josearistidesbail/FE_UFPR_4_0/OPEN_ITEMS.md

# FE_UFPR v4.0 — Open items

Owner in brackets. **When an item is resolved, move it to the Resolved section** (struck through,
one line saying how and in which session) and log the decision in `DECISION_LOG.md`.
Keep the Open section short enough to read every session.

## Open

- ~~[user, NEXT — blocks the fab] Rebuild `fab/` after the 2026-09-24 re-route.~~ — **done 2026-09-24 (`make_package.sh` with KiCad closed: 16 gerber/drill files, CPL 278 parts on origin 96.0,219.9, U1 +31.95 mm in x as expected, JLC stock report unchanged apart from the DT15 lines).** Still open from it: the S12 CPL-rotation preview check, retag, and **review the routed left strip in pcbnew** (branch `dt15-vertical`; the user's first look on 2026-09-24: "looks pretty good"; trace lengths reviewed in `DECISION_LOG.md`): the B.Cu lanes at y 94–98 carry CAN + the 4 switch nets + 5V_VEH under the top edge, the LEM signals run at y 183–190 on F.Cu, ±15 V on B.Cu/F.Cu — DRC-clean but hand-placed by script, not by eye.
- ~~[user, NEXT — blocks the fab] Re-place and re-route J3/J4/J5 after the 2026-09-23 DT15 swap.~~ — **done 2026-09-24 (branch `dt15-vertical`, `DECISION_LOG.md`): board 178 × 130, DRC 0/0/0 + 5 by-design silk.** Original text: **[user, NEXT — blocks the fab] Re-place and re-route J3/J4/J5 after the 2026-09-23 DT15 swap.** The three vertical footprints were dropped at the old right-angle positions/rotations (J3 158.5/169.8 −90°, J4 158.5/124.0 −90°, J5 167.45/96.25 180°): DRC 653 / 18 unconnected / 18 dangling tracks, every one of them from these three. Constraints: body = flange outline 35.26 × 59.21 (J3/J4) / 35.26 × 55.12 (J5) on the board, flange face 15.5 mm up (nothing taller than ~13 mm under it), pins Ø1.57 on 4.445 × 9.12, 4× Ø3.5 NPTH per part for #4-20 Plastite screws driven from the **underside** — heads land on B.Cu inside the footprint's B.CrtYd Ø7.5 circles (keep copper and the 12 B.Cu parts out of them). Pin 1 = bottom-left of the mating face, key end = −y. Then DRC 0, `sh tools/fab/make_package.sh`, retag — the committed `fab/` and `v4.0-fab-candidate` are **stale**.
- **[user, BEFORE FIRST POWER-ON + rev 4.1] F1→Q1 drain link is one 0.25 mm track (found 2026-11-02).** `/power/PWR_24V_FUSED` (F1 pad 2 → Q1 tab) matches no netclass pattern, so it fell to Default and was routed at 0.25 mm (≈2.3 mm exposed between the pads); DRC passes because Default allows it. It carries the whole 24 V input (≈2 A with the module aux at 40 W); short and pad-sunk, so it should survive normal load, but under a fault it may open before F1 (5 A). **Boards in hand:** solder a ≈0.8 mm bare wire (resistor-leg offcut) from F1 pad 2 to the Q1 tab over the track. **Rev 4.1:** add `*PWR_24V_FUSED` to Power_3A and re-route; audit every net in series with a fuse or the 24 V path for the same netclass gap. (The other `/power/PWR_*` nets at 0.25 mm are signal/bias nets — fine.)
- **[user, BEFORE FITTING THE LAUNCHPAD + rev 4.1] D12 (SS34, `+5V` → `+5V_LP`) is drawn backwards (found 2026-11-03 at bring-up A, back-feed test).** Netlist: D12 pin 1 **K → `+5V`**, pin 2 **A → `+5V_LP`**, so the diode conducts LaunchPad → board and blocks board → LaunchPad. Opposite to `ARCHITECTURE.md` §3. JLC placed it exactly as drawn (not an assembly error); the wrong orientation has been in `golden.net` since S8 (the `S8_INTEGRATION_DESIGN.md` net table lists `D12.2` on `+5V_LP`), so the netlist gate could never catch it. Consequences: the board cannot power the LaunchPad, and a LaunchPad with USB 5 V on its target side (JP3 fitted) back-feeds the board `+5V` (D6/D7 light, U3 makes +3V3, and U2's output is driven backwards). A TP45 reading of ≈ 5 V with 24 V on is reverse leakage into C114/C115, not power. D16 (`+5V_VEH`) is the right way round. **Boards in hand** (board 1 done 2026-11-03, diode check passed; board 2 pending): desolder D12 and refit it rotated 180°: cathode band on **pad 2 / `+5V_LP`** (opposite the silk band). Check unpowered: diode mode, red TP3 → black TP45 ≈ 0.2–0.35 V, reversed = open. Then repeat the back-feed test with LaunchPad JP1/JP2/JP3 **out**. **Rev 4.1:** flip D12 in the `launchpad` sheet (A → `+5V`, K → `+5V_LP`), regenerate `golden.net`, check the silk band; audit every other polarised part's net direction against its design note (a netlist diff cannot see this class of error).
- **[user, BEFORE RUNNING THE LAUNCHPAD FROM THE BOARD + rev 4.1] The board never supplies the LaunchPad's 3.3 V (found 2026-11-03 at bring-up A).** `ARCHITECTURE.md` §3 assumed the LaunchPad "makes its own 3.3 V from our 5 V (its TPS7B LDO)". SPRUI77 Fig. 3/4 show it doesn't: the target side has no 5 V → 3.3 V regulator. U17 TPS62162 makes `FTDI_3V3` from USB on the debugger side, JP1 is the only link to the target `+3V3`, and U12 LMR62421 boosts 3.3 → 5 V (JP6), not the reverse. The board feeds only `+5V_LP` and leaves J1-1 / J5-41 (3V3) unconnected (J20.1, J22.1), so with JP1–JP3 out the MCU rail sat at 2.2 V, back-powered through its I/O protection diodes from the board's 3.3 V logic. Brown-out: D1 and D9 lit, no code running. **Bench workaround (no isolation, DB37 unplugged only):** JP1 + JP2 in, JP3 out → target 3.3 V from USB, 5 V from the board via D12. **Boards in hand** (board 1 done 2026-11-03: wire fitted, LaunchPad JP1–JP3 out, boots from 24 V with USB isolated; U3 current and temperature not yet logged; board 2 pending): wire U3 output tab (`+3V3`) → J20 pin 1 (underside; = LaunchPad J1-1), AWG 24–26, ≈ 80 mm; then JP1–JP3 out. With JP1 out nothing is paralleled. U3 then carries ≈ 0.15 A board + 0.2–0.3 A LaunchPad (≈ 0.7–0.8 W in the SOT-223): measure the current and U3's temperature. ⚠ The wire also wakes the LaunchPad's U12 boost (it runs whenever the target 3.3 V is up), the lead suspect for the ADC interference item below. **Rev 4.1:** tie J20.1 to `+3V3` in the `launchpad` sheet; redo the `+3V3` budget (`S3_POWER_DESIGN.md` table: 0.15 A) and U3's thermal design (or a small buck); correct `ARCHITECTURE.md` §3 and the S8 "explicit no-connect" note on J1-1 / J5-41. The 2026-11-03 polarity audit (D12 the only wrong part) took the §3 premise as given, so it didn't check this.
- **[user, BEFORE USING THE INTERNAL CURRENT SENSORS + rev 4.1] The module's current outputs read 0 V at zero current, not 2.5 V (bench item #3, found 2026-11-03 at bring-up E).** Board 1, module powered from the board (0.57 A at 24 V, module LED on), no DC link: DB37 pins 30/31/32 (at C64/C70/C77) and TP30/TP32/TP34 all 0 V, while the module's other analog outputs are alive (Vbus floor 0.12 V on pin 7, NTC 0.62 V on pin 29). S6 assumed a 2.5 V bias (`S6_CURRENT_SENSE_DESIGN.md` §3–§4: bottom of the + divider at GND, gain 0.600); the datasheet gives none. As built, the internal path clips every negative half and is **unusable for control**. No damage either way (op-amp inputs current-limited by 7.5 kΩ, outputs clip at 0 V). Still unknown: bipolar vs one-sided (magnitude/RMS), scale, sign, and each channel's mV offset (not read). **Now:** run step F on the LEM path (JP3–JP5 → 2-3, firmware `ISENSE_V_PER_A_LEM`) and scope DB37 30–32 against the LEMs. **Rework, only if the outputs prove bipolar and instantaneous, per channel:** lift the GND end of the bottom resistor and wire it to `ISNS_VREF` (output centred on 1.4685 V), and swap both 20.0 k input resistors for a matched pair ≈ 40.2 k 0.1 % (gain 0.600 → 0.299: ±4.9 V → 0.01–2.93 V; the 12 k × 2.2 nF feedback pole stays ≈ 6 kHz, no capacitor change). A: R66 (pad 2 = GND) → TP36 or R73's `ISNS_VREF` end, swap R63/R64. B: R79 → R85's `ISNS_VREF` end, swap R75/R78. C: R91 → R97's `ISNS_VREF` end, swap R87/R90. Tune the 40.2 k from the measured scale. Side effects: a disconnected DB37 then reads the bias (as the LEM path does), ≈ 0.2 mA more on U15A. If the outputs are one-sided, no resistor change recovers the sign: internal = monitoring only. **Rev 4.1:** the same change in the schematic (bottom resistor to `ISNS_VREF`, gain from the measured scale); update `S12_FIRMWARE_HANDOFF.md` §6.
- **[rev 4.1] No clamp diodes on `ISNS_A/B/C_ADC`.** U12–U14 run from +5 V, so a stage fault can drive an ADC pin to 5 V through 100 Ω (≈ 11 mA into the MCU pin's ESD diode, rated 2 mA). It happened on board 1 at bring-up E (a U13 joint held `ISNS_B` at 3.5 V, harmless at that level). Add a BAT54S to `+3V3`/GND on each, as D10/D11/D18 do for the encoder and KTY channels.
- **[user, board 2 — and the rest of board 1] Hand-soldered IC joints.** Board 1 had two open GND joints that looked soldered: U6 pin 3 (bring-up B, TP12/TP13 at 1.86 V) and U16 pin 4 (bring-up E, SIN/COS stuck at the clamp). Also a U13 joint (`ISNS_B` stuck at 3.5 V), U16/U17 bridges and flux, and on 2026-11-05 **U17 pin 6, a signal pin** (open; `ENC_VREF_HI` railed, the encoder clipped). GND pins sit on the L2 plane and wick heat: hotter tip or longer dwell. Then a **pin-shoulder-to-pad continuity check on every pin, not only GND**, of every hand-soldered IC (U4, U5–U8, U12–U17) and an IPA clean before power. Board 2: also rotate D12, fit the U3 → J20.1 wire, and bridge JP3–JP5 **2-3** (the tracker still says 1-2) until the internal-path rework exists.
- **[user] Board 1 bring-up still open (updated 2026-11-05):** D17 diode check on J5 pin 2; start input (J5 4/5 → `sw_in` = 3); D in both directions for OC C (pull pin 5 → OSHT3 only) and OT/OV (jumper 6, 16 → `module_fault` 0x00); Vbus calibration (item below). Done: ~~LEM swap and zero~~ (2026-11-04, zero at 1996 codes), ~~encoder by hand~~ (2026-11-05, after the U17 reflow), F started (ALIGN + closed-loop current at 31 V, 2026-11-05). F at higher bus voltage and the loaded tests follow the firmware plan (firmware `CLAUDE.md`). Results so far: `VERIFIED_FACTS.md` § Bench, board 1. **Plug the encoder in only with the board unpowered** (a hot-plug drops the XDS100).
- **[user, deferred by the user 2026-11-05] ADC interference: ≈ 5 codes rms, one ≈ 1.6 MHz source shared by every ADC input** (`VERIFIED_FACTS.md` § Bench, board 1). The firmware works around it for the currents (same-slot sampling + three-sensor Clarke, zero sequence removed before the dead-time comp), but SIN/COS keep ≈ 2.6° electrical of angle noise from it. Lead suspect: the LaunchPad's U12 (LMR62421X, 1.6 MHz boost), woken by the 3V3 rework wire. The user won't modify the LaunchPad for now; revisit if the noise becomes a problem. **Kill test:** board off, tie LaunchPad U12 pin 4 (SD), or R14's non-3V3 pad, to LaunchPad GND; re-capture with the encoder plugged and unplugged. If it doesn't move, next splits: a burst capture for the exact frequency, the DB37 unplugged at the module, LaunchPad J3-23 (ADCIN14) jumpered to J3-22. **Rev 4.1:** if U12 is confirmed, decide with the 3V3-feed redesign (item above) whether to live with it (firmware workaround) or make "disable the LaunchPad's U12" a documented assembly step; the board itself can't reach its SD pin.
- **[user, BEFORE HV] Vbus reads about 4× low** (77 codes at 31 V, 46–48 with the link off; ≈ 52 mV at DB37 pin 7 against 224 mV expected). Probably the module sensor's low-end non-linearity (same signature on the old Control_V2 board), not the R57/R58 path. Meter TP19–TP21 with the link on and off to tell them apart, then run `vbuscal` from metered points ≥ 40 V (or at the operating bus) and bake `VBUS_DIVIDER_RATIO` / `VBUS_OFFSET_CODE`. Until then the firmware runs on `vbus_ovr` = 31, which must equal the real link.
- **[team] Harness side of the DT15 swap (TE sample program, checked 2026-09-23):** sampleable — DT06-12SA (J3 plug), W12S, W8S, contacts 0462-201-16141 (solid) / 1062-16-0122 (stamped), DT06-08SA; **not sampleable** — DT06-12SB (J4, key B) and DT06-08SD (J5, key D), and the J4 header DT15-12PB itself. Decide: buy those three, or re-key (J4 → a 12-way key A loses the ±15 V guard; J5 → DT15-08PA, plug sampleable, header not). Size-16 contacts need the DT crimp tool, not the DTM one.
- **[team] Screws for the DT15 headers:** 12× #4-20 Plastite 48 thread-forming (M3.12 × 1.27), pan head, 0.45–1.01 N·m per the drawing; plus 2× #6-19 (Ø3.1 / Ø3.3 flange holes) per connector only if a panel is ever used. Not included with the parts.
- **[user, cosmetic] `kicad-cli sch export netlist` warns "schematic has annotation errors" — on the committed `a077914` sheets too**, so it predates the swap. ERC is clean; find what kicad-cli objects to (probably a duplicate/unset annotation in a power symbol) and clear it.
- **[user, S11] H2 screw hardware.** H1–H4 are now Ø4.3 mm M4 (`MountingHole_4.3mm_M4_ISO7380`); at H2 the button-head courtyard (r 4.05) clears Q1's courtyard by 0.2 mm, but a Ø9 mm M4 washer would reach within 0.1 mm of Q1's tab pad. Use button/cheese-head screws without washers at H2, or move Q1 ≥ 0.5 mm down (re-route its two tracks) before ordering hardware. Other holes: nearest part ≥ 4.8 mm (H3 C94), J5 5.9 mm (H1).
- **[user, BEFORE PAYING the JLC order] CPL rotation offsets are seeded, not verified** (`tools/fab/jlc_rotations.json`, community table). Confirm every non-passive family on JLC's placement preview (`S12_FAB_PACKAGE.md` §3 lists them; D17 is the only polarised bottom part), write the confirmed offsets into the table, re-run `tools/fab/make_package.sh`, re-upload the CPL, then tag `v4.0-release`. `C77033` 2.2 nF C0G stock 2 265 for 50 and U4 `C5369735` 304 for 5 — re-run the script on order day.
- **[team, before assembly arrives] Buy the hand-solder parts** (a team member buys them in China — no import) per `fab/FE_UFPR_4_0_HANDSOLDER_BOM.csv` (2 boards assembled, quantities for 3): 18× OPA2376AIDR `C46316`, 3× URA2415YMD-6WR3 `C5369735` (304 in stock 2026-09-23), 12× 2×10 header `C492427` (or any 2.54 mm 2×10 male), the 12 bottom-side passives/TVS (3 sets), **and since 2026-09-26 the 14 fee-cut parts ×3: C1 100 µF `C2836439`, F1 `C48467`, F2 `C182445`, F3 `C7542932`, L3 `C88056`, U8 `C22046`, Q1 `C3281500`, U5–U7 UCC27524DR `C465729`, R57/R105 3.00 k 0.1 % `C136963`, R58/R129 2.20 k 0.1 % `C861295`** (0.1 % values are unmarked — keep each on its own tape), plus the five connectors (3 each) (J1 Mini-Fit Jr, J2 DB37 socket + 4-40 jackscrews, J3/J4/J5 — **now DT15-12PA / DT15-12PB / DT15-08PD with DT06 plugs, W12S/W8S wedgelocks and size-16 contacts, mostly TE samples** — see the DT15 items above; the CSV was rebuilt 2026-09-24).
- **[S12] Silk: 49 passive references are hidden** (36 R, 13 C — `prefab_s11.applied.json` + C44 in `tp_labels.applied.json`); the CPL and F.Fab carry them. Test points show their net name instead of `TPxx` (TP2/TP28/TP32 keep `TPxx`) — **mapped in `S12_FAB_PACKAGE.md` §6.** R24's outline crosses J2's (3 cosmetic warnings), J2/J5 bodies overhang the edge by design (4).
- **[user] Test points under the LaunchPad shadow** (TP16, TP22, TP27, TP30–TP34, TP47) are unreachable with it fitted — pull out or accept.

- **[user / team — GATES MECHANICAL, affects S10/S11 placement] Board orientation is re-opened (2026-09-17).** S9.6 placed the board **vertical** above the PrimeSTACK (DB37 edge down, 90° adapter to X1, LaunchPad above on male headers, J5 top-left) and `CLAUDE.md` asserted that as settled; the team is **not** decided and **horizontal is still on the table**. Until it lands, the board is kept orientation-agnostic:
  - **Every connector stays on the top face** (already true — J1/DB37, J3, J4, J5, the LaunchPad headers). Do not move any of them to B.Cu.
  - **Passives are dimensioned off their own connector/IC pins**, never off a board edge or a mount feature, so they travel with the part under either orientation.
  - **B.Cu is treated as the module-facing side** (qualified 2026-09-17 — see the last bullet): keep it as continuous copper as practical and add nothing there that a mount change would strand. This is what killed the back-side option for the connector rail caps (C97/C98 at J4-1, C92–C95 at J3-1/5) — the back side would have bought ≈1.1 nH vs ≈3.8 nH of loop, but it punches holes in the face that looks at the IGBTs in a horizontal mount. They go **top side, outboard of the connector courtyard**, fed with short wide track; the real cable-entry defence is the series R + 1 nF per signal pin (S7 §6 / S4's DB37 network), not the rail cap.
  - **No bracket, mounting-hole or adapter-plate work** until the decision is made. **H5–H9 (the mid-edge pair and the three LaunchPad standoffs) were deleted by the user during the 2026-09-17 re-placement; H1–H4 remain (M4 ISO 7380 button-head since S11, user). [user] confirm once the orientation lands — as placed, the LaunchPad hangs on its 80 header pins alone.**
  - **Decided 2026-09-17 (user): 12 parts stay on B.Cu** — R2/R3 (under U1), D17/C119 (under J5), C25–C28 (U4 ±15 V caps, under J3's pins), R118/R119/C113 (J4 shield tie) and C120 (KTY 1 nF) under J4. Assembly will be ordered two-sided or the 12 hand-soldered. "Module-facing B.Cu" now means: keep the *rest* of B.Cu continuous.

- **[user] DB37 purchasable MPN** for the consigned list. **S9 placed the board edge 9.40 mm from pin row 1 (KiCad's footprint); 3.0's as-built part sat at 12.07 mm** — a longer-offset part merely protrudes 2.7 mm, a shorter one on a 12.07 board would be recessed and its plug hood would hit the edge, which is why 9.40 was chosen; confirm with the MPN. Geometry (female, right-angle, 2.77 × 2.54 mm, 63.5 mm jackscrews) is de-facto validated by 3.0 mating the real harness **and now by the datasheet's "X1 = 37 contacts, SUB-D, male" with UNC 4-40 female thread** — only the buyable part number is open. If the team ever switches to a *vertical* part, the row pitch becomes 2.84 mm and the footprint must be re-derived.
- ~~[S12] Re-verify `C5369735`~~ — **S12: 304 in stock on 2026-09-23, U4 stays a JLC-placed line (user).** Re-run `tools/fab/make_package.sh` on order day; if 0, consign + hand-solder.
- **[user, before S12] DB37 hardware:** the module end is SUB-D 37 **male with UNC 4-40 female threads**, so the harness end that mates our socket needs matching jackscrews. Confirm the board-side hardware with the purchasable MPN.
- ~~[user, BEFORE any harness is crimped] Confirm the DTM cavity numbering on J3/J4 (12-way) AND J5 (8-way)~~ — **moot 2026-09-23: the DT15 drawings print the cavity numbers (12-way: sheet 1; 8-way: sheets 1–2) and the footprints follow them.** Original text: — the 8-way drawing labels its cavities and S8 mapped them through the section view, but a real `DTM06-08SA` settles it. Original 12-way item: against the molded numbers on a real `DTM06-12SA`/`-12SB`. TE's 12-way drawing does not label them; S7's 1–6 / 12–7 order is extrapolated from the 8-way drawing of the same family. Board, symbol and footprint are self-consistent either way — only the harness mapping is at risk.
- ~~[user / S9] The DTM13 mounting feature~~ — **moot 2026-09-23 (DTM13 parts replaced by DT15; their footprints stay in the library unused).** Original text: — the drawing's Ø2.01 mm feature is ambiguous between a plastic locating peg and an M2 screw hole. The footprint uses Ø2.2 mm NPTH, which serves either; confirm against a real part before S9 finalises mechanical.
- ~~[S12] DTM contacts and wedgelocks are consigned~~ — **S12: listed on `fab/README.md` (team supplies).**
- **[user, LEM board] Interface contract:** the remote board needs three LA 100-P, ±15 V / `ISO_COM` decoupling, and wiring — **and must not carry burden resistors.** Both burdens per channel are on this board by design.
- ~~[S12 firmware] `LEM_V_PER_A` is self-contradictory by 10× in `hw_control_v2.h`~~ — **S12: both figures belong to the bench Control_V2 board; the handoff replaces them with per-source `ISENSE_V_PER_A_INTERNAL 0.004800` / `_LEM 0.004886` (`S12_FIRMWARE_HANDOFF.md` §6).**
- **[S10/S11] Reclaim ADC range after bench item #3.** If the module's sensors measure 5.66 mV/A rather than 8.00, the internal stages use only 70 % of the ADC span; one resistor per channel (R65/R76/R88) fixes it. No other change.
- **[S12 firmware] `FAULT_OC_A/B/C` do not identify the faulting phase** — any leg's OC asserts all three. Implement the decode table in `S5_MODULE_STATUS_DESIGN.md` §1.2, and note the module does **not** self-shutdown on over-temperature.
- **[cosmetic, any session] A3 title-block `Title` field overflows its box on all seven sheets** — the S1 sheet titles are longer than the block. Harmless on screen, visible in PDF/print.
- **[user, 1 min] Attach the 3D models to the live board:** the library and `3dmodels/` are done (2026-09-17), but pcbnew had the board open, so the board instances were only verified on a copy. Close the PCB editor, run `python3 tools/board_layout/attach_3d_models.py`, reopen. Then `kicad-cli pcb render` shows every body (see `TOOLING_NOTES.md`). Note the render also shows the parts still parked off-board and the current open-outline gap at the top-left edge (61.3 mm, DRC `invalid_outline`).
- **[S12, optional] Replace the hand-built STEP bodies with vendor files** — TE (`ENG_CVM_CVM_DT15-12PA_E.3d_stp.zip`, `ENG_CVM_CVM_DT15-08PD_F.3d_stp.zip` on the product pages — download through the logged-in browser, the save dialog needs a click; the DTM13 bodies are unused since 2026-09-23), Mornsun URA2415YMD-6WR3, TDK ACT45B, and TI's LAUNCHXL-F28379D STEP for the J20 shadow (currently a 129.9 × 58.4 slab + sockets). Drop them into `3dmodels/` under the same names and nothing else changes. The DB37 footprint still points at KiCad's `…_EdgePinOffset9.40mm.step` (correct body, name differs from the footprint) — harmless.
- **[user / ECU team] Confirm the three PROVISIONAL S8 interface decisions** — (a) is the logic 24 V really an external battery unbonded from car GND? (b) does the barrier stay on the ECU side? (c) is their isolated bus side powered from our `+5V` or from an integrated DC/DC? The board is drawn correct either way, but the `+5V` budget, the harness pin count and the connector freeze all depend on (c).
- **[user / ECU team] `+5V_VEH` delivers 4.6–4.75 V** (SS34 back-feed block) — ISO1042/ISOW1044 class only, not ISO1050. Part of the three provisional S8 decisions to confirm.
- **[user] Shutdown-circuit / GLV voltage is assumed 12 V** (from the AM06 ECU's +12 V supply). Designed for 8–30 V; at 24 V GLV change R123/R124/R126/R127 to 3.3 kΩ.
- **[S12] The two JLCSearch endpoints disagree on stock for every part** (`/api/search` vs `<category>/list`). Verify the 2.2 nF C0G line (`C77033`, formerly `C107043`) and the four low-stock lines against JLCPCB itself before ordering.
- **[cosmetic] `current_sense`** — the upward `ISO_COM` flags on R68/R69/C65/R73/C67 cross the wire of the row above (pre-existing S7.5 crowding, not touched in S8).
- **[user, before S12] Verify the LaunchPad outline and hole positions** measured in S9 (`S9_BOARD_SETUP.md` §1.1: 129.9 × 58.4 mm, corner holes 124.6 × 53.4, J1-pin-1 31.9 mm from the USB edge) with a caliper on the real board; `H7`–`H9` are Ø3.2 and tolerate ±0.5 mm.
- **[S10] `Power_3A` on inner layers is 1.1 A at 1.2 mm** — `+24V_*` / `PGND_MOD` on outer layers or ≥ 5 mm L3 pours.
- **[user, BLOCKING S9.5] EMRAX insulation class for the KTY81-210** — reinforced/double per EN 61800-5-1 at 600 V DC, or only basic? Decides whether the motor-temperature channel may share J4 at all (FSAE EV.6.5.3). See `S9_5_MOTOR_TEMP_DESIGN.md` §6.
- **[user] Confirm the installed motor sensor is a KTY81-210, not a PT1000** — measure cold: ≈2.0 kΩ = KTY81-2xx, ≈1.1 kΩ = PT1000, ≈110 Ω = PT100. NXP discontinued the KTY81 and newer EMRAX builds ship PT1000; R129 would be re-picked.
- **[user] `SHIELD_ENC` is hard-tied to GND by R119 (fitted 0 Ω).** If the RM44AC's cable shield bonds to its readhead body, and the readhead to the motor frame, the board's "floating island" is already chassis-referenced. Check the RLS spec; if so, unfit R119 and keep the 1 MΩ ∥ 1 nF soft tie.
- **[S10] Route `+5V_VEH` and `CAN_RS`** — both had zero pad assignments on the board until S9.5; the router never saw them.
- **[user] Pick the L-com DG9037MF variant** (male end must exit away from the module top face with the female end on X1) and check its ~25 mm body against the phase terminals; fallback = passive two-D-sub adapter PCB. **Bracket the board** — the two jackscrew joints carry no load. Height budget above the module: adapter ~25 + board 130 + LaunchPad overhang 17.9 mm.
- **[S12] Verify C492427** (male 2×10 header) — Extended, 98 935 by `/api/search`; the `headers/list` endpoint did not surface it.

## Resolved (archive)

- ~~[bench, optional] Measure the installed encoder's amplitude at the connector~~ — **done 2026-11-05 (bring-up, board 1): ≈ 2.0 Vpp** (amplitude ≈ 1583 codes at the ADC, 77 % of the range). The `S7_ENCODER_DESIGN.md` §9.1 gain bump (G 1.30) would add only ≈ 8 % amplitude (≈ 0.7 dB), and the angle noise is set by the shared ADC interference, not by the amplitude: not worth fitting.
- ~~[S12 firmware] Phase-current A/C ADC channels swapped on the board (2026-09-22)~~ — **done in firmware (§13, `7807299`: Iu = ADCINA5, Iw = ADCINB4), bench-confirmed** by the 2026-11-04 LEM loop test (only ADCINA5 moved) and the 2026-11-05 phase ID (map A → U, B → V, C → W, no inversion). Since `5432839` all three currents convert in the same SOC slot (`S12_FIRMWARE_HANDOFF.md` §5).

- ~~[firmware] Apply `S12_FIRMWARE_HANDOFF.md` §13~~ — **done 2026-11-03 in the firmware repo (`7807299`, fixes `308a542`)** and used for bring-up B–E. The handoff's "invert the Input X-BAR polarity" is impossible on the F2837xD (no polarity control); the fault pads are inverted in the GPIO stage instead (GPxINV, firmware `MODULE_FAULT_PAD_INVERT`). Bench-only items: handoff §14.
- ~~[user, S10] ERC `power_pin_not_driven` U4 pin 1~~ — **resolved S11:** `PWR_FLAG` #FLG07 on `PGND_MOD` at the NT2 star (`tools/schematic_layout/add_pwr_flag_pgnd.py`); ERC 0, netlist unchanged.
- ~~[S11] H1–H4 `extra_footprint` parity warnings~~ — **resolved S11:** `board_only` on all four, and M3 → M4 (`MountingHole_4.3mm_M4_ISO7380`) at the user's request (`prefab_s11.py`).
- ~~[user, S11] Spare `+5V` via at (208.34, 181.40)~~ — **resolved S11:** deleted.
- ~~[S11] Silkscreen text `MOTOR CONTROLLER V3`~~ — **resolved S11:** `FE_UFPR 4.0 - FSAE - 2026-09` (F) / `FE_UFPR 4.0 - FORMULA UFPR` (B).
- ~~[S11] 368 silk warnings (reference designators)~~ — **resolved S11:** every reference re-placed by search, 52 hidden where nothing fits; 368 → 7 (all by design/cosmetic, see Open).
- ~~[user, S11] Net-name silk labels on the test points?~~ — **resolved S11 (user's go, 2026-09-23):** applied with `prefab_s11.py --tp-only --tp-labels=only` + `tp_db37_labels.py` (`tp_labels.applied.json`): 36 full net names, the DB37 PWM row as `PWM 15V` / `WH WL VH VL UH UL`, `VBUS` / `RTN` / `NTC` on TP19/TP21/TP22, TP2/TP28/TP32 keep `TPxx`. DRC unchanged (7 warnings).
- ~~[user, S10] `ISNS_B_RAW` vs TP33 clearance, `SW_MAIN_3V3` open, the six routing gaps~~ — **closed by the user 2026-09-23.**
- ~~[user, S10] 33 `starved_thermal` errors~~ — **resolved 2026-09-23 by the S11 stitching pass** (`tools/board_layout/stitch_s11.py`: 326 GND/thermal vias + 154 stubs, +13V5 via array moved, six net-less vias assigned; three floating GND pins U8.2/U11.3/C107.2 fixed) plus a `min_resolved_spokes 1` waiver for C11/C13/L2/U17 in the `.kicad_dru`. DRC 0 errors / 0 unconnected. `S11_PREFAB_REVIEW.md`.
- ~~[user] Find what rolled `.kicad_pro` back twice~~ — **found 2026-09-23: KiCad 10 Local History restores from a corrupt `.history/` repo (S7-era files), plus the MCP backend's stale project model on board saves.** Local History disabled, repo renamed, `_restore_backup*/` ignored and untracked, `FE_UFPR_4_0.kicad_sym` restored from the 2026-09-22 backup (60 units render, ERC 0 lib issues, netlist IDENTICAL). Details: `TOOLING_NOTES.md`, `DECISION_LOG.md` 2026-09-23.
- ~~[user, S10] Refill zones (B) on first open~~ — done: DRC on `cbd091b` gives identical counts with and without `--refill-zones`.
- ~~[user, S10] Tighten placement per `S10_PLACEMENT_REVIEW.md` §B~~ — **applied 2026-09-17 by `tools/board_layout/tighten_s10.py`** (review §D): entry caps 2.3–7.6 mm from their pins, all eleven ADC buckets 3.1 mm from the header pads (SIN/COS identical), U18 100 nF 2.4 mm, U1 CIN 2.4 mm, R34 at D9, JP1 out of the shadow. DRC 0 errors, courtyards 0. Left as-is: U15↔ISNS_VREF caps ≈32 mm, U1 SW→L1 6.7 mm, D9 on the bottom edge, TP30–35 under the LaunchPad. **[user] review in the GUI; `9802b1b` is the pre-move state.**
- ~~[BLOCKS S10 ROUTING] netclass regression in `.kicad_pro`~~ — **resolved 2026-09-17 (pre-S10 validation):** `CAN` class + `*PWM_*_3V3` / `*CAN_H*` / `*CAN_L*` / `*MOT_TEMP_*` re-added; `kicad-cli` `(class …)` output = Analog 61 / CAN 4 / Gate 23 / Power_1A 9 / Power_3A 5 / Default 117. The same 15:06 restore had also dropped the six S8 symbols from `FE_UFPR_4_0.kicad_sym` — restored from `9cf0c5a`, ERC 0 — **and reset the board rule minimums to KiCad defaults** (hole-to-hole 0.25, annular 0.10, clearance 0): S9 `rules` block restored from the backup the same day, DRC 0 errors. Details: `DECISION_LOG.md` 2026-09-17 pre-S10 entries.

- ~~[team] Precharge / DC-bus contactor~~ — **dropped 2026-09-17 (user):** precharge is handled externally; nothing on this board, no relay, no connector, S8 not reopened. The "24 V coil vs GLV voltage" question goes with it (the separate 12 V shutdown-input assumption stays open).
- ~~[S2] BoosterPack header gender~~ — **resolved S2:** `PinSocket_2x10`, bottom side, LaunchPad below.
- ~~[S9] PrimeSTACK mounting pattern~~ — **resolved S9:** M8 × 14 deep on **143.2 × 242.6**, Ø9.2 through (Ø17 × 11 counterbore) on **195 × 260**, both centred on the 215 × 280 body. Both dwarf the 146 × 130 board → **adapter plate confirmed** as the mechanism. **[user] The top face carries the HV busbar terminals — set the plate's standoff height for creepage.**
- ~~[S3] Schottky vs ideal-diode/load-switch for the LaunchPad 5 V feed~~ — **resolved S3:** plain Schottky **SS34, C8678 (JLC Basic)**; V_f ≈ 0.35 V at ~200 mA leaves the LaunchPad ≈4.63 V, ample for its own 3.3 V LDO. **Physically placed in S8** on the `launchpad` sheet at the header.
- ~~[S3] X5R vs X7R for bulk rails~~ — **resolved S3:** X7R wherever a Basic/Preferred X7R exists at the needed value (100 nF, 47 nF, 1 µF); X5R for the bulk ≥4.7 µF where JLC Basic offers nothing else, with ≥2× voltage derating (50 V parts on the 24 V rail, 25 V parts on 5 V/3V3). AMS1117 dissipates 0.25 W → ≈85 °C junction at the 70 °C worst-case local ambient.
- ~~[S7] Standardise C0G filter values~~ — **resolved S7: the set stays at exactly four.** 1 nF `C106246` (EMC at connectors), 2.2 nF `C107043` and 4.7 nF `C85980` (active anti-alias poles), 22 nF 0805 `C77069` (ADC charge buckets). S5, S6 and S7 each added none; S7's matched SIN/COS RCs are 2.2 nF and its buckets 22 nF.
- ~~[S8] CAN GPIO pair~~ — **resolved S8: `CAN_TX_3V3` = GPIO4 (J4-36), `CAN_RX_3V3` = GPIO5 (J4-35), on CAN-A.** CAN-B turned out to be *unroutable*, not merely inconvenient. The LaunchPad's own transceiver is on CAN-B via GPIO12/GPIO17, neither of which reaches a header, so it can never contend.
- ~~[S4] `+24V_MOD` land it on DB37 pins 8/26~~ — **done S4** (pins 8/26 per the datasheet; return on 10/28 as `PGND_MOD`).
- ~~[S4] Series damping resistor ≤100 Ω~~ — **resolved S4: 100 Ω (R18–R23)**, with the datasheet's 10 kΩ + 1 nF input network fitted at the connector. Module sees 12.95–13.62 V.
- ~~[S4] FSAE shutdown-circuit interlock on the gate enable~~ — **resolved S4 (user):** 3-input AND with `SW_MAIN_3V3`, bypassable by the exclusive jumper JP1.
- ~~[S5] Fault pull-up value~~ — **resolved S5: 4.7 kΩ to `+13V5_GATE`** (2.84 mA sink), then 10 k/4.7 k into an SN74LVC2G17 Schmitt. 2.45 V / 2.91 V of noise margin referred to the DB37 pin.
- ~~[S5] `NTC_1_RAW` divider must survive 10 V~~ — **resolved S5: 12 k / 4.7 k**, 10.000 V → 2.814 V (93.8 % range), clips at 10.66 V, 0.60 mA load. ADC pin `ADCINC3` (J3-24).
- ~~[S8] `vehicle_io` must produce `SW_MAIN_3V3` as a clean 3.3 V logic level~~ — **done S8:** opto → 2.2 k pull-down → Schmitt buffer, fail-safe LOW, no RC on the path.
- ~~[cosmetic, any session] `power` and `current_sense` sheet readability~~ — **resolved S7.5.** The S6 objection ("a bulk move risks silently detaching a verified netlist") was answered by building the safety net first, not by avoiding the move: an independent geometry→connectivity engine plus an order-insensitive netlist fingerprint diffed against a golden `kicad-cli` export. Every sheet was re-drawn and re-verified **149 nets / 745 nodes identical**.
- ~~[S6] Third current channel~~ — **resolved S6: `ISNS_C_ADC` = ADCINA5 (J7-66), suggested ADC-A SOC1.** Puts the whole current block on five contiguous J7 pins (65–69) across three converters.
- ~~[S6] LA 100-P ±150 A range vs the 260 A SW trip~~ — **resolved S6 (user): accept.** LEM path is a validation instrument; see the SAFETY decision above.
- ~~[S6] Offset-ref outputs ADCINA4/B5 keep or drop~~ — **resolved S6: KEEP**, both reading the buffered `ISNS_VREF` on two different converters.
- ~~[S6] LEM mounting location + secondary connector~~ — **resolved S6 (user): remote sensor board, one global 8-way connector.**
- ~~[user / S7] Key or size the LEM connector differently from the encoder connector~~ — **resolved S7, and better than by size:** both are DTM13-12P-R005, J3 **key A** and J4 **key B**. A key-A plug physically cannot enter a key-B receptacle, so the ±15 V-into-an-RM44AC hazard is prevented by the connector itself and survives any future re-pinning of either harness.
- ~~[user, if wanted] Board-mounted Deutsch instead of J3's Micro-Fit~~ — **done S7.** The drawing was never gated (see the S7 decision log); J3 is now `DTM13-12PA-R005`, footprint hand-derived from TE's dimensioned drawing, netlist re-verified pin-by-pin.
- ~~[S12] Verify `C3294385`~~ — **moot S7:** J3 no longer uses the Micro-Fit clone. The symbol `Conn_02x04_Odd_Even` and the footprint `Molex_Micro-Fit_3.0_43045-0800_2x04_P3.00mm_Horizontal` remain in the libraries, now **unused**.
- ~~[S9] Board edge budget~~ — **resolved S9: outline grew to 146 × 130 mm.** Both 12-ways stack on the left edge (y 9–50 and 58–100) with the mid-left hole between them; the isolated ±15 V island sits below the LEM connector.
- ~~[cosmetic, project-wide] Hierarchical labels carry no wire stub on any sheet~~ — **resolved S7.5: all five populated sheets re-drawn.** Every label now sits on a wire; project ERC 66 → 40 and **all five sub-sheets are ERC-clean of every class**. The 40 that remain are root-sheet labels for `launchpad` / `vehicle_io`, which S8 fills.
- ~~[S8] Vehicle connector must not be a third look-alike 12-way~~ — **resolved S8: J5 = `DTM13-08PA-R004`, keyed by way-count.** Keys C/D and the DT13 board mounts do not exist in TE's repository (re-probed).
- ~~[S9] J5 board edge~~ — **done S9:** J5's `Dwgs.User` line lies on the top edge; pin field x 65.7–78.3, flange off-board x 21–90, 2.8 mm below the board's bottom face (the LaunchPad's top surface is 11 mm below — clear). **[user] J5 retention** is still only its eight pins — bracket the four flange slots (off-board, x 25.5 / 49.7 from the pin-field centre, z ±15.4). **S9.6: J5 is now at the top-left (pin-field centre x 39.5); one flange ear protrudes 11.7 mm past the board's top-left corner.**
- ~~[S9] CAN netclass~~ — **resolved S9: class `CAN`** (0.40/0.30, diff-pair 0.40/0.30) on `*CAN_H*`/`*CAN_L*`, 4 nets. **[S11] route as a pair** U18 → L3 → J5 with D13 and R122 at the connector; D13/R122/JP6 are placed at J5's CAN end.
- ~~[S9] `*PWM_*_3V3` has no netclass pattern~~ — **resolved S9:** pattern added → Gate (23 Gate nets), verified from the `kicad-cli` netlist.
- ~~[user / S12] Confirm the 2×10 socket insulator height (C5116528)~~ — **moot S9.6:** the receptacles are the LaunchPad's own; our part is the male header C492427. **[user] Caliper the LaunchPad's receptacle height** instead — it sets the ~11 mm stack and the H7–H9 standoff length.
- ~~[S10] Pull C120 to J4's cavity-6 pad~~ — **S9.6:** the motor-temperature block now sits beside J4 (board-local x 40–64, y 48–56); C120 is at (44.9, 48.7). Fine-placement is the user's during routing.
