josearistidesbail/FE_UFPR_4_0/DECISION_LOG.md

# FE_UFPR v4.0 — Decision log

Append-only: `date — session — decision — rationale`. Newest at the bottom.
**This file is where history goes** — `CLAUDE.md` holds only the *current* state and links here.
(Moved out of `CLAUDE.md` on 2026-09-17, verbatim.)

## Entries

- 2026-08-18 — S0 — **Fresh project `FE_UFPR_4_0`**, hierarchical sheets, clean libs. 3.0's lib refs are all broken (survives on embedded caches) and every block changes anyway.
- 2026-08-18 — S0 — **4-layer** (Sig/GND/Pwr/Sig, JLC04161H-7628). Unbroken GND reference under all analog is the single biggest noise fix; JLC 4-layer cost delta is small.
- 2026-08-18 — S0 — External current sensor = **LEM LA 100-P** (±15 V supply, 1:2000 current output). ⚠ Its ±150 A range vs the 260 A SW OC trip must be resolved in S6 (accept for testing vs upgrade to LA 200-P/305-S class).
- 2026-08-18 — S0 — Internal/external sensor selection via **solder jumpers** per channel (no active parts in signal path, vibration-immune).
- 2026-08-18 — S0 — **All 3 phase-current channels** conditioned identically (3.0 left phase C, DB37 pin 32, dangling; firmware can adopt Iw later without a board spin).
- 2026-08-18 — S0 — **CAN transceiver added** (TCAN33x/SN65HVD23x class, termination jumper, team-standard connector) — FSAE vehicle integration.
- 2026-08-18 — S0 — **Mechanical:** mounts on top of the inverter; outline free, holes per PrimeSTACK top-face drawing.
- 2026-08-18 — S0 — **Power entry: Mini-Fit + Deutsch DT, barrel jack dropped.** Board passes 24 V aux to the module via DB37 pins 8/26 — entry connectors must be rated for the stack's 40 W aux (~1.7 A @ 24 V) plus board draw.
- 2026-08-18 — S0 — Finding: **A2415SDL-2W (±66 mA) is undersized for two closed-loop LA 100-P** (~50 mA RMS compensation/sensor at 100 Arms + ~10 mA idle each). Resolve in S3: one 2 W module per sensor, one 5 W module, or drop isolation (LEM secondary is already galvanically isolated from the primary).
- 2026-08-18 — S1 — **Project created.** A3 root + 7 A3 sub-sheets (`power`, `gate_drive`, `module_status`, `current_sense`, `encoder`, `launchpad`, `vehicle_io`), all title-blocked. ERC on the empty hierarchy: **0 errors / 0 warnings**.
- 2026-08-18 — S1 — **Single project symbol + footprint lib**, registered project-scope with `${KIPRJMOD}`-relative URIs; standard KiCad parts re-exported, never referenced. Validated by full KiCad parse (28/28 symbols, 19/19 footprints render).
- 2026-08-18 — S1 — **3.0's `F37HP` DB37 footprint REJECTED, not salvaged.** Eagle's mil-grid quantization left the contact pitch alternating 2.7686 / 2.7432 mm instead of a uniform 2.769 mm, so pin1→pin19 spans 49.6824 mm against the correct 49.86 mm — 0.18 mm cumulative, ~0.09 mm of position error at each end of a 1.016 mm drill. Handedness *is* correct (it is genuinely a female DC-37) and the jackscrew spacing *is* the standard 63.5 mm, so only the pitch was wrong. Replaced by `DSUB-37_Socket_Horizontal_P2.77x2.54mm_MountingHoles`, derived from KiCad's dimensionally-exact generated footprint plus two Ø3.2 mm `SH` shell pads at ±31.75 mm.
- 2026-08-18 — S1 — **BoosterPack grid re-verified against the 3.0 board itself:** headers at X 127.064 / 170.244 and Y 51.372 / 114.872 mm, all rotated −90° ⇒ **ΔX 43.18 mm, ΔY 63.5 mm** exactly (= 1.700″ × 2.500″). Carried into S9 verbatim. 3.0's own `2X10` footprint is a clean, defect-free 2.54 mm grid; replaced by KiCad standards anyway for consistency.
- 2026-08-18 — S1 — **Both `PinHeader_2x10` and `PinSocket_2x10` imported.** Pad geometry is identical, so the gender choice is purely mechanical (does the LaunchPad sit above or below?) and is deferred to S2's floorplan without any risk to S1's foundation.
- 2026-08-18 — S1 — **DB37 symbol is numbered 1–37 + G1/G2, not functionally named.** The functional pin table is S4/S5/S6 scope and partly blocked on bench data; 3.0's as-built map is recorded above as reference only so nothing unverified gets baked into a library part.
- 2026-08-18 — S1 — **Capacitor sourcing constraints logged** (no Basic C0G >100 pF; C0G ceiling ~10 nF/0603, ~22 nF/0805; Basic bulk is X5R not X7R). These change how S5–S7 build anti-alias filters and how S3 picks bulk caps — see the numbered list above.
- 2026-08-18 — S1 — **Netclasses + track/via presets + 14 netclass patterns written to `.kicad_pro`** per the conventions above, as S1 baselines for S9 to re-derive.
- 2026-08-25 — S2 — **LaunchPad power policy:** board feeds 5 V into the BoosterPack 5 V pins through a series Schottky (part in S3); silkscreen jumper table **JP1✗ JP2✗ JP3✗ JP4✓ JP5✓ JP6✗** = TI's documented external-power config (SPRUI77 §5.2; removing JP2 opens USB *GND* too → debugger fully isolated). LaunchPad regenerates its own 3.3 V; header 3V3 pins left NC (no paralleled regulators); board carries its own small 3V3 LDO so CAN/fault logic run with the LaunchPad unplugged. Never both sources hard-paralleled — the 3.0 failure mode this replaces.
- 2026-08-25 — S2 — **GPIO131 confirmed on header J6-58** (GPIO66 J6-59, GPIO130 J6-57) from SPRUI77 Table 4 — bench item #11 drops to a continuity sanity check; bench item #10 becomes verification of documented jumper behavior.
- 2026-08-25 — S2 — **Grounding frozen** (ARCHITECTURE.md §4): one GND net + L2 plane; star at 24 V entry; DB37 aux return (pins 10/28) on dedicated copper to the star; Kelvin pairs `VBUS_SNS_RAW`+`VBUS_RTN` and `ISNS_*_RAW`+`ISNS_RTN` exist as sheet-level nets from day one; every deliberate GND junction is a `NetTie_2`. **Shield policy:** every connector shell gets 1 nF C0G ∥ 1 MΩ + solder-jumper direct option; defaults — DB37/CAN soft-tie, encoder + LEM shields direct (receiver-end termination).
- 2026-08-25 — S2 — **Power tree + budget frozen** (ARCHITECTURE.md §1–2): 24→12→5→3.3 cascade (TPS62153's 17 V Vin cap forces the cascade anyway; 12 V rail must exist for gate drivers) + isolated ±15 V branch. Budget ≈ 2.1 A @ 24 V / 2.9 A @ 18 V including the 40 W module aux pass-through → design current 3 A, fuse ~5 A, entry contacts ≥ 8 A. ±15 V load math (3 × LA 100-P ≈ 180 mA ≈ 4 W) confirms the 2 W module is undersized — S3 closes with ≥5 W or per-sensor modules.
- 2026-08-25 — S2 — **Floorplan inherits 3.0's proven arrangement** (extracted from the 3.0 board file: outline 91.9 × 121.7 mm, DB37 centered on a short edge, LaunchPad long axis perpendicular to it): DB37 = module edge; power entry + CAN/switches = service edge; encoder + 3× LEM connectors = analog edge (left flank = analog partition); bucks diagonal-opposite the analog corner. **BoosterPack headers = `PinSocket_2x10`, bottom side; LaunchPad hangs below the board** (stock LaunchPad has male pins on top only), USB/XDS end overhanging the service edge; nylon standoffs at the LaunchPad mounting holes. Closes S1's gender question — `PinHeader_2x10` stays in the library unused.
- 2026-08-25 — S2 — **Mounting pattern PENDING user measurement** (allowed by S2 exit criteria): the 6PS04512E43W39693 mechanical drawing is myInfineon-gated; only the 215 × 280 mm envelope is public (`infineon.md`). Leading plan: board gets its own regular hole pattern (S9), a laser-cut **adapter plate** maps it onto the real module top face — decouples board layout from module geometry.
- 2026-08-25 — S2 — **DB37 lives on the `gate_drive` sheet** (its dominant, layout-critical cargo is the gate bus); module raw signals export via hierarchical pins to `module_status` / `current_sense`. DB37 geometry is de-facto validated (3.0's identical footprint geometry mated the real harness); only the purchasable MPN stays open.
- 2026-08-25 — S2 — **Root interface captured: 40 nets / 80 sheet pins** + stubs + net labels on the root, matching hierarchical labels in all sub-sheets (net table in ARCHITECTURE.md §8). Sheet boxes **re-gridded from integer-mm to 1.27 mm multiples** (S1 had them off the connectivity grid — 80 `endpoint_off_grid` warnings the moment wires appeared; now zero). ERC = exactly 160 `label_dangling` and nothing else — this KiCad flags any label whose net has no component pin yet, so the count is the expected empty-hierarchy noise and burns down as S3–S8 fill sheets.
- 2026-08-29 — S3 — **Gate rail = 13.566 V, not 12.0 V** (user decision; S3/S4 joint). FB divider **75 kΩ / 4.7 kΩ**, both JLC Basic. Centres the rail in the module's 11–15 V HIGH window (12.75–13.29 V at the module across ±2 % rail and a 0.55 V drop), so S4 is free to pick any series damping resistor ≤100 Ω. 12.0 V worked in 3.0 but left only ~0.45 V of margin once tolerance stacked.
- 2026-08-29 — S3 — ⚠ **SUPERSEDED — see the revert entry below.** **12 V buck = TPS54360BDDAR (C524806), replacing the roadmap's LMR33630.** Two reasons: (a) **60 V input rating** — SMBJ33A clamps at 53.3 V, which a 36 V part does not survive; (b) LMR33630 has **no MODE/SYNC pin** (verified against its pin table) so it is auto-mode/PFM-only, and TI's own sizing rule puts its PFM boundary at ≈0.45 A — exactly our 12 V load. That is a part-sizing mismatch, not a tuning problem.
- 2026-08-29 — S3 — **5 V buck = TPS62933FDRLR (C5219272), replacing TPS62153.** TPS6215x has **no MODE pin** either — its power-save mode cannot be defeated (and TPS62153 is the *fixed* 5.0 V member; TPS62150 is the adjustable one). The `F` suffix is **FCCM**: fixed 1.2 MHz at any load including LaunchPad-unplugged, and it is the only family member **without** spread spectrum. This is the rail that feeds every analog front-end, so forced-PWM is a hard requirement here and only here.
- 2026-08-29 — S3 — ⚠ **SUPERSEDED by the revert below (L1 is now 22 µH).** **L1 = 47 µH** so U1 stays in **CCM down to ≈0.13 A**, below the real 0.25–0.5 A load. Do not reduce it in S10 — a smaller inductor raises the DCM/skip threshold back into the working range. 12 V-rail skip noise is otherwise tolerable because that rail feeds only gate drivers and the FCCM 5 V buck.
- 2026-08-29 — S3 — **±15 V = one Mornsun URA2415YMD-6WR3 (C5369735), 6 W, ±200 mA/rail** — closes the S0 flag that the ±66 mA A2415SDL-2W was undersized against ≈180 mA / 4 W for 3× LA 100-P. Datasheet also widens the assumed input range to **9–36 V**. Isolation is kept even though the secondary commons to GND at one point, so the ±15 V return current stays inside the analog partition. ⚠ consigned through-hole part, only 362 in stock.
- 2026-08-29 — S3 — **[ARCH CHANGE] rail `+12V_GATE` renamed `+13V5_GATE`** — the net regulates to 13.57 V and labelling it `+12V` on a schematic is actively misleading. New power symbol derived from KiCad's `+24V`, netclass pattern updated.
- 2026-08-29 — S3 — **[ARCH CHANGE] new global net `+24V_MOD`** — the module-aux pass-through needs its own fused net (F2, 3 A) to cross from `power` to `gate_drive`. S4 lands it on DB37 pins 8/26.
- 2026-08-29 — S3 — **Input fuse F1 = 0451005.MRL, 2410, 5 A / 125 V (C48467)**, user chose SMD/non-replaceable. It is the **only in-stock 5 A SMD fuse with an adequate voltage rating** — the two 1206 alternatives are 32 V and unrated, and a fuse must interrupt the arc at the applied voltage, which the TVS pins at 53.3 V. Cost: one derived footprint (KiCad ships no 2410 fuse land).
- 2026-08-29 — S3 — **Three EN/SS hazards caught during capture, each of which would have destroyed hardware:** U1 EN abs max is **8.4 V** and U2 EN abs max is **6.0 V** — neither may be tied to its input rail, so both get dividers (620 k/49.9 k → UVLO start 15.37 V / stop 13.26 V; 100 k/33 k → 3.37 V); and U2's **SS pin cannot float** (≥6.8 nF required, C13 = 47 nF fitted).
- 2026-08-29 — S3 — **Divider values re-picked against live stock, not just E96 tables.** The natural 13.5 V pair 162 kΩ/10.2 kΩ is unbuyable (**1** and **3** units in stock), as is the exact compensation resistor 5.49 kΩ (**19**). Final picks are Basic/high-stock parts; the unbuyable values are recorded in `S3_POWER_DESIGN.md` §8 so nobody "restores" them later.
- 2026-08-29 — S3 — **All five rail LEDs are the same Basic red part (KT-0603R, C2286)** with silkscreen naming each rail, rather than a green Extended line — and green's ~3.1 V Vf is marginal off the 3.3 V rail anyway. All five series resistors come from the S1 kit.
- 2026-08-29 — S3 — **`power` sheet captured: 79 components, 30 nets, ERC 0 violations on the sheet**, netlist verified node-by-node. Connectivity is by net labels at pins rather than drawn wires — electrically verified but visually dense around U1/U2; a wire-stub tidy-up is logged as a cosmetic follow-up. **[SUPERSEDED S7.5 — the sheet is now wired; the labels-at-pins pattern is no longer the convention.]** Both bucks' datasheet layout rules are written onto the sheet as text notes for S10.
- 2026-08-29 — S3 — **REVERTED the gate-rail buck back to LMR33630ADDAR (C841384)** after user challenge. The 60 V TPS54360B swap rested on the S2 assumption `+24V_IN 18–30 V`, which I inherited from ARCHITECTURE.md §1 and never confirmed. **User confirmed the LV rail max is ≤26 V [ARCH CHANGE: input range now 18–26 V]**, which makes a 36 V part correct. Reverting is also a net simplification: synchronous (no catch diode), internally compensated (no R/C/C network), fixed 400 kHz (no R_T) — **5 fewer parts and better efficiency**. FB divider recomputed for **V_ref = 1.000 V** (not 0.8 V): **150 kΩ / 12 kΩ → exactly 13.500 V**, both JLC Basic with >400 k stock. UVLO now via EN divider 100 k/10 k → rising 13.5 V, falling 12.4 V (both already in the S1 kit). L1 **47 µH → 22 µH** (C15857) per TI's ripple rule using the device's 3 A rating = 24.6 %; the rail runs PWM above ~0.35 A and PFM below, which is fine because it feeds only gate drivers and U2's FCCM input.
- 2026-08-29 — S3 — **Lesson logged: two justifications were stacked for one decision.** The LMR33630 was dropped citing *both* PFM behaviour *and* voltage headroom, when only the voltage argument was load-bearing — and that one rested on an unverified inherited assumption. The PFM concern is real only on the **5 V** rail (which feeds the analog front-ends); the gate rail's light-load mode does not matter. **The TPS62153 → TPS62933F swap therefore stands** and is independent of input voltage.
- 2026-08-29 — S3 — **TVS changed SMBJ33A → SMCJ26A (C310042).** The genuinely valid finding from the reverted detour was about the *TVS*, not the buck: SMBJ33A's breakdown is **36.7–40.6 V**, which straddles the LMR33630's **38 V absolute max** — that S2 pair was broken. Both SMBJ26A and SMCJ26A quote a 42.1 V clamp, but the 1500 W SMCJ reaches it at **35.6 A** vs the 600 W SMBJ's **14.3 A**, so at a realistic surge the SMCJ sits around 30–34 V, safely under 38 V. Stand-off 26 V matches the confirmed rail max. Do not substitute an SMBJ.
- 2026-08-29 — S4 — **[MAJOR] The PrimeSTACK datasheet arrived and replaced inherited guesswork.** The user supplied `datasheets/Infineon-6PS04512E43W39693-DS-v02_00-en-1840455.pdf` mid-session. Page 6 is the DB37 circuit diagram, page 2 the controller-interface electrical table. The v4.0 pin table above is now **sourced, not inherited** — including TOP/BOT within each half-bridge, which was the one thing I could not have verified from 3.0 alone.
- 2026-08-29 — S4 — **Fault polarity resolved: FAULT = HIGH.** Datasheet p.2: *"Digital output level: open collector, **logic low = no fault**, max 15 mA"*, matching p.6's *"X = high level with required external pull-up"*. `hw_control_v2.h`'s `MODULE_FAULT_ACTIVE_LOW 1` is **inverted** and must become 0 (with the Input X-BAR trip polarity flipped alongside). Bonus: a disconnected DB37 pulls the fault lines HIGH through their pull-ups, so **fail-safe is inherent**. **Bench item #1 no longer blocks S5** — the bench now only confirms.
- 2026-08-29 — S4 — **Module analog outputs are rated `load max 5 mA` each.** S5 may therefore use a plain low-Z resistive divider on Vbus — **no buffer op-amp needed**. Bench item #4 no longer blocks S5.
- 2026-08-29 — S4 — **[ARCH CHANGE] `NTC_2_RAW` and `NTC_2_ADC` retired.** The connector has exactly **one** temperature pin (29) and the options table shows only the inverter-section sensor fitted, so pin 29 is the **10 V** NTC2 channel. Sheet pins and labels deleted from root / `gate_drive` / `module_status` / `launchpad`. S5 must rate that divider for 10 V, not 4.9 V.
- 2026-08-29 — S4 — **DB37 pins 9 and 27 are a 15 V / 50 mA supply OUTPUT (for a PTC), not sensors.** 3.0 tied **pin 27 straight to GND** — a permanently shorted supply output — and divided pin 9 into a header as if it were a temperature reading. v4.0 lands both on test points (`MOD_AUX15V_1/2`, TP17/TP18). Potentially useful later to excite the Emrax PTC.
- 2026-08-29 — S4 — **DB37 pin 1 is "true earth/shield", not GND.** 3.0 hard-tied it to signal ground. v4.0 puts pin 1 on `SHIELD_DB37` together with the shell pins G1/G2, soft-tied via **1 nF C0G ∥ 1 MΩ** with **JP2** to make it a hard tie — exactly the S2 shield policy, which 3.0 predated.
- 2026-08-29 — S4 — **Gate driver = 3 × UCC27524DR (C465729), NOT the roadmap's 2 × TC4468.** Availability was checked first as the roadmap demands, and the entire TC446x/MIC446x quad family is dead at JLC (TC4468: **14** in stock; TC4468COE: 4; MIC4468: 25; UCC27523: 79) against **9 550** for the UCC27524. Functionally identical for us — non-inverting channel with a per-channel enable — at three duals instead of two quads. Its enabling property is that **input and enable thresholds are fixed and independent of VDD** and those pins are rated −5…+20 V regardless of VDD, so one stage spans 3.3 V → 13.5 V.
- 2026-08-29 — S4 — **The module has NO enable input pin**, so both firmware enables are board-local and **we** define their active level: **ACTIVE-HIGH**, as `hw_control_v2.h` assumes. **Bench item #2 no longer blocks S4.** It was only ever open because 3.0 wired GPIO131 to the AND gate's **VCC** rather than to a logic input — the aux "enable" was a supply switch.
- 2026-08-29 — S4 — **Hardware interlock kept, done safely (user decision).** `GATE_EN_3V3 = DRV_EN(GPIO66) ∧ DRV_EN_AUX(GPIO131) ∧ SW_MAIN_3V3`, in one SN74LVC1G11 powered from the board's own +3V3. **JP1 is an exclusive 3-pad solder jumper** (1-2 = interlock active, default; 2-3 = bypass to +3V3 for bench) so the two sources can never fight — 3.0's 2-pad `BYPASS0` shorted across a driven signal. **[ARCH CHANGE] new hierarchical net `SW_MAIN_3V3` into `gate_drive`** (root sheet pin added; the net already existed vehicle_io → launchpad). No RC filter on this path: filtering would delay *de-assertion*, the unsafe direction — conditioning belongs in `vehicle_io` (S8).
- 2026-08-29 — S4 — **Series damping R18–R23 = 100 Ω, and the datasheet's own input network (10 kΩ + 1 nF C0G to GND) is fitted at the DB37.** Worst case the module has it too, giving 5 kΩ ∥ 2 nF. Levels: rail 13.500 V ±2 % ⇒ module sees **12.95…13.62 V**, i.e. **+1.95 V over the 11 V floor and +1.38 V under the 15 V ceiling**. At the 12.0 V rail that was rejected in S3 the same maths gives only 0.52 V of floor margin — **the 13.5 V decision is now quantitatively validated**. Do not lower the 100 Ω in S10: it is what caps the driver's peak current at 127 mA (of 5 A) and damps the harness at the source.
- 2026-08-29 — S4 — **Skew budget closed: 53 ns worst case = 3.5 % of the 1500 ns deadband**, and the *effective* deadtime at the module is **1399 ns** (93 % of nominal) after the asymmetric RC threshold crossings (rise-to-11 V 380 ns vs fall-to-1.5 V 481 ns). Contributions: 27 ns device-to-device, 2 ns in-package (which is the H/L pair of one leg), 24 ns from C0G ±5 %. Matched R (1 %) and C (C0G) on all six channels is what keeps it there — S10 must also match trace length.
- 2026-08-29 — S4 — **[SAFETY] Reset-state pull-downs sized at 4.7 kΩ, not 100 kΩ.** The F28379D powers up with **GPIO pull-ups enabled** (worst case ≈24 kΩ). With 100 kΩ pull-downs the enable inputs would sit at 2.66 V and the PWM inputs at 2.75 V — i.e. **all six gates armed while the MCU is in reset**. 4.7 kΩ puts both at ≈0.53 V, under the worst-case low threshold, at a cost of 0.70 mA per line from a 4 mA-capable GPIO. R30–R32 and R36–R41 exist for this reason and must not be raised. Surfaced by ERC (`pin_not_driven` on pins with no other net member) — a rules check catching a real hazard, not a cosmetic one.
- 2026-08-29 — S4 — **`GATE_EN_3V3` pull-down R33 = 1 kΩ.** Six UCC27524 enable pins present 6 × 200 kΩ = 33.3 kΩ of internal pull-up **to 13.5 V**; a conventional 10 kΩ pull-down would sit at 3.1 V and *enable* the drivers if U8's output ever went high-Z. 1 kΩ gives 0.39 V (0.76 V even if the internal pull-ups were 100 kΩ), under the 0.8 V worst-case threshold.
- 2026-08-29 — S4 — **[ARCH CHANGE] new global net `PGND_MOD`** for DB37 pins 10/28, tied to `GND` at exactly one place: **NT2 on the `power` sheet, at the 24 V entry star**. Keeping it a distinct net until that tie is what makes S2's "dedicated copper, never through the plane under analog" rule enforceable by DRC rather than a layout wish — and it structurally prevents 3.0's defect of bridging GND↔P_GND at two separate net-ties.
- 2026-08-29 — S4 — **`gate_drive` captured: 56 components, 44 nets, ERC 0 violations on the sheet**, netlist verified node-by-node against a hand-written expected-membership table (44/44, zero mismatches). Root-sheet ERC is down to 90 `label_dangling` + 37 `isolated_pin_label` from the S2 baseline of 160 — the documented empty-hierarchy noise, burning down as S5–S8 fill sheets. Skew budget, fail-safe table, polarity chain, DB37 pin table and S10 layout rules are all written onto the sheet as text notes.
- 2026-08-29 — S4 — **Lesson logged: "vet availability first" earned its place in the roadmap.** Had the TC4468 design been drawn before the stock check, the whole enable architecture (quad AND-input driver, 8 channels, enable as the second AND input) would have been built around a part with 14 units in stock, and the rework would have touched every net on the sheet. The check cost one API call.
- 2026-08-29 — S4 — **Windfall for S9: the mechanical drawing is page 5 of the same datasheet** — 215 × 280 mm body, mounting pattern with Ø9.2 and Ø11×10-deep holes, M8×14-deep and M6×11-deep threads, dimensions 195 / 143.2 / 155 / 93 / 31 / 62 / 242.6 / 260, plus the X1 SUB-D position and G1/2" coolant threads. The long-standing "[user, before S9] measure the module top face" item is very likely closed by it; S9 extracts the pattern properly rather than S4 bleeding scope.

- 2026-08-29 — S5 — **[MAJOR FINDING] The datasheet's p.6 error table decoded: overcurrent is NOT per-phase.** An OC in any leg asserts **all three** half-bridge error pins (2/22/5); only "error driver core HB x" is unique to one pin. `FLT_OC_A/B/C` therefore cannot attribute the fault to a phase — firmware must stop implying they can, and use the decode table in `S5_MODULE_STATUS_DESIGN.md` §1.2 instead. Also from p.6/p.2: **"Over temperature shut down must be realized by customer"** — the module reports OT but does not act on it, so the NTC channel is a *safety function*. The p.3 options table (only the Inverter-Section sensors fitted) independently confirms S4's single-temperature-pin reading.
- 2026-08-29 — S5 — **Fault pull-up = 4.7 kΩ to `+13V5_GATE`, then a 10 k/4.7 k divider into a Schmitt.** Levels at the DB37 pin: 0.15 V no-fault (module sinks 2.84 mA of its 15 mA budget) / 10.23 V fault; the receiver trips between 2.60 V and 7.32 V referred to that pin ⇒ **2.45 V / 2.91 V of noise margin**. A 5 V pull-up needing no divider was considered and **rejected**: it leaves only 0.5 V on the low side, and that budget has to absorb *module-GND shift across the harness*, not just board noise. 3.0's 82 kΩ is 17× too weak.
- 2026-08-29 — S5 — **Receiver = 3 × SN74LVC2G17 (C10429), non-inverting.** The hex non-inverting SN74LVC17A **does not exist at JLC** (zero results), so it is 3 duals not 1 hex. Non-inverting is deliberate — a hex *inverting* part is in stock and would even have preserved `MODULE_FAULT_ACTIVE_LOW = 1`, but hidden inversion between connector and GPIO is a bench trap. **`Ioff` is load-bearing:** board +3V3 (AMS1117 off +5V) can die while the LaunchPad lives on its own LDO from the same +5V; with Ioff the outputs go high-Z and the GPIO pull-ups read **FAULT**. Fail-safe also holds for an unplugged DB37 — all five lines float high.
- 2026-08-29 — S5 — **Fault chain response 5.7 µs typ / 8.9 µs worst case** (two 3.56 µs poles from the 2× 1 nF C0G). Accepted deliberately: the module protects itself against OC **within 15 µs** and the PWM period is 100 µs, so this is the *reporting + X-BAR backstop* path and filtering is worth more than microseconds.
- 2026-08-29 — S5 — **Vbus divider = 2.20 kΩ / 1.50 kΩ, 0.1 % Yageo RT0603B (C861295 / C705741).** `VBUS_DIVIDER_RATIO` **297.14 → 341.538**, full scale **1024.6 V**, 0.250150 V/code, module load 1.95 mA of the 5 mA limit. Same resistor *family* on both legs matters more than the tolerance — the divider is ratiometric, so 25 ppm/°C parts track where a thick-film pair could drift 0.6 % differentially (≈6 V of bus). The closer-ratio 2.32 k/1.65 k pair was rejected on **673 units of stock**.
- 2026-08-29 — S5 — **22 nF C0G charge bucket at each ADC pin, fed through 3.3 kΩ** — Vbus corner 1726 Hz, NTC corner 1083 Hz. **This retires the 512-cycle ACQPS workaround:** the S/H sees the bucket (68 ns settling), not the divider. Charge-sharing costs a deterministic 2.8 codes. All three documented 3.0 Vbus defects are now closed — source impedance, Kelvin return (NT3 is the *only* GND tie for `VBUS_RTN`), and scale.
- 2026-08-29 — S5 — **No buffer op-amp on Vbus**, as S4's `load max 5 mA` finding allowed. A plain low-Z divider does the job; the part count and the offset/drift of an op-amp buy nothing here.
- 2026-08-29 — S5 — **NTC divider = 12 kΩ / 4.7 kΩ**, rated for 10 V continuous (DB37 pin 29 is the 10 V NTC2 channel): 10.000 V → 2.814 V = **93.8 % range use**, clips at 10.66 V, load 0.60 mA. Referenced to board **GND, not `VBUS_RTN`** — keeping the Kelvin line single-purpose is worth more than the ~1 % FS error a module-GND shift adds to a thermal channel.
- 2026-08-29 — S5 — **NTC ADC pin = `ADCINC3` (ADC-C ch3), BoosterPack site-1 J3-24; suggested SOC = ADC-C SOC2.** **ADCIND0–D5 are NOT on the BoosterPack headers** (SPRUI77 Fig. 5 — they go to the LaunchPad's own J21 via its differential amps), so ADC-D was not an option. SOC2 converts *after* the SOC1 (Vbus) EOC that fires the 10 kHz ISR, so the slow channel never delays the loop. This leaves **ADC-A SOC1 free for S6's third current channel** (ADCINA3 = J3-26 or ADCINA5 = J7-66).
- 2026-08-29 — S5 — **No fault LEDs.** These five lines drive a hardware trip; nothing optional gets hung on them. Fault indication belongs to the LaunchPad's own D9 and to telemetry.
- 2026-08-29 — S5 — **[BUG FIX] Netclass patterns were silently matching nothing** — see the netclass section above. KiCad matches the **path-qualified** net name, so 24 nets (the whole gate bus, both Kelvin pairs, both buck switch nodes, the enables) sat on `Default`. Ten patterns `*`-prefixed; 28 nets moved to their intended class, none lost one, netlist byte-identical. **Lesson: a convention written into a config file is not a convention until something proves it fires.** The S1/S3/S4 patterns were reviewed by eye four times and the ones that were checked happened to be the ones that worked.
- 2026-08-29 — S5 — **`module_status` captured: 54 components, 22 signal nets, ERC clean of every class except the documented label noise.** Netlist verified node-by-node against a hand-written expected-membership table (**22/22 exact, 0 mismatches**), and every module-side net lands on the DB37 pin the frozen table specifies. Root ERC **89 = 76 `label_dangling` + 13 `isolated_pin_label`**, down from S4's 127. The 15 dangling labels this sheet contributes are its own edge hierarchical labels, which carry no wire because the project captures connectivity as net-labels-at-pins — a cosmetic item, already logged, that should be fixed project-wide in one pass rather than per sheet.

- 2026-08-30 — S6 — **[USER] LEM stays LA 100-P, and the sensors live on a separate board near the motor cables.** Our board provides ±15 V + `ISO_COM` and receives three sensor outputs through **one global connector**. The ±150 A range is knowingly short of the 260 A SW trip — roadmap option (a), taken deliberately.
- 2026-08-30 — S6 — **[USER] The burden resistors are on THIS board**, so the harness carries the LEM secondary **current**, not a voltage. That single choice removes wire resistance, connector contact resistance and board-to-board ground shift from the measurement, makes an unshielded connector acceptable, and puts the gain element on the JLC-assembled board where it can be changed on the bench. **The remote board must not carry burdens.**
- 2026-08-30 — S6 — **Burden = 47 Ω ‖ 47 Ω = 23.5 Ω per channel (C870760, 1206 0.1 %).** The LA 100-P datasheet (fetched this session, `datasheets/LEM-LA_100-P-v15.pdf`) bounds R_M in a **window**, not a maximum: at ±15 V and the full ±150 A range it is **20–25 Ω at 85 °C** (0–33 Ω at 70 °C). The *minimum* exists because the burden must take dissipation out of the transducer at high ambient. Lower current ceiling ⇒ wider window ⇒ more volts/amp. Fitting one resistor instead of two gives 47 Ω, legal to ±100 A — this is the user's "adjust it for different current levels" mechanism, and it is also why it is a parallel pair rather than one hot 0805 (0.132 W → 26 % of rating each).
- 2026-08-30 — S6 — **Topology: two independent difference amps per channel, one 3-pad jumper selecting the OUTPUT.** The two sources are not interchangeable — the module sensor is a 2.5 V-biased signal (and 0.600 × 2.5 = **1.500 V**, so the ADC bias falls out of the attenuation for free), while the LEM burden is bipolar about 0 V and needs the bias injected. Sharing one amp would have meant switching signal, return **and** bias = nine jumper positions across three channels, where a wrong combination still reads plausibly. Cost of the chosen scheme is 3 op-amp halves and 12 resistors; it buys one jumper per channel, no wrong-but-plausible state, and **both stages live at once** on TP30–TP35 so the two sensors can be scoped against each other on the same current.
- 2026-08-30 — S6 — **Both stages reject their own source return.** Internal: V2 = `ISNS_x_RAW`, V1 = `ISNS_RTN` (Kelvin, DB37 12/13), V_bot = GND. LEM: V2 = burden top, V1 = burden bottom (`ISO_COM`, Kelvin), V_bot = `ISNS_VREF`. This closes S2's Kelvin requirement structurally rather than by layout wish, and is what prevents 3.0's measured load-dependent IR-drop offset. **NT4 is `ISNS_RTN`'s only tie to GND.**
- 2026-08-30 — S6 — **Internal gain 20.0 k/12.0 k = 0.600; LEM gain 12.0 k/4.99 k = 0.41583.** ADC: 4.800 mV/A internal (±300 A → ±1.44 V, span 0.06–2.94 V, clips ±312 A) and 4.886 mV/A LEM (+1.8 %). The residual mismatch is deliberate: matching exactly needs a **16 Ω** burden, which is legal at 70 °C but **below the 20 Ω floor at 85 °C**. A closer ratio from another manufacturer family would trade a *constant* 1.8 % (absorbed by one firmware constant) for a *differential tempco* between two thin-film families (up to 0.2 % over 40 °C, absorbed by nothing). **Same family beats closer ratio.**
- 2026-08-30 — S6 — **[FINDING] The module's internal sensor scale is ambiguous in the datasheet, and the design was made not to care.** "4.9 V @ 300 A_RMS" reads either as 8.00 mV/A (clips at 312 A — below the module's own 424 A_pk rated current) or 5.66 mV/A (4.9 V at the peak of a 300 A_RMS sinewave). Gain is set for the **higher** sensitivity: if 8 mV/A is right the target is hit exactly; if 5.66 mV/A is right full scale becomes ±441 A and only range is wasted. **Neither reading clips.** Designing for the lower one would have clipped at 221 A. Also from the same line: the 4.7/5.0 V band is **±3 %**, so the module's own three sensors can differ by several percent — no 0.1 % board resistor fixes that, and firmware calibrates offsets but not gains. That is the reason the LEM path (±0.45 %) exists.
- 2026-08-30 — S6 — **[RECORD CORRECTION] "internal current sensors ≈ 7.5–8 mV/A" was never bench-verified** and has been moved out of this file's verified list. `control_v2_pinmap.md` §6 *derives* it from an assumed 2.5 V bias and marks bias/polarity/limit as "must be verified on bench"; the genuinely bench-measured 78.6 mV/A belongs to the bench clamp+amp board, not the module. **Lesson, and it is S5's lesson again in another costume: a number inherited into a "verified" table is not verified until something points at the measurement.**
- 2026-08-30 — S6 — **[S12 FIRMWARE BUG] `hw_control_v2.h` contradicts itself by 10×.** HEAD has `LEM_V_PER_A 0.0075f` directly beneath a comment block insisting 78.6 mV/A was bench-measured 2026-07-22 and that 8 mV/A was a 9.8× under-estimate. History is `0.008 → 0.0786 → 0.0075`; the commit that made the last change (`e46882a`) documented a phase-ID solver rewrite, not this. One of the two is wrong.
- 2026-08-30 — S6 — **`ISNS_C_ADC` = ADCINA5 (ADC-A ch5) = BoosterPack J7-66**, suggested SOC1, over S5's other candidate ADCINA3 (J3-26). SPRUI77 Table 3 shows the current-sense block then occupies **five contiguous pins on one header** (J7-65…69 = ref B, I_C, I_B, I_A, ref A) across three different converters — adjacent, equal-length traces are exactly what channel-to-channel matching needs, and the per-ADC load stays balanced (A: SIN+I_w, B: I_u+COS, C: I_v+Vbus+NTC).
- 2026-08-30 — S6 — **Offset-reference channels ADCINA4/ADCINB5 KEPT, with an actual job.** Both read the buffered `ISNS_VREF` (≈1.4685 V) through their own 100 Ω + 22 nF buckets, driven by U15B so the ADC's sampling charge never lands on the reference the LEM stages stand on. Same node on two different converters ⇒ firmware gets a live bias reading *and* a free ADC-A vs ADC-B cross-check. This is also why no reference IC is needed: the divider's absolute value does not matter (zero is captured at every CALIBRATE) and its drift is *observable*.
- 2026-08-30 — S6 — **Anti-alias corner deliberately HIGH: 6.03 kHz (internal) / 6.79 kHz (LEM)**, in each difference amp's feedback with a matching cap across R2' so CMRR survives at HF. A single pole is a weak anti-alias filter at any corner (−6 dB at 10 kHz); what actually rejects the switching ripple is **synchronous sampling at the PWM peak**, which the firmware already does. Phase lag in *current* feedback, by contrast, rotates the measured current vector and costs torque accuracy — 9.4° at the 1 kHz max electrical fundamental instead of 19.5° at a 3 kHz corner.
- 2026-08-30 — S6 — **±15 V budget closed: 111 mA/rail worst case vs ±200 mA available** (3 × 12 mA quiescent + 75 mA peak secondary), 1.8× margin — S3's URA2415YMD-6WR3 survives. ⚠ Correcting a number I gave the user earlier in the session: for a balanced 3-phase set the max instantaneous sum of the *positive* secondary currents is **1.0 × peak, not 1.73 ×**.
- 2026-08-30 — S6 — **[SAFETY] With a LEM source selected the software OC trip is INERT.** The LA 100-P saturates at ±150 A against a 260 A `MOTOR_OC_TRIP_A`, and a larger burden lowers that ceiling. Protection there is the module's own 625 A_pk hardware shutdown (<15 µs) plus the `FLT_OC` X-BAR trip from S5. The internal sensors *do* cover ±312 A, so the **default jumper position (internal) is also the one that keeps the SW trip meaningful.** Goes in the S12 handoff, not just on the schematic.
- 2026-08-30 — S6 — **Connector: Deutsch endorsed for the vehicle interface, but the board carries a Micro-Fit 3.0 2×4 right-angle (C3294385).** The usual analog objection to Deutsch is neutralised by the current-mode harness, so the team-standard argument wins — **the DTM 8-way stays at the bulkhead**. It is not on the PCB because TE's product drawing for `DTM13-08PA-R004` is login-gated and the only obtainable dimensions are marketing-level; deriving a through-hole pattern from those would repeat exactly what S1 rejected 3.0's `F37HP` for. One-part swap if the drawing turns up. ⚠ **Key or size the LEM connector differently from S7's encoder connector** — mis-mating ±15 V into an RM44AC destroys it.
- 2026-08-30 — S6 — **[TOOLING] The MCP `import_symbol` produced an unloadable symbol library.** KiCad's `OPA2376xxD` is a *derived* symbol (`extends "LM2904"`) and the tool copied it without its parent; `kicad-cli sym export svg` went from 49 SVGs to 0. Fixed by flattening the parent's body under the child's name, matching how `UCC27524D` and `74LVC1G11` already sit in this library. **The `kicad-cli` re-export after every library edit is not ceremony — it caught a total library failure in one command.**
- 2026-08-30 — S6 — **`current_sense` captured: 94 components, 42 nets, netlist verified node-by-node against a hand-written expected-membership table (42/42 exact, 0 mismatches).** Root ERC **70 = 66 `label_dangling` + 4 `isolated_pin_label`**, down from S5's 89 and containing **no other violation class**. LCSC on 94/94 (82 purchasable + 12 `NOFIT`). Transfer functions, the R_M window, the jumper table, the ±15 V budget, the SW-trip caveat and six S11 layout rules are written onto the sheet as text notes.

- 2026-08-30 — S7 — **[MAJOR CORRECTION] S6's "the DTM13 drawing is login-gated" was false, and it had put the wrong connector on the board.** The user pushed back on being offered Micro-Fit again — *"i specified the deutsch ones"* — and re-testing the premise took one HTTP request: TE's `DocumentDelivery` endpoint (`Action=srchrtrv&DocNm=…&DocType=Customer+Drawing`) serves the full dimensioned customer drawings with **no authentication**. Three are now in `datasheets/`. **Lesson, and it is the fourth costume of the same lesson (S5 patterns, S6 "bench-verified" sensitivity): an inherited blocker is not a blocker until something re-tests it.** S6 reached the right *decision* (Deutsch) and then silently substituted the part on a false premise, which is worse than either choice made openly.
- 2026-08-30 — S7 — **[USER] Both vehicle connectors are now board-mounted Deutsch: J3 (LEM) = `DTM13-12PA-R005` key A, J4 (encoder) = `DTM13-12PB-R005` key B.** Two findings drove the shape. (a) Probing TE's repository across 2/3/4/6/8/12 ways × keys A/B × 11 flange suffixes returns **exactly three documents** — **the DTM13 board-mount family exists only in 8-way and 12-way**, so a 5-wire encoder cannot have a small Deutsch. (b) `-12PA-R005` and `-12PB-R005` are **dimensionally identical**; only the key differs. So one footprint serves both, the compact `-R005` 12-way (38.10 × 41.02 mm) is *smaller* than the 8-way's 4-ear `-R004` flange (68.58 mm), and **mis-mate protection now comes from the connector's own key** instead of from way-count — which survives any future re-pinning. J3's four spare ways go to `ISO_COM` so every rail and every sensor output has its return on the physically adjacent contact (1–12, 2–11, 3–10, 4–9, 5–8); the 2×4 could not do that.
- 2026-08-30 — S7 — **RM44AC resolved on paper: SINGLE-ENDED, 2.2 ±0.2 Vpp, offset 3/5·Vdd ±5 mV, 720 Ω internal series impedance, 5 V/13 mA, LiYCY 4×0.20 mm² shielded, order code `01S` = 1 cycle/mech rev.** Bench items #7–#9 stop blocking. The roadmap's preferred differential/INA receive is **not available**, and a Kelvin ground return is **physically impossible** — the factory cable has 4 cores and no spare conductor. The uncancelled part is 13 mA × 0.26 Ω = **3.4 mV, static**, which the ALIGN bias capture removes. Encoder draw is **13 mA, not the ~60 mA** ARCHITECTURE.md §2 budgeted.
- 2026-08-30 — S7 — **Topology: non-inverting difference amp per channel, `V_bot` = `ENC_VREF3V` (not a fixed 1.5 V).** Same part count as the textbook arrangement, chosen for one property: **with J4 unplugged the input floats to the reference through R1'+R2', so the output lands on the ADC bias exactly and the sin/cos vector collapses to the origin** — `sin²+cos²` ≈ 0 against `SENSOR_RES_MAG_LOW` = 0.25, detected with full margin and **independent of the calibrated amplitude**. The textbook version rails the output instead, which the firmware only catches while amplitude < 1930 codes; a max-amplitude encoder (1904 codes) sits close enough that an unplugged connector could read as a **valid frozen angle** — uncontrolled torque at speed. Cost: the bias now moves with gain, so a bench gain change also re-splits the reference chain (table in `S7_ENCODER_DESIGN.md` §9.1).
- 2026-08-30 — S7 — **Gain 1.16197 V/V (12.0 k/10.0 k with the 720 Ω source correction) ⇒ bias 1.4934 V (2039 codes), amplitude 1.278 V (1745 codes), 85.2 % range use, worst-case swing 0.099–2.888 V.** ⚠ **This deliberately misses CLAUDE.md's "~1.4 V / 1911 codes" target.** At 1.400 V nominal a legal max-amplitude encoder (2.4 Vpp) gives 1.527 V and peak code **4124 > 4095** — it clips, which is one of the three defects the firmware logbook blames for 3.0's 26° electrical noise. Sizing for the worst case costs 6 % of range and makes clipping impossible anywhere in the datasheet's 2.0–2.4 Vpp band. 3.0 achieved 48 % range use *with* clipping.
- 2026-08-30 — S7 — **The bias cancels RATIOMETRICALLY: the reference chain hangs off `ENC_VDD`, the same node that feeds the encoder.** The encoder's offset is 3/5 of *its* Vdd and our subtraction reference is 0.6003 of *the same* node, so the buck's tolerance, its line/load regulation and FB1's 4.9 mV drop all cancel. ⚠ **FB1 must stay a ferrite** — a 10 Ω series resistor at 13 mA would shift the output bias by 94 mV and clip the bottom of the swing.
- 2026-08-30 — S7 — **Reference chain 3.00 k / 4.99 k / 12.0 k, 0.1 % one family (RT0603BRD07, 25 ppm/K) — bought for TCR TRACKING, not accuracy.** A static reference error is removed at every ALIGN; **drift between ALIGNs is not**, and because both channels share these references a shift δ is a *common* shift on sin and cos, i.e. a vector translation giving `δ·√2/A` of angle error. 1 % ratio drift ≈ **6° electrical**; same-family 0.1 % holds it near 0.5°.
- 2026-08-30 — S7 — **Anti-alias pole 6.03 kHz (12.0 k × 2.2 nF), matching S6's corner; total uncompensated lag 10.55° electrical at 6000 rpm, differential SIN↔COS only ≈0.5°.** The governing fact is the firmware's, not the filter's: `sensor_rm44ac.h` already runs a matched 200 Hz IIR **and compensates its lag analytically** (`lag_elec = f_elec/fc`). A matched lag is therefore a correctable delay; a **mismatch is correctable by nothing** — which is why the RCs are identical and C0G, and why matching outranks corner choice. Optional one-constant firmware refinement: `1/fc_eff = 1/200 + 1/6030` → 193.5 Hz. Left optional on purpose so the board does not depend on the live-tunable `res_filt_hz` staying at its default.
- 2026-08-30 — S7 — **[SAFETY] BAT54S clamp (D10/D11) on each ADC line to +3V3/GND.** Unlike S6's stages, whose gain bounds the output below 3.3 V intrinsically, this stage can drive **3.89 V** if a signal line shorts to the encoder's own Vdd — over the F28379D's VDDA+0.3 = 3.6 V absolute max. Also covers a mis-mated ±15 V. Clamp goes to the **board** +3V3 because the LaunchPad's 3V3 header pins are NC by S2 policy.
- 2026-08-30 — S7 — **⚠ The DTM 12-way cavity numbering is EXTRAPOLATED, not verified.** TE's 12-way drawing does not label the cavities; the order used (1–6 / 12–7) follows the 8-way drawing of the same family, which does. Board, symbol and footprint are self-consistent either way, but **the mapping to the molded numbers must be confirmed before a harness is crimped.** Written on both sheets.
- 2026-08-30 — S7 — **`encoder` captured: 46 components, 16 nets, netlist verified node-by-node against a hand-written expected-membership table (16/16 exact, 0 mismatches).** Root ERC **66 = 62 `label_dangling` + 4 `isolated_pin_label`**, *down* from S6's 70 and containing **no other violation class**. Project netlist 125 → 149 nets (131 real + 18 no-connect pseudo-nets), 634 → 745 nodes, classes 61 Default / **58 Analog** / 17 Gate / 8 Power_1A / 5 Power_3A — the pre-existing `*ENC_*` pattern classed all 15 encoder signal nets Analog with no netclass change, and `SHIELD_ENC` stays Default like the other two shields. LCSC on 46/46. Source spec, transfer function, the unplugged-detection argument, the phase budget, the J4 pinout and six S11 layout rules are written onto the sheet as text notes.
- 2026-08-30 — S7 — **[TOOLING] 33 silent `footprint_link_issues` from abbreviated footprint names.** This library's parts are `R_0603_1608Metric`/`C_0805_2012Metric`, but CLAUDE.md's inventory table abbreviates them to `R_0603`/`C_0805`, and assigning the abbreviated name produces a component that places, wires and netlists perfectly while pointing at a footprint that does not exist. Only `--severity-all` ERC surfaced it. **Run `kicad-cli sch erc --severity-all`, not the default severities, before declaring a sheet clean.**

- 2026-08-31 — S7.5 (schematic legibility pass) — **[USER] All five populated sheets re-drawn: components placed by signal flow, local nets carried by wires instead of labels-at-pins.** `power`, `gate_drive`, `module_status`, `current_sense`, `encoder`. Across the five sheets: wires **13 → 699**, labels **748 → 401**, junctions 0 → 17. **Netlist byte-equivalent throughout: 149 nets / 745 nodes, every node set matching.** Project ERC **66 → 40**, and all five sub-sheets are clean of *every* violation class — the 40 remaining are root-sheet labels belonging to the still-empty `launchpad`/`vehicle_io` (S8). Symbol blocks were edited in place, so UUIDs, footprints, `LCSC` fields and instance paths are untouched; only `(at …)`, field positions and the graphical layer changed.
- 2026-08-31 — S7.5 — **Layout convention adopted: wires for local connections, labels only where a wire would have to cross.** This is not a compromise — the difference-amp topology *forces* one label per channel at the −IN entry (the + source arrives from the far left while the feedback ties to the output on the far right, so one branch must cross). Both `encoder` channels and all three `current_sense` channels use the identical band structure, which also satisfies S6's "the three channels must be geometrically IDENTICAL" rule *visually*, not just electrically.
- 2026-08-31 — S7.5 — **[TOOLING] Four KiCad file-format behaviours that silently corrupt a hand-generated schematic.** Each cost a debug cycle and none produce an error message: **(1)** a pin lying *mid-wire* does **not** connect — KiCad bonds a pin only at a wire **endpoint**, so every segment must be split at each pin it crosses; **(2)** symbol field angles are **relative to the symbol body** — a 90°-rotated part needs field angle 270 to render horizontally, but a 180° part needs 0 (an added 180 renders upside-down); **(3)** KiCad applies `(mirror …)` **after** the rotation, not before — only visible on a symbol that is both mirrored *and* rotated (the three `current_sense` source jumpers, whose pin 1/pin 3 silently swapped); **(4)** floating-point drift in generated coordinates produces **zero-length wire fragments** that break connectivity while looking correct in the file — round every coordinate to the same precision as the pin coordinates and drop degenerate segments.
- 2026-08-31 — S7.5 — **[TOOLING] A malformed token aborts KiCad's parse of the whole sheet, silently.** Passing a Python dict where `mirror` was expected emitted `(mirror {'ref_off': …})`; KiCad loaded the first 29 symbols of `current_sense`, discarded the remaining 65 plus every wire and label, and reported **no error at all** — `sch export netlist` exited 0. It surfaced only as "pin not connected" in ERC and as missing nodes in the netlist diff. **Lesson, and it is S5/S6/S7's lesson in a fifth costume: a check that reads your own model instead of the tool's output is not a check.** The geometry engine happily ignored the bad token; only the `kicad-cli` netlist diff caught it. Always gate on the tool's own export, never on your own parse.
- 2026-08-31 — S7.5 — **[VERIFY] The gate that made this safe.** Three independent checks, run after every regeneration: an S-expression→connectivity engine reproducing KiCad's rules (pin/label/wire bonding, no connection at un-junctioned crossings) compared net-by-net against the original; a crossing detector flagging any two wires meeting where they must not; and an order-insensitive netlist fingerprint from `kicad-cli sch export netlist` diffed against a golden baseline. Bugs caught that would otherwise have shipped: a wire shorting across `R108`, `C111`/`C112` shorting `ENC_VDD` to `GND`, a BAT54S pin-direction error dropping the SIN clamp onto the COS line, pull-ups fitted backwards on all five `module_status` fault channels, and `J1`'s ground pin left unwired.

- 2026-08-31 — S8 — **[RECORD] `datasheets/ECU AM06.pdf` and `TCC.pdf` are REFERENCE ONLY — the AM06 ECU interfaced a black-box WEG inverter, not this board.** The next ECU revision is being designed *against* our board, so S8 **publishes** the vehicle interface instead of conforming to one. What survives from AM06 is context, not contract: the ECU is an ESP32 with **two** CAN nodes — built-in TWAI (GPIO21/22) → **ISO1050DUB** → inverter link, and an **MCP2515 + TJA1050** breakout → vehicle bus with 120 Ω enabled by `JP1` — while the TCC datalogger has **no discrete transceiver at all**, only an MCP2515 module socket. ⚠ AM06's `J3` 12-way "deutch ts" pin table, its 15 V PC817 enable/brake levels and its +5 V/+15 V draw were **WEG's requirements**. Do not treat any of it as ours.
- 2026-08-31 — S8 — **[PROVISIONAL — user is confirming with the ECU team] The ECU↔board CAN link is a dedicated 2-node segment and the galvanic barrier lives on the ECU side.** [USER] The 24 V feeding our logic is expected to come from a **separate battery not bonded to the car's ground**, making our board a floating island relative to the car's GLV domain — so a barrier on this link is needed after all. ⚠ **This supersedes reasoning given earlier in the same session** ("no barrier needed, the PrimeSTACK already isolates control from the DC link"), which was sound only while both boards were assumed to share GLV ground. Our side stays **non-isolated** (3.3 V SN65HVD230/TCAN33x class, as the roadmap always had it) precisely *because* our node is the reference the ECU's isolated bus side follows. Two nodes ⇒ both ends terminated ⇒ our 120 Ω solder jumper defaults **FITTED**.
- 2026-08-31 — S8 — **[PROVISIONAL] If the ECU powers its isolated bus side from us, that is a real load and a real hazard on `+5V`.** AM06's arrangement (`VCC2` ← inverter +5 V, `GND2` ← inverter GND) is **not** a WEG artifact — an isolated transceiver's bus side must be referenced to something, and on a 2-node link that something is us. Budget ≈**75 mA** worst-case dominant on `+5V` (not in ARCHITECTURE.md §2), and the pin leaves the board into a harness, so it needs current limiting and short tolerance. The alternative the ECU team may pick is an **integrated-DC/DC isolated transceiver (ISOW1044 class)**, which needs nothing from us. Settle this before S8 freezes the connector. (ISO1050 is CAN 2.0 only; **ISO1042** is the successor if CAN FD is ever wanted.)
- 2026-08-31 — S8 — **[USER] `SW_MAIN_3V3` comes hardwired from the FSAE shutdown circuit, NOT through the ECU** — a microcontroller does not belong in the gate-enable safety path. Because the shutdown circuit is car-referenced while our domain floats, our side receives it **through an optocoupler**: LED driven by the shutdown-circuit voltage, phototransistor in our domain with our own pull-down — the mirror of AM06's U5, with us owning the receiving half. ⚠ **S4 banned filtering on this path because it delays de-assertion, the unsafe direction.** An opto carries its own turn-off delay (tens of µs into a high-value pull-down ≈ one 100 µs PWM period), so the pull-down is sized for **turn-off speed, not CTR margin**, and a PC817 may not be fast enough.
- 2026-08-31 — S8 — **[SAFETY, consequence of the floating supply] DB37 pin 1 / `JP2` is now load-bearing and must stay OPEN.** S4 put the module's true-earth pin on `SHIELD_DB37` behind a 1 nF ∥ 1 MΩ soft-tie with `JP2` as a hard-tie option — a routine shield call at the time. With a floating 24 V supply, that soft-tie is the only thing between our island and the module chassis, which is bolted to the car: fitting `JP2` would bond the two domains and undo every barrier on the board at once. Silkscreen must say why, not just which position is default.
- 2026-08-31 — S8 — **[VERIFY] The whole firmware pin map was checked against SPRUI77 Tables 1–4 by parsing the PDF, not by reading it.** 23 of 26 signals resolve to a BoosterPack pin; the three that do not are exactly the three already documented as off-header by design (`GPIO31` = the LaunchPad's own D9, `GPIO42`/`GPIO43` = SCI-A on the USB backchannel). Four inherited claims are now independently confirmed rather than trusted: GPIO131 → J6-58 (S2), ADCINC3 → J3-24 (S5), the five contiguous current pins J7-65…69 (S6), and GPIO67 → J1-5, which retires the "pin unverified on Control_V2" caveat on the ISR probe. **This is the S8 cross-check gate passing on the MCU side** — what remains is the netlist side, after the sheets are drawn.
- 2026-08-31 — S8 — **[FINDING] The four BoosterPack sockets are `J1+J3`, `J4+J2`, `J5+J7`, `J8+J6` — the two J-columns printed side by side in each SPRUI77 table ARE the two rows of one physical connector.** Not the "J1+J2 / J3+J4" grouping that the numbering suggests. Verified against the **3.0 board's as-built pad→net map**, which mated the real LaunchPad on the bench: header `RR0` carries the six gate signals on its odd pads and `DRV_EN`/`FLT_*` on its even pads — i.e. J8 and J6 in one body — and `RL0` puts `FLT_V` on odd pad 15 = J5-48 = GPIO52 while its even pads carry `I_A`/`I_B`/`OS_A` on J7-68/67/69, all four agreeing with the frozen pin map. Pad *(2k−1, 2k)* = table row *k*. **S9 needs this to place the sockets; getting it wrong mates the board to the wrong pins with no ERC or DRC complaint.**
- 2026-08-31 — S8 — **CAN = CAN-A on GPIO4 (TX, J4-36) / GPIO5 (RX, J4-35). CAN-B is not an option, and that is a hard constraint rather than a preference.** Enumerating every CAN mux against the header tables: the only free `CANTXB` on a header is GPIO16 (J4-33), while **every** header `CANRXB` — GPIO7 and GPIO10 — is consumed by the PWM bus. So CAN-B cannot be brought out at all without giving up a gate signal. CAN-A offers exactly two adjacent-pin pairs, GPIO4/GPIO5 (J4-36/J4-35) and GPIO19/GPIO18 (J1-3/J1-4). ⚠ **An earlier pick of GPIO19/GPIO18 in this same session was WRONG and is superseded**: it rested on the assumed J1+J2 grouping, and once the real grouping was verified, J1 turned out to share a connector body with `ENC_SIN`/`ENC_COS`/`VBUS`/`NTC` — the exact opposite of the intent. `J4+J2` carries no analog at all, so CAN and the two cockpit switches now share the quiet connector. **Lesson, in a sixth costume: the tie-break was reasoned from a plausible convention instead of from the proven board sitting in the next directory.**
- 2026-08-31 — S8 — **[RESOLVED] The LaunchPad's own CAN transceiver can never contend with ours.** This file has carried a caution since S2 to "avoid or account for" the on-board transceiver on GPIO12/17 behind the J12 0 Ω links. It sits on **CAN-B**, and **neither GPIO12 nor GPIO17 appears anywhere in Tables 1–4** — they do not reach the BoosterPack headers at all. Nothing to avoid, nothing to account for; the links are irrelevant to this board either way.
- 2026-08-31 — S8 — **`launchpad` captured: 11 components, ERC-clean of every class on the sheet.** Four `Conn_02x10_Odd_Even` sockets (J20–J23, numbered from 20 so they can never be misread as TI's J1–J8), 33 connected header pins, **47 explicit no-connects**, the SS34 5 V feed deferred here from S3, and four test points (`+5V_LP`, two GND lugs, the GPIO67 ISR probe). Netlist verified from `kicad-cli`'s own export: every cross-sheet net now joins its header pin to its consumer — `/PWM_UH_3V3` = J23.1 + R36.1 + U5.2, `/DRV_EN_3V3` = J23.4 + R30.1 + U8.1, `/ENC_SIN_ADC` = J20.18 + C107 + D10.3 + R112.2 + TP40, and so on for all 26. Project **ERC 40 → 13**, and all **13 belong to the still-empty `vehicle_io`** (the four `CAN_*`/`SW_*` labels); no other violation class anywhere. LCSC on 11/11.
- 2026-08-31 — S8 — **[RE-BASELINE] `golden.net` moved from 149 nets / 745 nodes to 201 / 835**, per the tooling README's rule that a legitimate connectivity change is re-baselined in the same commit. The delta is exactly accounted for: **+47** no-connect pseudo-nets, **+2** new nets (`+5V_LP`, `/launchpad/ISR_PROBE_3V3`), **+3** nets that existed only as labels with no pin until now (`/CAN_TX_3V3`, `/CAN_RX_3V3`, `/SW_START_3V3`); nodes **+90** = 80 header pins + 10 for D12/C114/C115/TP45–48. The cosmetic re-run after fixing a label collision then re-diffed **IDENTICAL**, which is what proves the generator idempotent.
- 2026-08-31 — S8 — **[TOOLING] The MCP server writes symbol blocks the S7.5 tooling cannot see, silently.** `batch_add_components` emits `(symbol (lib_id "…") (at X Y R) (unit 1)` on one line with **space** indentation, while `sheetedit.Sheet` finds top-level nodes with `^\t\(` and rewrites placement with `^\t\t\(at …\)$`. The eleven new symbols were therefore skipped by `place()` with no error — the first run failed only because `place()` raised `KeyError`. Fixed properly by adding **`tools/schematic_layout/canon.py`**, a sexp→canonical-tab re-emitter, rather than by hand-patching indentation. **Any future session that adds parts via MCP and then runs a layout script must run `canon.py` in between.**
- 2026-08-31 — S8 — **[TOOLING] `conncheck`/`dump.py` reported this sheet as 1 net and 87 unlabelled pins. It was wrong; the sheet was correct.** `kicad-cli sch export netlist` and `sch erc --severity-all` both agree the sheet is fully connected and clean. The house rule earned its keep in the other direction this time: **the fast local checker can produce a false alarm as easily as a false pass, and neither is the gate.** Left unfixed — it is a convenience, and the netlist diff is the contract.
- 2026-08-31 — S8 — **Socket = PM2.54-2*10 (C5116528), and there is no Basic option.** Every 2-row 20-pin female line at JLC is Extended; picked on stock (15 698, against 11 814 / 9 858 / 3 330 for the alternatives). ⚠ The **insulator height is unverified** — the LaunchPad hangs below on nylon standoffs, so the mated stack has to close before this is ordered. S9.
- 2026-08-31 — S8 — **[FINDING] The six `PWM_*_3V3` nets sit on `Default`, and always have.** Confirmed from `kicad-cli`'s own `(class …)` output, not by reading the pattern list. The netclass patterns cover `*PWM_*_15V` and `*PWM_*_DRV` but **not** `*PWM_*_3V3`, so the MCU-side half of the gate bus is unclassed. This is the S5 defect's milder cousin — a pattern set that looks deliberate but is incomplete. **Not changed here**: netclass values and their derivation are S9's, and moving six nets deserves a stated rationale rather than a silent edit. Logged as an open item.

- 2026-09-01 — S8 — **J5 = DEUTSCH `DTM13-08PA-R004` (8-way, key A, consigned).** Keys A and B are spent on J3/J4, and TE's board-mount DTM13 family has only 8- and 12-way members, so an 8-way is the only receptacle a 12-way plug physically cannot enter: **mis-mate protection by way-count**. The S7 premise was re-tested, not inherited: `DTM13-12PC/12PD-R004/R005`, `DTM13-08PB-R004`, `DT13-08PA`, `DT13-12PA` (+`-R004`/`-R008`) all return TE's not-found page. Pin pairs (1,8) CAN, (2,7) `+5V_VEH`/GND, (3,6) shutdown circuit, (4,5) start — every function on physically adjacent cavities.
- 2026-09-01 — S8 — **[FINDING] The `-R004` is not a flat-base part.** Its flange is a vertical 68.58 × 33.02 plate with four slotted ears; the pins leave the flange rear and bend down, **rows 6.35 mm apart** (drawing section B-B, printed .250 ± .010 and measured 6.30), and the flange reaches 4.4 mm below the board. S7's table said "4 × 2, 4.191 mm" for this part — corrected in `S7_ENCODER_DESIGN.md`. Consequences: the board edge must sit between the rear pad row and the flange (footprint carries a `Dwgs.User` guide at y = +6.35 and the overhang in its courtyard), and **nothing retains the connector but its eight pins — S9 must bracket the flange slots.** Cavity numbers are taken from the drawing, which labels them (near row 1–4, far row 5–8); confirm on a real plug like J3/J4.
- 2026-09-01 — S8 — **CAN front-end: SN65HVD230 (Preferred) + ACT45B 100 µH common-mode choke + PSM712 (Basic) at the connector + 120 Ω through a BRIDGED jumper (fitted by default, 2-node link).** RS = 10 k → slope control ≈15 V/µs (datasheet Fig. 33); **10 k pull-up on TXD** because the datasheet's own layout note says the internal bias is weak and a floating D with the LaunchPad unplugged could hold the bus dominant. Split termination rejected: one series jumper would leave an asymmetric 60 Ω + C stub on one line when opened. No shield pin on J5.
- 2026-09-01 — S8 — **Both cockpit inputs are optically isolated, high-side, non-inverting: LTV-817S-C (Basic) → 2.2 k pull-down → SN74LVC2G17 Schmitt → GPIO.** Car GLV is 12 V (the AM06 ECU runs on +12 V); the LED chain 2 × 2.2 k + anti-parallel 1N4148W accepts 8–30 V (1.5 mA at 8 V, still ≥ 1.5× the 1.4 mA needed to saturate; 59 % of 0.1 W per 0603 at 24 V — use 3.3 k if the car goes 24 V). **Every failure — LED off, unplugged, broken wire, dead opto — reads LOW = gate enable withheld**, which is why it is high-side and why logic-output optos (all inverting) were rejected. Delay = the phototransistor's own fall time into 2.2 k, tens of µs, under one PWM period, and the only delay on the path (S4's no-filter rule kept). The Schmitt exists because a 20 µs edge violates LVC's 10 ns/V input-transition limit 1000×.
- 2026-09-01 — S8 — **`+5V_VEH` (provisional) = SS34 → 0.2 A polyfuse → SMAJ5.0A + 100 nF → J5.2.** The Schottky is the one part the S8 note did not ask for: without it a mis-wired 12 V on the pin lands on the `+5V` rail (the polyfuse limits current, not voltage, and the TVS clamps at 6.4–7 V — above the OPA2376/LVC/buck absolute maxima). Its cost is the interface spec: **4.6–4.75 V at ≤ 75 mA at the connector — ISO1042/ISOW1044 class (4.5–5.5 V), NOT ISO1050 (4.75 V min).** Publish to the ECU team; 0 Ω in D16's place if they need 5.0 V and guarantee no back-feed.
- 2026-09-01 — S8 — **`vehicle_io` captured: 30 components, netlist 201 → 220 nets / 835 → 914 nodes, every new net verified node-by-node, project ERC `--severity-all` = 0.** The 13 root-sheet label warnings that had waited since S1 are gone. `golden.net` re-baselined 201/835 → 220/914 in the same commit.
- 2026-09-01 — S8 — **[TOOLING, four defects in the S7.5 generator, all fixed, all six older sheets regenerated and re-verified netlist-identical / ERC 0.]** (1) **A vertical global label's JUSTIFY, not its rotation, decides which side of the anchor the flag lies on** (measured on a four-label test sheet): the helper's `90 + left` stood every downward GND flag *on top of the part it hung from* — on every regenerated sheet, in the committed renders, unnoticed for a session because the netlist gate is blind to cosmetics. (2) KiCad transforms a field's justification with the symbol (mirror-y and 180° flip it). (3) Inserting a missing `(justify …)` never worked (it searched for a line it had already cut off). (4) **Note texts were addressed by file index, and the file order changes on every regeneration** — re-running any S7.5 script on its own output scrambled the notes (10/10 on `module_status`); now content-addressed (`text_by`/`notes_by`). **Lesson, seventh costume: a gate that cannot see a class of defect is not a gate for that class — render the sheet and look at it.**
- 2026-09-01 — S8 — **BOM / JLC audit: 135 grouped lines, 293 purchasable placements on 63 LCSC codes (29 Basic / 4 Preferred / 30 Extended ≈ $90 setup fees, ≈ $28 of parts per board), 62 NOFIT, 5 consigned (J1–J5), 0 empty LCSC fields** (U9–U11 units 2/3 lacked the field and KiCad's BOM picked them — fixed). **`C107043` 2.2 nF C0G reports 4 in stock** in two sources → ten caps moved to Murata `C77033`; value strings normalised so each LCSC line is one BOM line. S12 re-verifies everything live.
- 2026-09-01 — S8 — **Schematic freeze: tag `v4.0-schematic-freeze`.** Exit criteria met: ERC 0, pin map 100 % matched, BOM audit table exists (`S8_INTEGRATION_DESIGN.md` §8). Any schematic change after this reopens S8's checklist.

- 2026-09-02 — S9 — **Board 146 × 130 mm, 4-layer JLC04161H-7628 (0.035 / 0.21 prepreg / 0.015 / 1.065 core / 0.015 / 0.21 / 0.035), origin (50, 50).** 3.0's 91.9 × 121.7 cannot hold two board-mounted DTM13 12-ways (41.5 × 38.6 mm each) plus the DB37 and the LaunchPad grid; the growth is deliberate and stays inside the module's 143.2 × 242.6 M8 grid.
- 2026-09-02 — S9 — **Floorplan executed as S2 decided, with one refinement: encoder connector top-left, LEM connector bottom-left**, so each front-end sits beside both its connector and its ADC socket pads (`ENC_*_ADC` on J20 at y ≈ 33, `ISNS_*` on J22 at y ≈ 89–98). `U4` sits beside J3 with its ±15 V pins facing the LEM pin field; DB37 rotation 0 puts all six gate pins and four of the five fault pins under the driver corner beside J23, and the analog pins over the current-sense strip. The socket columns are barriers (0.84 mm between pads) — every block was placed so its traffic reaches its pads without crossing one.
- 2026-09-02 — S9 — **[VERIFY] Socket handedness derived from SPRUI77 Fig. 12, not from 3.0.** Component side up, USB up: J1 is the outer-left column with pin 1 at the USB end, J3 inner-left, J4/J2 inner/outer right with 40/20 at the top; site 2 likewise. Our board sees the LaunchPad un-mirrored (it hangs below, component side up), so the sockets are on B.Cu **unrotated**, and the pad coordinates read back from the placed board confirm pad 1 → pad 2 is +x and pad 1 → pad 3 is +y. 3.0's as-built grid agrees — the cross-check, not the source.
- 2026-09-02 — S9 — **[FINDING] The LaunchPad is 129.9 × 58.4 mm and its seven holes are now known to ±0.3 mm** — measured from the PCB layer figures in SPRUI77 §6.3 by blob analysis scaled on the 2.54 mm header pitch (the 63.5 / 43.18 mm grid checks to 0.3 %), because TI publishes no drawing and the Gerbers live in login-gated C2000Ware. Three standoff holes on the board (`H7`–`H9`: near-centre, mid, far-left corner); the far-right corner hole was dropped because it lands on the fault-receiver corner. **The user verifies with a caliper before ordering.**
- 2026-09-02 — S9 — **PrimeSTACK mounting pattern read from the datasheet p.5** (rendered at 400 dpi): M8 × 14 deep on 143.2 × 242.6, Ø9.2 through with Ø17 × 11 counterbores on 195 × 260, both centred on the 215 × 280 body. **The adapter plate stays the mechanism** (ARCHITECTURE.md §7 no longer pending). ⚠ The same top face carries the HV busbar terminals (the 155/93/31 and 62/62 patterns) — the plate's standoff height and creepage are the user's mechanical call.
- 2026-09-02 — S9 — **Board holes are NPTH without pads.** With a floating 24 V domain (S8), a plated GND hole under a screw into the chassis-bonded plate would undo `JP2`'s soft tie; the screws must not be a ground path.
- 2026-09-02 — S9 — **Design rules from JLCPCB's published 4-layer capabilities; netclass values kept, IPC-2221 ratings recorded; `*PWM_*_3V3` → Gate; new `CAN` class.** All verified from `kicad-cli`'s `(class …)` output, per the S5 lesson. One `.kicad_dru` rule relaxes pad-to-pad inside `U2` (SOT-583, 0.5 mm pitch) to 0.15 mm — the 0.25/0.30 netclass clearances are routing discipline and cannot be met between a fine-pitch part's own pads; scoping the relaxation to the footprint keeps it out of routing.
- 2026-09-02 — S9 — **[TOOLING] J5's courtyard was two overlapping rectangles → KiCad "malformed (self-intersecting)", and a malformed courtyard is silently excluded from the overlap check.** Replaced by one eight-vertex polygon in the library and in the board's embedded copy. Eighth costume of the lesson: the MCP's bounding-box overlap checker reported three phantom overlaps on J5 and none of the real risk; `kicad-cli pcb drc --severity-all` is the gate.
- 2026-09-02 — S9 — **[TOOLING] MCP quirks met this session:** `replace_board_outline` / `clear_board_outline` crash on the SWIG backend (edit Edge.Cuts in the file); every external edit of the `.kicad_pcb` must be followed by `open_project` or the next auto-save is refused; a flip to B.Cu is reported as rotation 180 while the geometry is the intended mirror; `place_component` with `boardPath` and the `FE_UFPR_4_0:` prefix does place project-library footprints (an earlier "not saved" scare was a grep for the un-prefixed name).
- 2026-09-02 — S9 — **Placement generated, not hand-placed:** `tools/board_layout/place_s9.py` derives block membership from net families and shelf-packs courtyards. A first pass keyed on reference numbers overflowed five blocks and lost seven parts; the net-derived pass placed 360/360. It is the reproducible *structure*; S10/S11 refine within blocks. Exit criteria met: 369 placed, KiCad DRC 0 errors, 0 courtyard overlaps, ratsnest reviewed (`S9_BOARD_SETUP.md` §7).

- 2026-09-02 — S9.5 — **[MAJOR, USER] Motor-temperature channel added; the schematic freeze was deliberately reopened.** The board had **no motor-temperature channel at all**, and the EMRAX manual makes it mandatory: *"the temperature sensor that is mounted in the motor must be connected to the controller"*, hard limit **120 °C on the copper windings (exceeding it voids the warranty)**, and *"in case of disconnection of the temperature sensor… the controller has to stop the motor"*. Standard sensor is **KTY 81-210** (2000 Ω @ 25 °C, 3817 Ω @ 120 °C, silicon PTC). Done now rather than later because the board was placed but **not yet routed** — the cheapest moment it will ever be. Full derivation: [`S9_5_MOTOR_TEMP_DESIGN.md`](S9_5_MOTOR_TEMP_DESIGN.md).
- 2026-09-02 — S9.5 — **Sensor is the divider's BOTTOM leg, excited from +3V3 through R129 2.20 kΩ.** Open → 3.30 V, short → 0 V, both outside the valid 1.12–2.18 V band, so EMRAX's disconnect-detection requirement costs no extra hardware — S7's unplugged-encoder argument reused. **+3V3 not +5V is deliberate**: an open sensor rails the node to the excitation rail, and 3.3 V is inside the F28379D's VDDA+0.3 = 3.6 V absolute max. 6.25 codes/K at the limit; sensor current 0.99 mA at −40 °C, under the datasheet's 1 mA.
- 2026-09-02 — S9.5 — **[CORRECTION] The excitation rail was the dominant error term, not the sensor.** The divider compresses (`dV/V` = 0.194 %/K at 120 °C), so **1 % of rail error ≈ 5 K** — an AMS1117 at ±2 % gives ±10 K, *larger than the KTY's own ±4.7 K spec error*. (An earlier figure of "≈2 K per 1 %" given in-session was wrong.) Fixed with **R131/R132, a 10.0 k/10.0 k 0.1 % monitor on `ADCINA3`**, so firmware cancels the rail exactly. **No op-amp**: range use is only 35 %, but 6.25 codes/K already exceeds what a thermal loop needs and the sensor's ±4.7 K is the floor — same reasoning as S5's unbuffered Vbus divider.
- 2026-09-02 — S9.5 — **J4 cavities 6/7, with 5/8 left EMPTY as a guard column.** 16.8 mm from the SIN cavity, own twisted pair, not inside the encoder shield. There was no alternative connector — TE's board-mount DTM13 family is 8- and 12-way only, keys A and B are spent on J3/J4, J5 is full, and a third look-alike 12-way is the mis-mate hazard S8 designed out. ADC = **ADCINB3 (J20 pad 10)** over ADCINC5 (J7-64): ADC-C would have kept both thermal channels together with S5's SOC ordering, but J7 is the current-sense socket across the board and S9's placement rule is that a block's traffic reaches its pads without crossing a socket column. SOC assignment is free in firmware; routing is not.
- 2026-09-02 — S9.5 — **⚠ GATED ON EMRAX: is the KTY reinforced-insulated from the windings?** The manual states no isolation class and describes the sensor as *"on the stator windings"*. Under FSAE 2026 **EV.1.6** the TS is "every part **electrically connected** to the Motor(s)", **EV.6.5.1a** demands complete galvanic separation, and **EV.6.5.3** forbids TS and GLV sharing a connector. Reinforced/double insulation ⇒ GLV ⇒ everything above is legal; basic insulation ⇒ TS ⇒ this block moves to an isolated front end on its own connector (EV.7.5.7's "isolation in the sensing circuit") plus a marked TS area at 12.7 mm surface spacing. **This cannot be reasoned out and a megger cannot substitute for the spec** — Lenze ships KTY/PT1000 *reinforced* in servo motors and PTC/TCO *not* reinforced in standard motors, same technology, different build. Ask for the class per **EN 61800-5-1** at 600 V DC working voltage.
- 2026-09-02 — S9.5 — **[USER, considered and rejected] Putting the whole board on the TS side instead.** EV.6.5.1b explicitly allows it ("some components, such as the Motor Controller, may be part of both systems") and production inverters are built that way, but **floating ≠ isolated to a rated class**: the board's barriers were built for a floating supply, not specified as 600 V TS/GLV barriers. It would drag in **59 test points** becoming live, an enclosure with the ISO 7010-W012 mark (EV.4.9.1), the 24 V battery + charger + LaunchPad + LEM board + encoder all re-documented as TS, EV.6.5.7's 12.7 mm spacing at the LTV-817S (whose pad rows are **9.0 mm** apart), and it would give away the barrier the PrimeSTACK already provides for free. **Also found: R119 is a fitted 0 Ω hard-tying `SHIELD_ENC` to GND** — if the RM44AC's cable shield bonds to its readhead body, the "floating island" is already chassis-referenced through the motor. Worth resolving regardless of this decision.
- 2026-09-02 — S9.5 — **Zero new BOM lines.** Every part reuses an existing LCSC code: R129 = C861295 (S5's Vbus divider part), R131/R132 = C95204 (S7's difference-amp inputs), R130 = C22978, C120 = C106246, C121/C122 = C77069, D18 = C7420333. No new reel fee, nothing new to stock-check.
- 2026-09-02 — S9.5 — **[BUG FIX, PRE-EXISTING] `sync_schematic_to_board` reports nets in `nets_added` that it never assigns to any pad.** Three *real* nets had **zero pad assignments** on the board: `MOT_TEMP_RAW` (this session), and — **not mine** — **`+5V_VEH`** (C119.1/D17.1/F3.1/J5.2) and **`CAN_RS`** (R120.1/U18.8), both absent from the **S9 commit's board too**. S10 would have routed the board with the ECU supply feed and the CAN slope-control resistor silently unconnected. `schematic_parity` reports 0 and does **not** catch it. All twelve pad assignments were written into the `.kicad_pcb` and confirmed via KiCad's own **IPC-D-356 export**. **Lesson, ninth costume: the tool's success message is not the tool's output — check the artifact.**
- 2026-09-02 — S9.5 — **⚠ "499 unrouted connections" is not an exact figure.** The DRC's `unconnected_items` stayed at exactly 499 across every board state this session, including after nets were added, while the board's own pad data implies **705** connections across 146 multi-pad nets. S9's note inherits the 499. Re-derive from the board before using it as a routing metric.
- 2026-09-02 — S9.5 — **[TOOLING] Two defects the gates caught, one each.** (1) A purely **cosmetic** re-spacing of the signal row **shorted R130** — collapsing two wire segments into one ran it straight across the resistor; the netlist diff caught it in one command. (2) **Rendering the sheet** caught four text collisions the netlist is blind to (S7.5's rule again) — `C101`/`C102`'s own value text reaches x 89, which is what pushed the D18 clamp onto its own row. ⚠ Also: **do not `git checkout` a sheet before re-running its layout script** — since S8 the scripts are idempotent against their own output, and the restore silently discarded ten MCP-added symbols.

- 2026-09-02 — S9.5 — **[RECORD CORRECTION, user-spotted] "An ISOW1044-class transceiver needs nothing from us" (S8 decision log) is WRONG — it still needs the ground REFERENCE.** An isolated DC/DC makes a *floating* rail: it fixes `VCC2 − GND2` at 5 V but cannot say where `GND2` sits. Each transceiver judges the pair against its own ground, and ours (SN65HVD230) has a bus common-mode window of only **−2 V to +7 V**; with our board floating there is no other path to close, so without J5 cavity 7 the common mode drifts on leakage alone until the link dies. **Cavity 7 (`GND`) is populated in every case; only cavity 2 (`+5V_VEH`) and the 75 mA depend on the answer to Q3.** ⚠ And cavity 7 is safe *only because* their bus side is isolated — **if it is not (Q2), cavity 7 must NOT be connected**, or that one wire bonds our floating island to car ground and undoes every barrier on the board, exactly like fitting `JP2`. **Lesson: "supply" and "reference" are different requirements, and an isolated DC/DC solves only the first.**

- 2026-09-14 — S9.6 — **[USER] The board goes VERTICAL, direct-mounted on the module's X1 through a DB37 90° adapter, no cable.** The available volume is *above* the module. X1 sits on the top face and **faces the 3-phase terminal side** (user-verified on the module — my reading of the datasheet's side elevation as "DC-link side" was wrong and is retracted). First choice **L-com DG9037MF1/2/3** (low-profile right-angle DB37 M/F, shielded, ~25 mm, ≈$46–54; the variants differ only in exit direction — the user picks from L-com's drawings, which their site would not serve to a script). Fallback: a passive two-D-sub adapter PCB. **The main board stays agnostic**: its right-angle DB37 socket takes the adapter's male end or the cable plug identically, so prototyping keeps the cable with zero change. Full write-up: [`S9_6_VERTICAL_MOUNT.md`](S9_6_VERTICAL_MOUNT.md).
- 2026-09-14 — S9.6 — **"Vertical connectors" turned out to be unnecessary once the board is vertical.** A right-angle connector on a *side* edge has a horizontal mating axis, so J3/J4 (left edge) and J5 (top edge) keep their DTM13 right-angle parts — TE has no vertical board-mount DTM13 (S7 probe) — and J1's Mini-Fit 5566 was already vertical. The DB37 stays right-angle so the adapter/plug arrives from below.
- 2026-09-14 — S9.6 — **[USER, ARCH CHANGE] All connectors on the TOP side; the LaunchPad sits ABOVE the board on `PinHeader_2x10` male headers (F.Cu), on its own bottom-side receptacles — exactly as the 3.0 board mated it.** S2's premise "the stock LaunchPad has male pins on top only", which put S9's sockets on the bottom, was **wrong**. Same XY grid, component side up, USB end at the service edge; the LaunchPad overhangs the top edge by 17.9 mm *above* the board (it cannot move down without meeting the DB37 body). Stack ≈ 11 mm; its 129.9 × 58.4 shadow is drawn on `Dwgs.User` and nothing taller than ~8 mm sits under it (C1's 10.5 mm electrolytic is why the power column now starts at x = 120). **Cost: test points under the shadow are unreachable with the LaunchPad fitted** — an S11 item. **[VERIFY]** the header at rotation 0 on F.Cu reads pad 1→2 = +x, 1→3 = +y from the board file, the relation S9 verified, and KiCad's own IPC-D-356 export matches `golden.net` on **80/80** header pads (35 nets + 45 no-connects). New part C492427 (male 2×10, Ext, 98 935); the female C5116528 and its insulator-height open item are moot.
- 2026-09-14 — S9.6 — **Floorplan re-run, not patched** (`place_s9.py`): J5 → top-left (x 39.5) so its vertical flange (off-board, x −11.7…57.4, protruding 11.7 mm past the top-left corner in the air) clears the LaunchPad overhang; J4/J3/U4 down to y 32.9/82.0/116.2 with H5 at 57.3 between J4 and J3; new `can_end` block under J5's CAN cavities; new `mot` block beside J4 holding the S9.5 parts (which S9.5 had placed by hand — the S9 generator overflowed by 10 parts on the S9.5 netlist) plus the J4 shield tie; C54–C57 assigned to the fault receivers they decouple. **370/370 from the netlist, no overflow. DRC 0 errors, 403 silk warnings (S11), ERC 0.**
- 2026-09-14 — S9.6 — **[USER] The user routes the board (S10/S11).** All routing was undone before this session; Claude does not touch copper unprompted — rules, placement structure, DRC/ratsnest review and documentation only.
- 2026-09-14 — S9.6 — **[PENDING TEAM] Precharge / DC-bus contactor: the requested form conflicts with the 2026 rulebook.** Request: the board supplies 24 V to a contactor closing the DC bus when V_bus passes a threshold (moving precharge out of the accumulator into the inverter). **EV.5.6.1** puts the precharge circuit *in the pack, supplied from the Shutdown Circuit*; **EV.7.1.2** makes the Shutdown Circuit *directly carry* the IR and precharge-relay coil current; **EV.5.6.5** mechanical precharge relay; **EV.5.4.3** no HV outside the container with the IRs open; **EV.5.6.2** end-of-precharge by intermediate-circuit feedback at ≥ 90 % of TS voltage. So the contactor stays in the pack on the shutdown loop, whose voltage is the GLV voltage — a 24 V coil implies a 24 V GLV; our floating 24 V can neither feed the coil nor the shutdown loop (that would bond the island through the BMS/IMD/BSPD). **What the board can add:** one mechanical PCB relay, GPIO-driven, **contact in series with the shutdown-circuit feed to the second IR's coil**, closed when firmware sees V_bus ≥ 0.9·V_pack (V_pack from the BMS over CAN, which the team confirms it broadcasts); fail-open on CAN loss / reset / dead board; needs a 2-way connector (J5 is full). **Not drawn** until the team decides; it reopens S8's checklist.
- 2026-09-14 — S9.6 — **[TOOLING]** `swap_lp_headers.py` rebuilds footprints from the library into the board with properties + pad→net map — the board's footprints carry **no `(path …)`** (MCP-placed), so schematic↔board linkage is by reference. Footprints may be moved by editing `(at x y r)` **only if the rotation is unchanged** (pads/texts store absolute angles); rotation changes go through the MCP mover. `kicad-cli pcb export ipcd356` (no hyphen) is the pad-net gate. `golden.net` re-baselined: delta = 4 `Footprint` + 4 `LCSC` fields, nothing else.
- 2026-09-17 — post-S9.6 — **[USER] Precharge / DC-bus contactor DROPPED — handled externally.** Closes the S9.6 [PENDING TEAM] entry. Nothing had been captured (no symbol, footprint, net or connector cavity), so the board is unchanged; the `S9_6_VERTICAL_MOUNT.md` §5 relay proposal is void and S8 is not reopened. `SW_MAIN_IN` (J5 cav 3/6, shutdown-circuit gate-enable input) is unrelated and stays.
- 2026-09-17 — post-S9.6 — **[COST] PCBA cost model built from live JLCSearch data (all 63 real LCSC lines queried).** Economic PCBA one-time **$101.81** (setup 8.18 + stencil 1.53 + **30 Extended lines × 3.07 = 92.10**) + $3.58 hand-solder labour; per board **$33.30** (700 SMD joints × 0.0016 = 1.12, 85 THT joints × 0.0164 = 1.39, components 30.79). 5 boards ≈ **$272** + bare PCB. Split: **29 Basic / 4 Preferred Extended / 30 Extended**; Basic *and* Preferred are feeder-fee exempt. **Economic beats Standard** ($101.81 vs $130.16 = 25.56 + 8.21 + 63 × 1.53); crossover is at 39 Extended lines. Detail in [`JLC_PARTS.md`](JLC_PARTS.md).
- 2026-09-17 — post-S9.6 — **[COST] Feeder-fee reduction audited and REJECTED — no Extended line can be cut.** $92.10 (87 % of the one-time assembly cost) is unavoidable: (a) the **7 thin-film 0.1 % lines** are bought for **TCR tracking, not accuracy** — the encoder sheet note quantifies a 1 % ratio drift as **~6° electrical** and says *"never substitute a mixed-family divider here"*, and S5 §2.2 quantifies a thick-film Vbus pair as **0.6 % differential drift over 60 °C = 6 V of bus error**; (b) the **4 C0G lines** have no Basic equivalent above 100 pF (S1 constraint); (c) the ICs have no Basic equivalents; (d) **no through-hole part can ever be Basic** — JLC's Basic catalogue *is* the pre-loaded SMT feeder set, so the 2×10 headers, fuse, PTC, TVS, electrolytic, inductors and DC/DC each cost a mandatory $3.07. Substitutions for R57/R58 (Vbus, → C4190/C22843) and R105 (encoder chain, → C4211) were made and **reverted**; both sheets verified byte-identical afterwards. **Do not re-attempt** — the only lever left on assembly cost is order quantity.
- 2026-09-17 — post-S9.6 — **[TOOLING] JLCSearch `/api/search?q=<LCSC>` returns an empty result for parts that exist.** `C25804` (10.0 k 0603, 16 placements) came back empty from `/api/search` and was briefly believed dead; `/resistors/list.json?package=0603&resistance=10000` shows it **Basic with 37 165 617 in stock**. The search index is incomplete for passives — **cross-check the category endpoint before declaring any part gone.** Logged in [`TOOLING_NOTES.md`](TOOLING_NOTES.md).
- 2026-09-17 — post-S9.6 — **[COST] Economic PCBA accepts 2–50 pcs, so assembly qty need not equal PCB qty.** Assembling **2 of 5** boards costs ≈ $172 + bare PCB instead of ≈ $272, and leaves 3 bare boards for rework and for the consigned-connector work. Recommended for the first article.
- 2026-09-17 — pre-S10 — **[SCHEMATIC] UCC27524 channels swapped on U5/U6/U7: LOW side now on INA/OUTA, HIGH side on INB/OUTB; `golden.net` re-baselined (219 nets / 929 nodes, unchanged count).** User's request, to ease routing: on the board each IC's INA sat below INB while J23 has H above L, so the inputs crossed. The channels are interchangeable: ENA/ENB all tie to `GATE_EN_3V3`, both channels have identical 4.7k pull-downs (C23162) and 100R series resistors (C22775), and delay matching is 1 ns typ / 4 ns max against the 1500 ns deadband. The input and output of each channel moved **together** (swapping only one side would drive the high-side IGBT from the low-side command). The IC-side resistors stay with the pins (R36/38/40 and R18/20/22 on channel A, now L; R37/39/41 and R19/21/23 on channel B, now H). The DB37-side C37–C42, R24–R29 and TP10–TP15 keep their DB37 nets. Done in `gd_layout.py` (rows reassigned) plus the polarity-chain note (U5.INB → OUTB → R19 → pin 21). The netlist diff is exactly 18 nets, all on the PWM chain. ERC 0. Firmware is unaffected (GPIO → DB37 pin mapping unchanged).
- 2026-09-17 — pre-S10 — **🛑 [DEFECT] D2 (BZX84C15, Q1 Vgs clamp) was a 2-pin `D_Zener` on a 3-pad SOT-23, so it clamped nothing.** It surfaced as KiCad's Update-PCB warning `No net found for component D2 pad 3`, which had been sitting in every update log. Generic symbol K = 1, A = 2; BZX84 SOT-23 is pin 1 = A, pin 2 = NC, pin 3 = K. On the board, pad 1 (anode) was on `+24V_PROT`, pad 2 (NC) on `PWR_QGATE` and the cathode floated, so Q1's gate had no zener protection. Fix: new project symbol `D_Zener_SOT-23` (A = 1, K = 3), D2 repointed (cache + instance pin UUIDs). Netlist diff: exactly `+24V_PROT` D2.1→D2.3 and `PWR_QGATE` D2.2→D2.1. ERC 0, 51 symbols render, `golden.net` re-baselined. Manufacturer pinout of C19077472 not seen (JLCSearch shows no maker); BZX84 SOT-23 is industry-standard, but confirm on the LCSC datasheet. **Lesson: read the Update-PCB warnings. A 2-pin symbol on a 3-pad footprint is a pinout question, not noise.**

## Appendix A — netclass pattern history (moved from CLAUDE.md's design-rules section)

  Track presets 0.25/0.3/0.4/0.5/0.8/1.2/2.0 mm; via presets 0.6/0.3, 0.8/0.4, 1.0/0.5. 14 netclass **patterns** are pre-seeded against the net convention (`+24V_IN`, `GND` → Power_3A; rails → Power_1A; `PWM_*_15V`, `DRV_EN*` → Gate; `ISNS_*`, `ENC_*`, `VBUS_*`, `NTC_*`, `*_ADC` → Analog) so nets self-classify as S3–S8 create them.
  **S3 update:** `+12V` pattern renamed `+13V5_GATE`; added `+24V_PROT`/`+24V_MOD` → Power_3A,
  `ISO_COM` → Power_1A, and `PWR_U*_SW` → Power_1A (buck switch nodes: high di/dt, want wide + short).
  18 patterns total.
  **S4 update:** added `PGND_MOD` → Power_3A (module aux return, up to 2.2 A on dedicated copper),
  `PWM_*_DRV` and `GATE_EN*` / `GATE_ILOCK_3V3` → Gate. **22 patterns total.**
  **S5 update — [BUG FIX] every path-sensitive pattern was silently matching nothing.** KiCad
  matches netclass patterns against the **full, path-qualified net name** (`/gate_drive/PWM_UH_15V`),
  not the base name, so any pattern anchored at the start never fired. **24 nets were sitting on
  `Default`, including the entire gate bus and both Kelvin sense pairs.** Only the global power
  nets worked (their names carry no sheet path) and `*_ADC` (already wildcard-led) — which is why
  it went unnoticed for four sessions. The ten path-sensitive patterns are now `*`-prefixed:
  **`*PWM_*_15V` `*DRV_EN*` `*ISNS_*` `*ENC_*` `*VBUS_*` `*NTC_*` `*PWR_U*_SW` `*PWM_*_DRV`
  `*GATE_EN*` `*GATE_ILOCK_3V3`**. Still 22 patterns; no netclass *values* changed (S9 owns those).
  Result: 51 Default / 17 Gate / 11 Analog / 8 Power_1A / 5 Power_3A, netlist byte-identical.
  **Any new pattern must start with `*` unless it names a global power net.**
  **S6 update:** added **`*LEM_*`** → Analog (the LEM secondary nets `LEM_A/B/C_M`). **23 patterns.**
  **S8 update:** added **`+5V_LP`** → Power_1A (the post-Schottky LaunchPad feed; the existing
  `+5V` pattern is exact, not a wildcard, so it would not have matched). **24 patterns**, verified
  from `kicad-cli`'s own `(class …)` output: Power_1A 8 → 9.
  Verified empirically against the exported netlist, not by eye: all 27 `current_sense` signal nets
  resolve to **Analog**, `SHIELD_LEM` stays Default (matching `SHIELD_DB37`). Project-wide:
  125 nets = 52 Default / **43 Analog** / 17 Gate / 8 Power_1A / 5 Power_3A.
  **S9.5 update:** added **`*MOT_TEMP_*` → Analog** (`MOT_TEMP_ADC`/`_REF_ADC` already matched `*_ADC`; `MOT_TEMP_RAW` did not). **28 patterns**, verified from `kicad-cli`'s `(class …)` output: Analog 58 → **61**.
  **S9 update:** added **`*PWM_*_3V3` → Gate** (closes S8's open item — the MCU-side half of the
  gate bus now shares its class) and a new class **`CAN`** (0.40 track, 0.30 clearance, 0.8/0.4 via,
  diff-pair 0.40/0.30, priority 15) on **`*CAN_H*` / `*CAN_L*`**. **27 patterns, 6 classes**, verified
  from `kicad-cli`'s `(class …)` output: 55 Default / 58 Analog / **23 Gate** / 9 Power_1A / 5 Power_3A /
  **4 CAN**. Board rules re-derived against JLCPCB's published 4-layer capabilities
  (`S9_BOARD_SETUP.md` §4): min track/clearance 0.127, via ≥ 0.5/0.2 (0.6/0.3 default), hole-to-hole
  0.5, copper-to-edge 0.3, silk 0.15 / 1.0 mm text. Netclass *values* unchanged — they are routing
  discipline, all ≥ 1.4× JLC's floors — but their IPC-2221 ratings are on record: **Power_3A carries
  3.7 A on 1 oz outer and only 1.1 A on 0.5 oz inner**, so `+24V_*` and `PGND_MOD` are outer-layer
  runs or ≥ 5 mm L3 pours, never a 1.2 mm inner trace.

## Appendix B — per-session deliverable summaries (moved from CLAUDE.md's roadmap section)

**S9's deliverable is [`S9_BOARD_SETUP.md`](S9_BOARD_SETUP.md)** — the 146 × 130 mm floorplan and why
every block sits where it does, the JLC04161H-7628 stackup, the JLC-derived design rules and the
IPC-2221 re-derivation of every netclass (**Power_3A is 1.1 A on an inner layer — pours only**), the
**PrimeSTACK mounting pattern read from the datasheet** (M8 on 143.2 × 242.6, Ø9.2 on 195 × 260),
the **LaunchPad outline and hole positions measured from SPRUI77's layer figures**, the socket
handedness derived from the LaunchPad silk and verified from the placed pad coordinates, the
placement generator, and the J5 courtyard defect that would have hidden collisions from DRC.

**S8's deliverable is [`S8_INTEGRATION_DESIGN.md`](S8_INTEGRATION_DESIGN.md)** — the vehicle connector
(why the 8-way, and the finding that `DTM13-08PA-R004` is a **vertical-flange right-angle part** with
**6.35 mm** row spacing, not the flat-base 4.19 mm grid S7's table assumed), the CAN front-end, the two
**isolated cockpit inputs** with every level and the fail-safe argument, the **provisional `+5V_VEH`**
feed and its 4.6–4.75 V interface spec, the netlist-side **pin-map cross-check table**, the **BOM/JLC
audit** (and the 2.2 nF C0G stock finding), and four tooling defects found by finally *looking at* the
rendered sheets.

**S7's deliverable is [`S7_ENCODER_DESIGN.md`](S7_ENCODER_DESIGN.md)** — the RM44AC's real output
spec (single-ended, 2.2 Vpp, 3/5·Vdd, 720 Ω), the difference-amp transfer function and every
computed value, why the amplitude target moved from 1.4 V to 1.28 V, the **ratiometric bias
cancellation**, the topology choice that makes an unplugged encoder collapse to the ADC bias
(unconditional loss-of-signal), the phase budget, and the **connector correction that put Deutsch
back on the board** — S6's "the DTM13 drawing is login-gated" premise was false.

**S6's deliverable is [`S6_CURRENT_SENSE_DESIGN.md`](S6_CURRENT_SENSE_DESIGN.md)** — the two
difference-amp stages per channel and every computed value, the **LA 100-P R_M window** (a burden
resistor is not a free knob), why the burden lives on *our* board, the ±15 V budget, the ADC pin
choice, and the correction of a "bench-verified" figure that was never measured.

**S5's deliverable is [`S5_MODULE_STATUS_DESIGN.md`](S5_MODULE_STATUS_DESIGN.md)** — the fault
receiver chain and its noise/timing budget, the decoded **module error table** (overcurrent is NOT
per-phase), the Vbus and NTC front-ends with every computed value, the ADC pin choice, and the
netclass-pattern defect found and fixed there.

**S4's deliverable is [`S4_GATE_DRIVE_DESIGN.md`](S4_GATE_DRIVE_DESIGN.md)** — the gate chain, the
skew/deadband budget, the fail-safe table, and the **authoritative DB37 pin table** taken from the
PrimeSTACK datasheet the user supplied mid-session (`datasheets/Infineon-6PS04512E43W39693-DS-v02_00-en-1840455.pdf`).

**S3's deliverable is [`S3_POWER_DESIGN.md`](S3_POWER_DESIGN.md)** — every computed value, datasheet
equation and JLC stock check behind the `power` sheet.

**S2's deliverable is [`ARCHITECTURE.md`](ARCHITECTURE.md)** — power tree + budget, LaunchPad
power policy (jumper table), grounding/shield rules, floorplan, mounting status, and the
root-sheet interface net table. S3–S8 implement that contract; changes to it get logged.

Full roadmap: [`REDESIGN_PLAN.md`](REDESIGN_PLAN.md) — 12 sessions, one per Claude Code session. Exit criteria are gates: do not start a session until its prerequisites are met, do not bleed into the next session's scope.
- 2026-09-17 — post-S9.6 — **🛑 [DEFECT] `C22936` is 1 Ω, not 1 MΩ — six placements still wrong.** The S1 kit table listed Uniroyal `0603WAF100KT5E` (`C22936`) as the 1 MΩ line; it is **1 Ω ±1 % ±400 ppm**. The 1 MΩ part is `0603WAF1004T5E` = **`C22935`** (Basic, 8 062 164 stock, $0.00096) — adjacent code. **R35, R67, R77, R89, R104, R118** all carry it, and all six are signal-to-GND bleed/shield resistors: 1 Ω hard-shorts `SHIELD_DB37` / `SHIELD_LEM` / `SHIELD_ENC` to GND (recreating 3.0's harness ground loop) and shorts `ISNS_A/B/C_RAW`, the module's **5 mA-limited** sensor outputs, to ground at 4.7 A demanded. Kit table corrected; **the six symbols are not yet changed.** **Found by JLCPCB's BOM-matching tool, which prints the description beside the code** — neither the local JLC DB nor a bare code check would surface it. Lesson: read the returned description, never just the code.
- 2026-09-17 — post-S9.6 — **[COST] Economic PCBA is single-side only, so the placement must stay single-sided.** A 212 F.Cu / 162 B.Cu experiment was reverted the same day (back to 370 / 4). Double-sided forces Standard double-side: **$167.51** one-time vs Economic **$105.39** = **+$62.12** flat, per-board cost unchanged. Weigh it against keeping **B.Cu as a clean signal layer**, not against the $62.
- 2026-09-17 — post-S9.6 — **[COST] Real JLC quote obtained: parts = $92.07 for 5 boards** (BOM-matching tool, PCBA qty 5) — but with U4, U5–U7, U9–U11/U21 and U12–U17 deselected. Supersedes the $30.79/board estimate, which over-counted multi-unit symbols (the per-code tally came from schematic symbol *units*, not packages). The authoritative component number is the quote, not a unit-price × instance-count estimate.
- 2026-09-17 — post-S9.6 — **[MECHANICAL/EMC] Board orientation re-opened by the team; connector rail caps stay on F.Cu.** S9.6's vertical mount (DB37 edge down on a 90° adapter to X1) is **provisional** — horizontal is still on the table — so the board is kept orientation-agnostic: every connector on the top face, passives dimensioned off their own connector/IC pins, no bracket or mounting-hole work. Back-side mounting was evaluated for the caps that sit at through-hole connector pins (C97/C98 at J4-1 `ENC_VDD`; C92–C95 at J3-1/5 `±15V_ISO`) because a THT barrel makes the rail-side via free: **≈1.1 nH loop on B.Cu vs ≈2.0 nH at 3 mm on F.Cu vs ≈3.8 nH at the 7.7 mm pocket outboard of the DTM13 courtyard** (1.6 mm board, L2 ≈ 0.21 mm down, 0.3 mm drill ⇒ ≈1.3 nH full-thickness via, ≈0.39 nH/mm for 0.25 mm track, 0.7 nH 0603 ESL). **Rejected anyway, two reasons:** (a) in a horizontal mount B.Cu faces the IGBTs, and the caps plus a local `ISO_COM` island punch holes in exactly that shield; (b) the single-side PCBA cost decision already logged above. The 100 nF's self-resonance drops ~15 → ~8 MHz, accepted — the cable-entry defence is the series R + 1 nF per signal pin (S7 §6 / S4's DB37 network), not the rail cap. **Corollary: flipping a cap to B.Cu to get under an *SMD* pin is always a loss** (≈2.5 nH — you trade 3 mm of track for a 1.3 nH via), so C87–C90, C103 and C104 stay on F.Cu at their op-amp pin 8.
- 2026-09-17 — pre-S10 — **[REVIEW] Pre-routing placement validation of the user's hand re-placement → [`S10_PLACEMENT_REVIEW.md`](S10_PLACEMENT_REVIEW.md).** Structure passes: floorplan (analog left at J3/J4/J20/J22, power tree top-right, gate drivers over the DB37 gate pins), J20–J23 grid exactly 43.18 × 63.5 mm at board-local (66, 14), DB37 row 1 at 9.40 mm, courtyard overlaps 0, nothing > 8 mm under the LaunchPad. Systematic finding: the connector-entry 1 nF caps that S4 / S6 §5.5 / S7 place *at the pin* sit with their amplifiers and drivers (17 caps, 11–75 mm; only C58/C60 comply); ADC charge buckets are 11–25 mm from the header pads on six channels; U18 has no cap within 18 mm (C116/C117 are at U21); U1's CIN is 7.7 mm from VIN. The user tightens these before routing.
- 2026-09-17 — pre-S10 — **[ASSEMBLY] 12 SMD parts stay on B.Cu (user).** R2/R3 (U1 EN divider, under U1), D17/C119 (`+5V_VEH` clamp, under J5), C25–C28 (U4 ±15 V caps, under J3's pins), R118/R119/C113 (J4 shield tie) and C120 (KTY 1 nF) under J4. The user will order two-sided assembly (Standard, +$62.12 flat per the [COST] entry above) or hand-solder the 12. Qualifies the [MECHANICAL/EMC] "add nothing to B.Cu" rule: the *rest* of B.Cu stays continuous copper.
- 2026-09-17 — pre-S10 — **🛑 [DEFECT] DB37 shell pads carried no net.** The footprint's two Ø3.2 shell holes were named `SH`/`SH` while the `DSUB-37_Socket` symbol's pins are `G1`/`G2` on `SHIELD_DB37`; `kicad-cli pcb drc --schematic-parity` reported two `net_conflict`s and the JP2 / R35 / C43 tie had nothing to land on. Present since S4 — ERC, plain DRC and the IPC-D-356 export never compare pad names to pin names. Fixed: pads renamed `G1`/`G2` in `FE_UFPR_4_0.pretty` and on J2, net attached; IPC-D-356 now lists `J2 -G1` / `-G2` on `SHIELD_DB37`; footprint renders. **Rule: DRC always runs with `--schematic-parity`.**
- 2026-09-17 — pre-S10 — **🛑 [DEFECT] The 15:06 restore also deleted the six S8 symbols from `FE_UFPR_4_0.kicad_sym`** (SN65HVD230, LTV-817S, SolderJumper_2_Bridged, D_TVS_Dual_CAN, Conn_02x04_Counter_Clockwise, L_CommonMode — the last 1 915 lines; users J5, D13, L3, JP6, U18–U20). The schematic kept working from its embedded cache; ERC showed 7 `lib_symbol_issues`. Restored with `git checkout 9cf0c5a -- FE_UFPR_4_0.kicad_sym` (that deletion was the file's only diff); all 59 unit SVGs render; ERC 0. The netclass regression from the same event (OPEN_ITEMS) was fixed by re-adding the `CAN` class and four patterns; `(class …)` output = Analog 61 / CAN 4 / Gate 23 / Power_1A 9 / Power_3A 5 / Default 117 = 219.
- 2026-09-17 — pre-S10 — **[SCHEMATIC] TP20, TP23, TP54 (user) and TP37 (user's call) deleted; `golden.net` re-baselined.** All four sat under the LaunchPad shadow (S9.6 §1.1). Delta vs the previous golden: exactly one node lost on `VBUS_ADC`, `NTC_1_ADC`, `MOT_TEMP_REF_ADC`, `ISO_COM`; 219 nets, 370 footprints. TP37's two wire stubs were merged into one (junction at 210.82 → the `ISO_COM` global label at 200.66). Holes H5–H9 were also removed by the user — pending the orientation decision (OPEN_ITEMS).
- 2026-09-17 — pre-S10 — **[BOARD] Outline closed and squared.** The hand re-placement had lost the top-edge segment under J5 (x 128 → 189.4, a 61.4 mm gap → DRC `invalid_outline`, which disables edge clearance and zone fills) and left the right edge 0.052 mm off vertical (top corner x 274.052); H2 sat at x 269.07. Restored the segment, right edge at x = 274.0 top to bottom, H2 at 269.0. Board stays 146 × 130 mm at origin (128, 89.95); the J20–J23 grid and the LaunchPad shadow rectangle were verified unchanged.
- 2026-09-17 — pre-S10 — **[PLACEMENT] The §B tightening list was applied by script (`tools/board_layout/tighten_s10.py`), on the user's go, with `9802b1b` as the revert point.** Entry caps now sit at their connector pins (DB37 row at y 207.5, one cap per pin, 2.3–6.6 mm; J3 7.6 mm, housing-limited), every ADC bucket is 3.1 mm from its header pad with the 100 Ω 6.6 mm upstream and SIN/COS geometrically identical, U18's 100 nF is 2.4 mm from VCC, U1's CIN 2.4 mm from VIN; R34 at D9, JP1 out of the LaunchPad shadow. U15/C88 shifted 4.2 mm right and three encoder parts (R113, R115, C104) a few mm to free the header cells. Verified: DRC 0 errors / 0 courtyard overlaps (silk 403, S11), parity H1–H4 only, netlist identical to golden, rendered and inspected. Not changed: U15↔`ISNS_VREF` caps ≈32 mm, U1 SW→L1 6.7 mm, D9 on the module-facing edge, TP30–35 under the LaunchPad. `pcbnew.SaveBoard` from Python 3.14 preserved the file format (diff = moved lines only).
- 2026-09-17 — pre-S10 — **🛑 [DEFECT] The 15:06 restore had also reset the board rule minimums in `.kicad_pro` to KiCad defaults** (git: S9 values from `cc62df2` to `629b836`, defaults again from `d0a6293`): min clearance/track 0/0.20 instead of 0.127/0.127, hole-to-hole 0.25 instead of 0.50, via annular 0.10 instead of 0.125, edge 0.50 instead of 0.30, silk clearance/text 0/0.8 instead of 0.15/1.0, `solder_mask_min_width` gone — two of them below JLC's floors and two checks switched off. Found only because "am I good to route?" prompted a diff of the whole `board.design_settings` block against the pre-restore backup, not just `net_settings`. Restored the S9 `rules` block (S9_BOARD_SETUP §4) from `_restore_backup_2026-09-17T15-06-19-842/FE_UFPR_4_0.kicad_pro`; DRC 0 errors with the stricter values. Lesson: a project-file restore is checked by diffing the **whole** `board.design_settings` and `net_settings` blocks against the last good commit, never one field.
- 2026-09-22 — S10 routing — **[PINMAP] `ISNS_A_ADC` ↔ `ISNS_C_ADC` swapped at the LaunchPad header (user), for routing.** JP3 (phase A) sits at the top of the current-sense column and JP5 (phase C) at the bottom, but A landed on the lower header pin (J22.16) and C on the upper (J22.12), so the two `*_SEL` routes had to cross. Now **A → J22.12 = J7-66 = ADCINA5, C → J22.16 = J7-68 = ADCINB4**; B unchanged. Captured by swapping the two hierarchical-label texts on `launchpad.kicad_sch`, and on the board by swapping R74↔R98 and C68↔C82 to each other's exact positions, the J22.12/16 pad nets, and the nets of the eight routed bucket→header stub segments (`tools/board_layout/swap_isns_ac.py`, run once). Gates: netlist diff vs the old `golden.net` = only J22 pins 12/16 exchanged between the two nets (re-baselined); ERC 0; DRC `--severity-all --schematic-parity` identical to before (0 errors, same warning counts, parity = H1–H4 only). Per-ADC load stays balanced (every phase still on its own converter) — the only consequence is the firmware channel select (OPEN_ITEMS, S12).
- 2026-09-23 — S10 routing — **[LAYOUT] U1 (LMR33630) copper: "the nets are too wide" was two rule problems, not a placement problem.** (a) Netclass track widths are only *defaults* for new tracks — DRC enforces the board minimum (0.127) and `.kicad_dru` rules only, verified with a 0.4 mm GND stub (zero `track_width` violations). Neck Power_3A/Power_1A tracks to pad width (0.6 mm) for the last 1–2 mm into 1.27 mm-pitch pins; the pad is the bottleneck, not the neck. (b) **All 18 zones carried KiCad's default 0.5 mm clearance** (plus 0.25 min width), so a pour needed 1.25 mm of free space and could not pass between U1's pins, between the 1.2 mm `+24V_PROT` track and pin 1, or reach C2's GND pad — the cause of 49 board-wide `starved_thermal` errors. Applied by `tools/board_layout/fix_s10_u1.py` (run once): every zone clearance 0.5 → **0.3 mm** (= Power_3A clearance, 3.3× JLC's 0.09 floor); `PWR_U1_SW` zone **solid**; footprint-level *solid* zone connection on U1 (EP), L1, C2, C3, C6 (SW node and Cin loop must not hang on thermal spokes); 0.6 mm GND stub pin 1 → EP; FB routed U1.5 → R6.1 → R5.2 (0.25); `+24V_PROT` via 1.0/0.5 between C2's pads + F/B stubs to R2.1. Gates: DRC starved 49 → 35 (none within 12 mm of U1), unconnected 67 → 51, `isolated_copper` 1 → 0, `shorting_items` 3 → 0; rendered F/B.Cu and inspected (EP + pin 1 + pour merge, SW island solid, via under C2 body). ⚠ Zone fills in the saved file are stale until the GUI refills (B) — `kicad-cli … --save-board` was not used on the project file.
- 2026-09-23 — S10 routing — **🛑 [DEFECT] The 2026-09-22 A↔C swap was only half applied.** `golden.net`, R74/R98/C68/C82 positions and the eight stub segments carried A → J22.12, but `launchpad.kicad_sch` still had A on J22.16 and the board's J22 pad nets followed the schematic — so the swapped stubs landed on the wrong-net pads and DRC reported three `shorting_items` at J22 pins 12/16. Root cause unproven (most likely the GUI saved a stale in-memory copy of the sheet over the script's edit). Fixed by exchanging the two hierarchical-label texts (git diff = exactly 2 lines) and the two pad nets; netlist now matches the decision, ERC unchanged. Lesson: after a script edits a file the GUI has open, **re-read the artifact after the next GUI save**, not just after the script.
- 2026-09-23 — S10 routing — **🛑 [DEFECT, recurrence] `b8f2aa2` (2026-09-22) rolled `FE_UFPR_4_0.kicad_pro` back to KiCad defaults again** — the same restore signature as 2026-09-17: CAN class + 4 patterns gone (5 classes / 24 patterns; `CAN_H/L` routing at Default 0.25/0.20), and `board.design_settings.rules` at min clearance/track **0/0.20**, hole-to-hole 0.25, annular 0.10, edge 0.5, silk 0/0.8, `solder_mask_min_width` gone. Both blocks restored verbatim from `586d0da` (key-by-key diff: nothing else in the file differed). Netlist `(class …)` check: CAN 4, Gate 23, Analog 61 (`*MOT_TEMP_*` back in Analog). DRC with the stricter minimums adds no new error. **Every session must diff both blocks against the last good commit before trusting a DRC run** — this is now the second time in five days.
- 2026-09-23 — S10 routing — **[GATE] `golden.net` re-baselined** to the user's schematic edits since `b8f2aa2`: U4 (iso DC/DC) and C23/C24 moved from `+24V_PROT`/`GND` to `+24V_MOD`/`PGND_MOD`, TP42/TP43 removed, plus the A/C fix above. Still 219 nets. Open consequence: ERC error `power_pin_not_driven` on U4 pin 1 (`PGND_MOD` has no power-output flag) — OPEN_ITEMS.
- 2026-09-23 — S10 routing — **[RULES] U2 (TPS62933F, SOT-583) pins 2 (EN) and 3 (VIN) could not be routed at all: the S9 `.dru` rule relaxed only pad-to-pad.** Both sit between the GND pins (1, 4); GND is Power_3A with 0.30 mm clearance, and a track centred on a 0.30 mm pad at 0.50 mm pitch is 0.35 − w/2 from the GND pad edge, so it would need w ≤ 0.10 mm. Two rules added to `FE_UFPR_4_0.kicad_dru`: **"U2 SOT-583 escape"** — clearance ≥ 0.15 mm between any two items that are U2 pads *or intersect U2's courtyard* (the courtyard term is what lets the two escapes coexist: they leave 0.5 mm apart, 0.20–0.225 mm edge-to-edge, below Power_1A's 0.25) — and **"U2 solid zone connection"** (pins 1/4/5 were `starved_thermal` on the GND and `PWR_U2_SW` zones; same intent as U1's footprint-level solid, as a rule because the board was open in the GUI). Verified on a scratch copy with real escapes: pin 2 → up 0.51 mm → 45° to R8.2, 0.25 mm; pin 3 → up 0.51 mm → 45° to R8.1, 0.30 mm; **the diagonals must start inside the courtyard (y ≤ 149.65)** — started 0.4 mm further out they fall outside the rule and DRC flags 0.225 mm. Result: U2 area clean, unconnected 44 → 41, only pre-existing C13 starved thermals remain. Rule file is read at every DRC run, so the GUI needs one DRC run (or a reopen) before the router honours it.

- 2026-09-23 — S10/S11 — **🛑 [DEFECT, root cause] The two project rollbacks were KiCad 10 Local History restores, not tool writes.** `.history/` (KiCad's local-history git repo, enabled by default) had a corrupt `main` since 2026-08-25; a Restore from that panel at 2026-09-17 15:06 and 2026-09-22 22:07 (KiCad open, no session running) copied the live files to `_restore_backup_<time>/` and checked out S7-era `FE_UFPR_4_0.kicad_sym` (md5 = the S7 snapshot) and schematic-freeze-era `FE_UFPR_4_0.kicad_pro`. The second restore also reverted three sheets and the `.kicad_sym` lost the six S8 symbols + `D_Zener_SOT-23` a second time (ERC 8 `lib_symbol_issues`, 53/60 units rendering) and nobody noticed because the schematic works from its embedded cache. **Decisions:** Local History disabled in `kicad_common.json`; the corrupt repo renamed `.history_corrupt_2026-09-23/`; `/.history*/` and `_restore_backup*/` ignored, both backup folders untracked (kept on disk — they are the good pre-restore copies); library restored from `_restore_backup_2026-09-22T22-07-53-839/` (backup ⊇ current, no differing symbol bodies): `kicad-cli sym export svg` 60 units, ERC only the known U4 `power_pin_not_driven`, netlist IDENTICAL to `golden.net`. Second, independent mechanism confirmed in the MCP server's own `project_settings_guard.py`: the backend writes a stale in-memory `.kicad_pro` on board saves and only preserves `net_settings` — restart the server after any hand edit of the project file. The session-start block diff stays as a gate.
- 2026-09-23 — S11 — **[BOARD] GND stitching pass applied (`tools/board_layout/stitch_s11.py`, record in `stitch_s11.applied.json`).** The routed board had 72 GND vias, two of them in the main F.Cu GND pour (84 pads), and three GND pins floating in fill slivers (U8.2 — the gate-enable AND gate —, U11.3, C107.2); DRC showed them only as anonymous zone-to-zone items. Added 326 vias (137 pad-adjacent with 0.3 mm stubs, 52 edge fence at 6 mm, 135 grid at 7 mm, 2 thermal under U3's tab into the In2 +3V3 pour) + 12 bare stubs + a hand-designed 0.14 mm corridor track for U8.2; assigned GND to six net-less vias; moved the +13V5 2×3 array to x 259.2/260.0 where the F.Cu and B.Cu +13V5 pours overlap. Placement rules: 0.30 mm to other-net copper by exact shape, 0.50 mm hole-to-hole, ≥ 1.0 mm from the edge, no via-in-pad, none under B.Cu parts. **Waiver:** `min_resolved_spokes 1` for C11, C13, L2, U17 (boxed in; one 0.5 mm spoke = a 0.5 mm track). Gate: `starved_thermal` 33 → 0, unconnected 8 → 0, `via_dangling` 7 → 1 (spare +5V via), 0 errors, no new violation type, netlist IDENTICAL. Lesson: KiCad counts a same-net track entering a fill as a thermal spoke, so a stub is the cheapest starved-thermal fix; `A.Reference` works on pads in `.kicad_dru` conditions.
- 2026-09-23 — S11 — **[BOARD] Pre-fab pass applied (`tools/board_layout/prefab_s11.py`, record `prefab_s11.applied.json`; run once, on the user's go).** (a) **H1–H4 M3 → M4 (user):** `MountingHole_4.3mm_M4_ISO7380`. The generic M4 footprint's courtyard (r 4.55) overlaps Q1's at H2 (Q1's courtyard is 4.26 mm from the hole centre, its tab pad corner 4.61 mm); the ISO 7380 button-head variant (r 4.05) is the largest KiCad variant that clears, so it is used on all four — **a Ø9 mm washer at H2 would touch Q1's tab pad** (OPEN_ITEMS). `board_only` on all four: the parity check is clean without schematic symbols. (b) The spare `+5V` via (208.335, 181.4) deleted. (c) Silk title texts replaced. (d) **Reference designators placed by search** (pcbnew geometry: no pad within 0.2 mm, no silk within 0.15, no other reference, not over another part's fab body, ≥ 0.5 mm from the edge; 1.0/0.15 mm; 4 sides × 0.5 mm slides × gaps to 3 mm, 4 mm for J/U/TP/JP/D): 311 placed, **52 hidden** (36 R, 12 C, TP11/13/21/22) where nothing fits — JLC places from the CPL and F.Fab keeps `${REFERENCE}`. Five solder-jumper pad-number labels that sat on neighbours' silk removed (JP1 1/3, JP3 1, JP4 3, JP5 3), three nudged. Silk warnings **368 → 7**: R24's outline crossing J2's (placement, cosmetic) and J2/J5 bodies over the edge (by design). (e) `PWR_FLAG` #FLG07 on `PGND_MOD` at the NT2 star (`tools/schematic_layout/add_pwr_flag_pgnd.py`): ERC 0; power symbols are not in the netlist, so `golden.net` needed no re-baseline (IDENTICAL). Gates on the live files: DRC `--severity-all --schematic-parity` 0 errors / 0 unconnected / parity clean, ERC 0, netlist IDENTICAL, `.kicad_pro` md5 unchanged, rendered and inspected. Studied, not applied: **net-name silk labels on the test points** (user's idea) — `--tp-only --tp-labels=only` fits 38 of 48 names at 1.0 mm on the applied board, 6 keep `TPxx`, 4 stay blank (TP11/13/21/22, already hidden); DRC unchanged; the user decides.
- 2026-09-23 — S11 — **🛑 [DEFECT, third rollback mechanism] `pcbnew.SaveBoard(path)` always writes `<stem>.kicad_pro` (+ `.kicad_prl`) next to the board it saves.** Measured on copies: a board loaded with its own project alongside saves the project file back byte-identical; a board loaded from a scratch copy with a different stem (no project found → KiCad defaults in memory) **overwrites an existing `.kicad_pro` with defaults** on save (22.7 KB → 9.6 KB: min track 0.2, clearance 0, hole-to-hole 0.25, annular 0.1, edge 0.5, one netclass) — exactly the 2026-09-17 / 2026-09-22 rollback signature. Local History is still the proven cause of those two (the `_restore_backup_*` folders), but every board script is one rename away from doing the same. **Rule:** scripts load a board only from a directory that holds the same-stem `.kicad_pro`, save only into scratch, copy back the `.kicad_pcb` alone, and assert the `.kicad_pro` md5 before/after (`prefab_s11.py` does all four).
- 2026-09-23 — S11 — **[SILK] Test points carry their net name on silk instead of `TPxx` (user's go; `tools/board_layout/tp_labels.applied.json`).** `prefab_s11.py --tp-only --tp-labels=only` on the committed board: 38 of 48 names fit at 1.0 mm; then `tp_db37_labels.py` for the DB37 row, where the six PWM pads (2.6–3.25 mm pitch) got one 2-letter label each (`WH WL VH VL UH UL`) under a `PWM 15V` legend, and TP19/TP21/TP22 got `VBUS`/`RTN`/`NTC` (R57 and J2 references nudged 0.3 / 0.2 mm; C44's reference hidden — boxed in on all four sides). Result: 36 full names, 9 short, TP2/TP28/TP32 keep `TPxx`, no blank test point; DRC unchanged at 7 by-design warnings, `.kicad_pro` md5 unchanged. Why: a probe on the bench needs the signal, not a number to look up; the number stays on F.Fab and in the S12 handoff. Lesson: KiCad's text box is 1.7 mm tall for 1.0 mm text, and a second `fp.Remove()` breaks pcbnew's SWIG proxies (`TOOLING_NOTES.md`).
- 2026-09-23 — pre-S12 — **[PREP] S12 prepared, not started (`S12_PREP.md`).** `kicad-cli` BOM / pos / gerber / drill exports dry-run into the scratchpad (no plugin installed; fabrication-toolkit not needed). New `tools/fab/jlc_verify.py` (live JLCSearch check of every LCSC line, curl-based) and `tools/fab/jlc_bomcpl.py` (JLC-format BOM + CPL with a rotation-offset table). Baseline: 71 real LCSC lines / 63 codes, all found, none out of stock, 33 plain-Extended lines ($92.10 fees, matches the 2026-09-17 audit), $140.63 parts for 5 boards; low stock U4 (362), U2 (2 255), `C77033` 2.2 nF C0G (2 265 for 50). Handoff answers pre-filled from the S-docs for `control_v2_pinmap.md` (A↔C swap, fault = HIGH, 341.538, 2039/1745, per-source `LEM_V_PER_A`, NTC/KTY/CAN/switch pins) — to be re-read off the schematic in S12. Decisions parked for S12: U4 consign, the 12 B.Cu parts vs single-side Economic PCBA, `HW_NAME`, coating.
- 2026-09-23 — S12 — **🛑 [DEFECT, closed] The six `C22936` (1 Ω) placements from the 2026-09-17 finding were still in the schematic at the start of S12** — R35, R67, R77, R89, R104, R118: the three shield bleeds (`SHIELD_DB37/LEM/ENC` → GND) and the three module-sensor bleeds (`ISNS_x_RAW` → GND). The kit table had been corrected on the 17th; the symbols never were, and `jlc_verify.py` passed the line because it compared package only (0603 = 0603). Fixed to `C22935` (`0603WAF1004T5E`, Basic) by `tools/fab/fix_c22936.sh` — LCSC property only, in the three sheets and on the six board footprints (the first DRC after the sheet fix reported 6 `footprint_symbol_field_mismatch`, which is the parity check doing its job); ERC 0, netlist identical to `golden.net`. `jlc_verify.py` now parses the BOM R/C value and JLC's description and flags `VALUE_MISMATCH` (proved on the as-is BOM before the fix). Lesson: a logged defect that says "not yet changed" is an open item until a *gate* proves it closed; the script that vets the BOM must read the value, not just the code.
- 2026-09-23 — S12 — **[FAB] Package = `kicad-cli` + `tools/fab/` scripts, committed in `fab/`** (gerbers unzipped, JLC BOM/CPL, `jlc_verify.md/.json`, raw `kicad_bom.csv`, README with the order options); the zip is rebuilt by `make_package.sh` and git-ignored. CPL rebased to the board's bottom-left corner (`--origin 127.95,219.9`; the board has no aux origin) with rotations normalised 0–360 — page-origin coordinates (x 128–274, y −90…−220) import at JLC but defeat the placement preview. No plugin dependency.
- 2026-09-23 — S12 — **[FAB] CPL rotation table seeded from the JLCKicadTools community DB, NOT audited** (`tools/fab/jlc_rotations.json`: SOT-23 and SOT-23-6 −90, SOIC-8 and HSOP-8 270, SOT-223 180, CP_Elec 180, diodes/LEDs/SOT-583/TO-252/optos 0). The seed is not a verification: **the order is not paid until the offsets are confirmed on JLC's placement preview** (`S12_FAB_PACKAGE.md` §3). D17 (SMA, bottom) is the only polarised bottom-side part.
- 2026-09-23 — S12 — **[DECISION, user] U4 URA2415YMD-6WR3 is JLC-placed** (`C5369735`, 304 in stock on the day, $6.38 + $3.07 feeder). Consigning would have saved ≈ $41 on the run for an extra THT hand-solder and a separate purchase; if stock is 0 on order day, fall back to consign + hand-solder.
- 2026-09-23 — S12 — **[DECISION, user] Economic single-side PCBA; the 12 B.Cu SMD parts (R2/R3, D17/C119, C25–C28, R118/R119/C113/C120) are hand-soldered by the team** — `make_package.sh` drops them from the BOM/CPL (`--hand-solder`) and prints the list. Standard two-sided would have cost +$62.12 flat (2026-09-17 quote) for twelve 0603/0805/SMA parts on 5 boards.
- 2026-09-23 — S12 — **[DECISION, user] `HW_NAME` → `"FE_UFPR_4_0"`; conformal coating: none before bring-up**, team-applied acrylic after the first article passes, with DB37, DTM cavities, LaunchPad headers, all test points and JP1–JP6 masked. JLC PCBA offers no coating; coating first would hide everything the bring-up sheet probes.
- 2026-09-23 — S12 — **[HANDOFF] `S12_FIRMWARE_HANDOFF.md` answers `control_v2_pinmap.md` line by line from the netlist and SPRUI77 Tables 1–4.** Verified on the way: every header pin in the CLAUDE.md pin map matches netlist pad ↔ SPRUI77, including the ISR probe GPIO67 = J1-5 = TP48 (was "unverified"). Constants handed over: `MODULE_FAULT_ACTIVE_LOW 0`, A↔C swap (`IU` → ADCINA5, `IW` → ADCINB4, `ISENSE_NUM_CHANNELS 3`), per-source 4.800 / 4.886 mV/A with bias 2048 / 2005 codes, `VBUS_DIVIDER_RATIO 341.538`, `RES_SINCOS 2039 / 1745`, NTC ÷3.553 on ADCINC3, KTY81-210 on ADCINB3 with the rail on ADCINA3 (`R = 2200·V/(V_rail−V)`, fault window 1400–3100), CAN-A GPIO4/5, switches GPIO29/59. Bench-only items listed in its §14.
- 2026-09-24 — S12 order — **[DECISION, user] At JLC's BOM-matching step J20–J23 (2×10 headers), U4 URA2415YMD-6WR3 and U12–U17 OPA2376 were deselected for cost and are bought at LCSC and hand-soldered** — reverses D1 (U4 JLC-placed). Net saving ≈ $25–30 (mostly two feeder fees and JLC's markup; the parts themselves are still bought), cost = 30 hand-soldered SOIC-8 on the precision analog core — inspect under magnification, bring-up step E (`ISNS_VREF`, bias points, encoder amplitudes) is the acceptance test. The matching export (`fab/jlc_order_2026-09-24.xlsx`) was checked line by line against `fab/FE_UFPR_4_0_BOM.csv`: 70 lines / 289 designators identical, every code matched 1:1, no substitutions, 64 selected, est. parts $92.68, feeder fees unchanged ($92.10, 30 Extended codes).
- 2026-09-24 — S12 order — **[TOOLING] `jlc_bomcpl.py` groups BOM lines by footprint + LCSC, not by value, and writes `FE_UFPR_4_0_HANDSOLDER_BOM.csv`.** JLC had matched D4–D9 (values `red +24V_PROT` … `RED GATE_EN`, one part `C2286`) as six lines, flagged all six "Unconfirmed — multiple lines matched to the same part" and priced each at the full 30 pcs (180 LEDs for $1.35). Same pattern on J20–J23. Grouping by footprint + code makes them one line each (59 lines instead of 70). The hand-solder BOM lists the bottom-side parts, the lines deselected at JLC and the consigned connectors with LCSC code, per-board / run quantities and a spare rule (passives +20 % min +5, ICs +5, headers +2, module +1). `make_package.sh` now leaves a gerber/drill file untouched when only its `CreationDate` header would change, so a rebuild does not churn 16 files in git.
- 2026-09-24 — S12 order — **[DECISION, user] 2 boards assembled (of the 5 PCBs); the hand-solder shopping list orders enough for 3 boards** (`make_package.sh [assembled]`, `--boards 2 --spare-boards 1`; the earlier percentage spare rule is gone). 18× OPA2376, 3× URA2415, 12× headers, 3 sets of the bottom-side parts, 3 of each connector.

- 2026-09-23 — S12.5 connector swap — **[CONSTRAINT, user] Connectors are not purchased: the team gets them through TE's student sample program.** Distributor stock is irrelevant; the gate is TE's "Amostras disponíveis" filter / the OBTER AMOSTRA button. Checked live in the user's browser: of 37 DTM headers only four are sampleable and all four are the 101 mm EEC-325X4 telematics parts (DTM13-12PA-R008/-R019/-R020, DTM13-12PA-12PB-R008); **DTM13-12PA/PB-R005 and DTM13-08PA-R004 — the parts on the board since S7/S8 — are not.** DT family: DT15-12PA, DTF15-12PA, DT15-08PD, DT13-08PA, DT06-12SA, DT06-08SA, W12S, W8S, 0462-201-16141, 1062-16-0122 yes; DT06-12SB, DT06-08SD no.
- 2026-09-23 — S12.5 — **[CORRECTION] TE does list vertical DTM headers: `DTM15-12PA/PB/PC/PD` (drawing C-DTM15-12PX rev B2).** The S7 finding "no vertical board-mount DTM13" was a naming miss (vertical = DTM15). None is sampleable, no vertical 8-way DTM exists, and the DTM15 is a 61 × 33 mm panel-flange part with the PCB screwed to its rear face — recorded so the question is not re-opened.
- 2026-09-23 — S12.5 — **[DECISION, user: "all verticals, sampleable preferred"] J3 → DT15-12PA (key A, sampleable), J4 → DT15-12PB (key B, NOT sampleable — kept because key B is the mechanical guard against the ±15 V LEM harness), J5 → DT15-08PD (key D, sampleable).** Chosen so the schematic symbols and the netlist stay untouched (same pin counts; net membership identical to `golden.net`); J5 key D also excludes every A/B/C 8-way plug. Rejected: DTF15-12PA (flangeless, TE says pot it in place), DT13-24PAB-R015 (143 mm), two key-A 12-ways (look-alike hazard S8 forbade).
- 2026-09-23 — S12.5 — **[LIBRARY] `DEUTSCH_DT15-12P_Vertical` and `DEUTSCH_DT15-08P_Vertical` hand-derived from TE drawings C-DT15-12PX rev D2 and C-DT15-08PX-XXXX rev A (`datasheets/`, downloaded by the user from the product pages).** Mating-face view, key end at −y, pin 1 bottom-left, 1..N/2 up the left column then down the right — the cavity numbers are printed on both drawings, so the S7 extrapolation caveat is gone. Pins Ø1.57 → drill 2.0 / pad 2.8; columns ±4.56; rows ±2.22/±6.67/±11.11 (12) and ±2.73/±7.175 (8, TE's own PCB layout on sheet 2); screws ±10.67 × ±17.54 / ±13.6 → Ø3.5 NPTH (TE recommends 3.43 +0.13); courtyard = flange outline 35.26 × 59.21 / 55.12; B.Fab + B.CrtYd Ø7/7.5 circles for the screw heads. Bodies: `tools/board_layout/gen_3d_dt15.py` (cadquery). Both render (`fp export svg`); the DTM13 footprints and bodies stay in the library, unused.
- 2026-09-23 — S12.5 — **[BOARD] Footprint swap done with pcbnew on a scratch copy and only the three footprint blocks spliced into the project `.kicad_pcb` (1919-line diff, `.kicad_pro` untouched).** Position/rotation/path/fields kept, pad nets re-assigned by number (must happen after `board.Add`), Description copied from the old instance (else `--schematic-parity` warns). J5 gained MPN/Manufacturer fields in the schematic (S8 never set them). Result: ERC 0, parity 0, DRC 653 / 18 unconnected / 18 dangling — every one at J3/J4/J5's old positions, for the user to re-place and re-route. **`fab/` is stale.**
- 2026-09-23 — S12.5 — **[GATE] `golden.net` re-baselined.** The committed golden still carried the six `C22936` lines that S12 fixed in the sheets (S12 did not refresh it); the new golden = today's export (only J3/J4/J5 value/footprint/MPN + those six LCSC lines + one uuid-order line differ; nets and nodes identical). `kicad-cli sch export netlist` prints "schematic has annotation errors" on the `a077914` sheets too — pre-existing, in `OPEN_ITEMS.md`.

- 2026-09-24 — S12.6 re-placement (branch `dt15-vertical`, user: "try on your own… expanding the board a bit is fine") — **[BOARD] Outline extended 32 mm to the left (x 127.95 → 96.0, 178 × 130 mm).** Three 35 × 59/55 mm bodies do not fit the old 58 mm left strip with H1/H3 in its corners and U4 at the bottom; the old right-angle housings already occupied that airspace, so the envelope is unchanged. GND plane and `ISO_COM_PLANE` extended (ISO island now x 96.25–166.95 below y 159.6 plus the old notch to y 149.45 east of x 132.6).
- 2026-09-24 — S12.6 — **[PLACEMENT] J5 (114.2, 128.0), J4 (151.1, 129.2), J3 (114.5, 189.5), all rot 180 (long axis along y, key end down, pin 1 top-right).** J4 next to the encoder front-end (TP38/39/44/53, C99/C100 shifted +3 mm), J3 beside U4 and the LEM burdens, J5 top-left with its 7 nets in lanes along the top edge. All three are parallel already — a 90° stack of horizontal bars would land the bottom one on U4 and the LEM column (rejected). H1 → (101, 95), H3 → (136.6, 214.9); satellites under their connector on B.Cu (C25–C28 under J3, R118/R119/C113/C120 under J4, C119/D17 under J5), C92–C95/D8/R17/TP6/TP7 regrouped left of U4; the B.Cu logo → (139.5, 174.5). **12 B.Cu rule areas (Ø7.8 octagons, no pour/track/via) under the #4-20 screw heads.**
- 2026-09-24 — S12.6 — **[ROUTING] Old tracks of the 19 affected nets stripped by a DRC-driven dangling loop (not by net), the eastern parts of the J5/COS/MOT_TEMP routes restored from the pre-swap board, then ~60 new segments by script.** J5: CAN pair on F.Cu (lanes y 94.0/94.7, one B.Cu via-jog for CAN_L at the east end because the pair must swap sides); SW_MAIN_RTN / Pin3 / SW_START_RTN / Pin4 / +5V_VEH on B.Cu lanes y 96.0–98.2 (order forced by the target x of the restored verticals at 170.55–171.9; Pin3 exits its pad on F.Cu + via to keep the order); J4: ENC nets on F.Cu straight east; J3: LEM_A/B/C on F.Cu at their pad rows with verticals at x 158/160/162, ±15 V on B.Cu (+15 V) / F.Cu corridor y 209.5 (−15 V), SHIELD_LEM on B.Cu with the via at (164.9, 187.5) — an ISO_COM In2 track runs along y 184.2 there. Two S11 GND stitching vias on the new lanes removed. Result: DRC 0 errors, 0 unconnected, parity 0, 5 by-design silk warnings; netlist untouched.
- 2026-09-24 — S12.6 — **🛑 [DEFECT, closed] The DT15 footprint instances carried `LCSC`/`MPN`/`Manufacturer` fields created by `SetField()` — default layer F.SilkS, visible, all at one point → 9 anonymous `silk_overlap` warnings (empty item lists) that no silk bisect could explain.** Fixed by putting them on F.Fab hidden like the JLC-synced parts. Recorded in `TOOLING_NOTES.md`.
- 2026-09-24 — S12.6 — **[LIBRARY] The two DT15 footprints' silk outlines are single `fp_poly` rounded rectangles** (the 4-line + 4-arc outline was replaced while chasing the warnings above; harmless either way). `tools/fab/make_package.sh` origin → 96.0,219.9. **`fab/` not rebuilt: KiCad held the board open (lock files) at the end of the session** — the routed `.kicad_pcb` was copied onto the project file anyway (the user must File → Revert in pcbnew, not save).
- 2026-09-24 — S12.6 — **[REVIEW, user: "looks pretty good"] Longer traces from the 32 mm extension measured (`tools/board_layout/dt15_place/7_net_lengths.py`, S12 `a077914` vs `87340d5`) and judged harmless.** CAN_L/H 33/32 → 154/134 mm (+120/+103, legs differ by 19 mm ≈ 0.1 ns against 1 µs bits and tens of ns of transceiver skew; pair coupled at the diff-pair rule for most of the run); the four switch nets 86–97 → 172–200 mm and +5V_VEH 24 → 97 mm (DC through pull-ups/filters; their B.Cu lanes leave the L2 plane untouched); LEM_A/B/C_M +60 mm each (a current-source signal: 60 mm × 0.30 mm 1 oz ≈ 0.1 Ω in series with the 23.5 Ω burden, against 48 Ω of compliance margin in `S6_CURRENT_SENSE_DESIGN.md` §1.2 — the burden voltage is developed at the resistor, so the reading does not move); SHIELD_LEM +53, MOT_TEMP_RAW +47 (DC); ENC_SIN/COS_RAW +9/+12 mm, SIN-vs-COS mismatch 17 → 14 mm (≈ 1.4 pF / 20 mΩ against nF / kΩ — what must match is the RC, not the track); ±15V_ISO 20 mm *shorter* (ISO caps regrouped by U4). Nothing to change; the 19 mm CAN skew is cosmetic if ever tidied.
- 2026-09-26 — S12.6 — **[COST] JLC feeder fee cut from 27 to 14 Extended codes ($82.89 → $42.98), user-chosen tiers A + B + B+ + C; this partially supersedes the 2026-09-17 "nothing cuttable — do not re-attempt" audit.** Live re-audit (JLCSearch + local DB): no Basic/Preferred exists for any 0.1 % resistor, any C0G ≥ 1 nF except 2.2 nF 0805 `C28260`, the logic/driver/buck ICs, fuses, inductors, the CAN choke or the 100 µF electrolytic. Taken: **(A)** R10/R11 52.3 k/10 k → **68 k `C23231` / 13 k `C22797`** (Basic; FB node has no feed-forward cap; +5V 4.985 V) and D1 SMCJ26A → **SMCJ26CA `C19077605`** (Preferred, same SMC footprint; hongjiacheng datasheet 26 V / 28.9–31.9 V / 42.1 V @ 35.7 A / 1500 W; bidirectional is harmless because D1 sits after Q1); **(C)** Vbus R57/R58 2.20 k/1.50 k → **3.00 k/2.20 k** (the R105/R129 lines, same RT0603B family so the ratio still tracks) → gain 0.423077, Rth 1269 Ω, fc 1583 Hz, FS **981.8 V**, **`VBUS_DIVIDER_RATIO` 341.538 → 327.273**, 0.239702 V/code — handoff doc updated, firmware repo untouched; **(B/B+)** C1, F1–F3, L3, U8, R57/R105, R58/R129, Q1, U5–U7 added to `HAND=` (a team member buys them in China; no import). Not taken: 2.2 nF → 0805 Basic (layout), more hand-soldering of the matched analog networks. Gates: ERC 0; netlist connectivity identical, `golden.net` re-baselined (field-only diff: Value/LCSC/Description/lib part of R10, R11, R57, R58, D1); DRC 0 / 0 / parity 0 + the 5 by-design silk warnings; `fab/` rebuilt, gerbers unchanged. D1's `lib_id` → `D_TVS` done by in-place text edit after the MCP swap proved to re-UUID the symbol (`TOOLING_NOTES.md`); board fields updated per footprint block.
