josearistidesbail/FE_UFPR_4_0/3dmodels/DEUTSCH_DT15-12P_Vertical.step

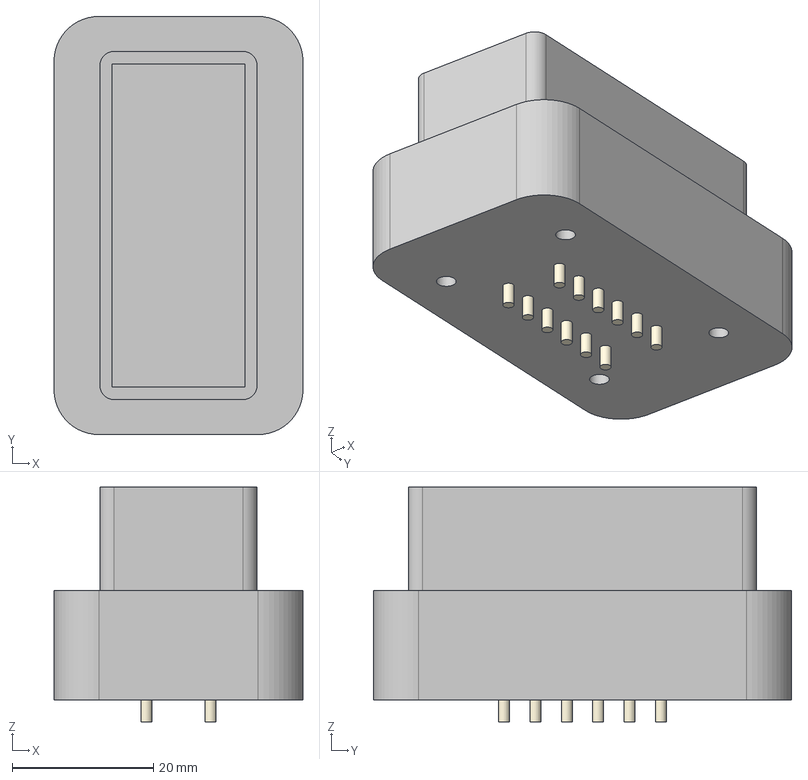
[picture p1: CAD file, 2026-09-26]
3dmodels/DEUTSCH_DT15-12P_Vertical.step
35.3 x 59.2 x 33.2 mm
DEUTSCH_DT15-12P_Vertical_0
DEUTSCH_DT15-12P_Vertical_1
DEUTSCH_DT15-12P_Vertical_2
DEUTSCH_DT15-12P_Vertical_3
DEUTSCH_DT15-12P_Vertical_4
DEUTSCH_DT15-12P_Vertical_5
DEUTSCH_DT15-12P_Vertical_6
DEUTSCH_DT15-12P_Vertical_7
DEUTSCH_DT15-12P_Vertical_8
DEUTSCH_DT15-12P_Vertical_9
DEUTSCH_DT15-12P_Vertical_10
DEUTSCH_DT15-12P_Vertical_11
DEUTSCH_DT15-12P_Vertical_12
DEUTSCH_DT15-12P_Vertical_13
