josearistidesbail/FE_UFPR_4_0/3dmodels/Converter_DCDC_Mornsun_URA-YMD-6WR3_THT.step

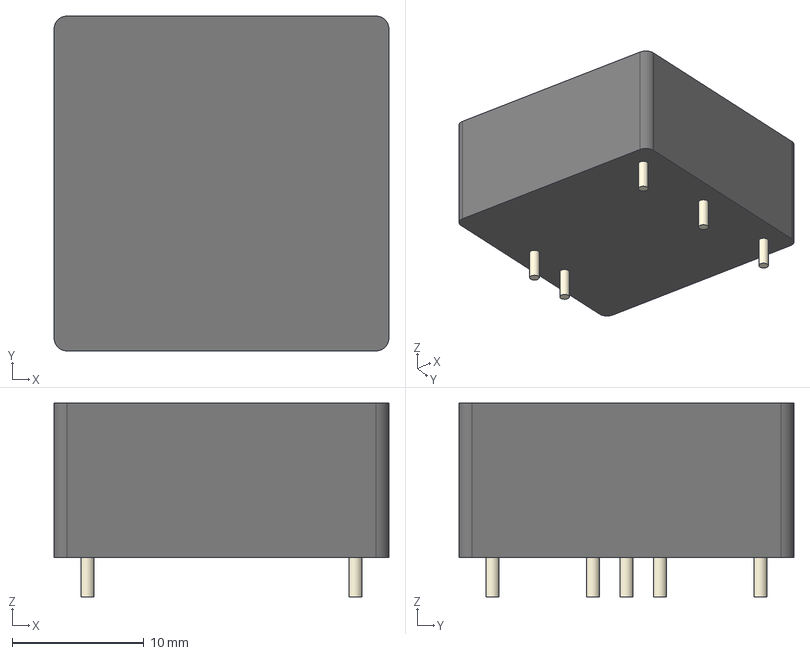
[picture p3: CAD file, 2026-09-17]
3dmodels/Converter_DCDC_Mornsun_URA-YMD-6WR3_THT.step
25.4 x 25.4 x 14.7 mm
Converter_DCDC_Mornsun_URA-YMD-6WR3_THT_0
Converter_DCDC_Mornsun_URA-YMD-6WR3_THT_1
Converter_DCDC_Mornsun_URA-YMD-6WR3_THT_2
Converter_DCDC_Mornsun_URA-YMD-6WR3_THT_3
Converter_DCDC_Mornsun_URA-YMD-6WR3_THT_4
Converter_DCDC_Mornsun_URA-YMD-6WR3_THT_5
