josearistidesbail/FE_UFPR_4_0/3dmodels/L_CommonMode_TDK_ACT45B.step

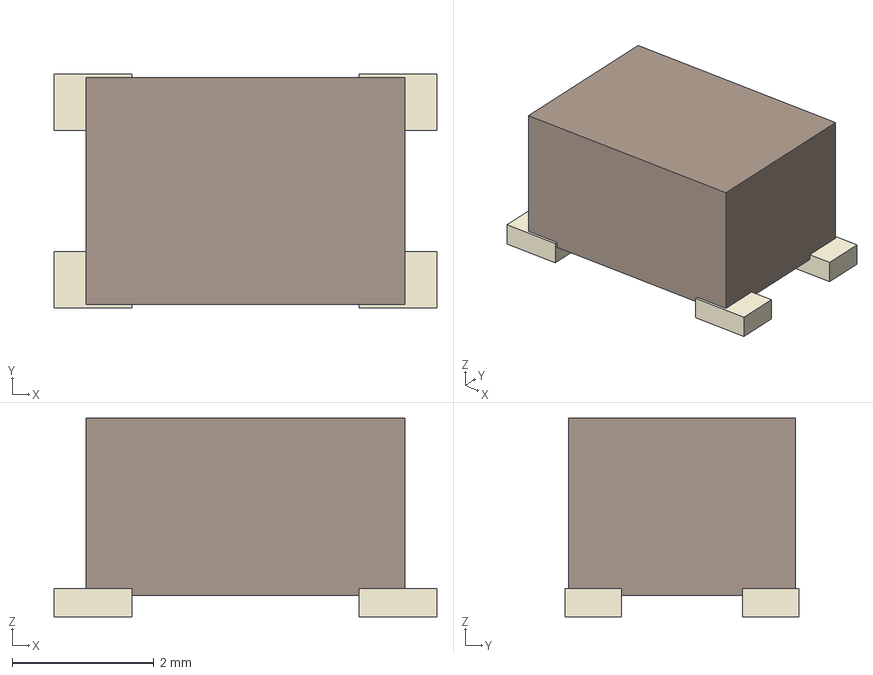
[picture p4: CAD file, 2026-09-17]
3dmodels/L_CommonMode_TDK_ACT45B.step
5.40 x 3.30 x 2.80 mm
L_CommonMode_TDK_ACT45B_0
L_CommonMode_TDK_ACT45B_1
L_CommonMode_TDK_ACT45B_2
L_CommonMode_TDK_ACT45B_3
L_CommonMode_TDK_ACT45B_4
