josearistidesbail/FE_UFPR_4_0/3dmodels/LaunchPad_LAUNCHXL-F28379D_Shadow.step

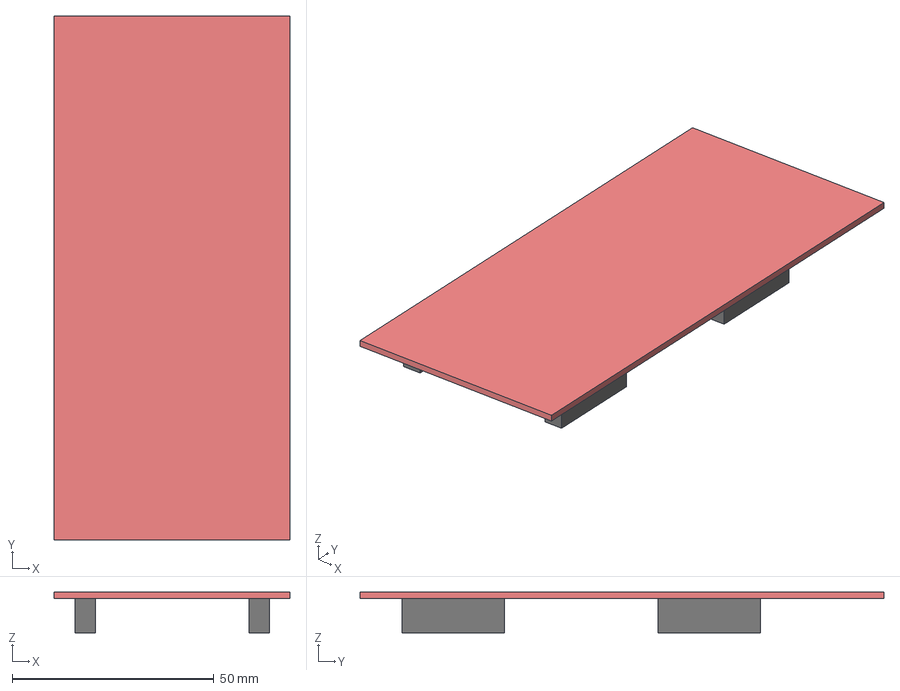
[picture p5: CAD file, 2026-09-17]
3dmodels/LaunchPad_LAUNCHXL-F28379D_Shadow.step
58.4 x 129.9 x 10.1 mm
LaunchPad_LAUNCHXL-F28379D_Shadow_0
LaunchPad_LAUNCHXL-F28379D_Shadow_1
LaunchPad_LAUNCHXL-F28379D_Shadow_2
LaunchPad_LAUNCHXL-F28379D_Shadow_3
LaunchPad_LAUNCHXL-F28379D_Shadow_4
