josearistidesbail/FE_UFPR_4_0/3dmodels/DEUTSCH_DTM13-12P-R005_Horizontal.step

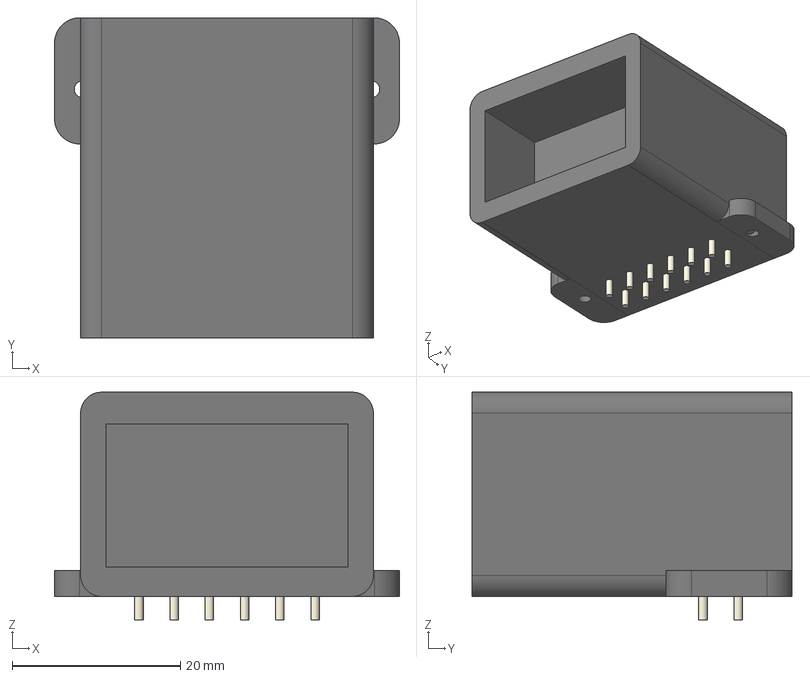
[picture p6: CAD file, 2026-09-17]
3dmodels/DEUTSCH_DTM13-12P-R005_Horizontal.step
41.0 x 38.1 x 27.1 mm
DEUTSCH_DTM13-12P-R005_Horizontal_0
DEUTSCH_DTM13-12P-R005_Horizontal_1
DEUTSCH_DTM13-12P-R005_Horizontal_2
DEUTSCH_DTM13-12P-R005_Horizontal_3
DEUTSCH_DTM13-12P-R005_Horizontal_4
DEUTSCH_DTM13-12P-R005_Horizontal_5
DEUTSCH_DTM13-12P-R005_Horizontal_6
DEUTSCH_DTM13-12P-R005_Horizontal_7
DEUTSCH_DTM13-12P-R005_Horizontal_8
DEUTSCH_DTM13-12P-R005_Horizontal_9
DEUTSCH_DTM13-12P-R005_Horizontal_10
DEUTSCH_DTM13-12P-R005_Horizontal_11
DEUTSCH_DTM13-12P-R005_Horizontal_12
DEUTSCH_DTM13-12P-R005_Horizontal_13
