josearistidesbail/FE_UFPR_4_0/3dmodels/DEUTSCH_DTM13-08PA-R004_Horizontal.step

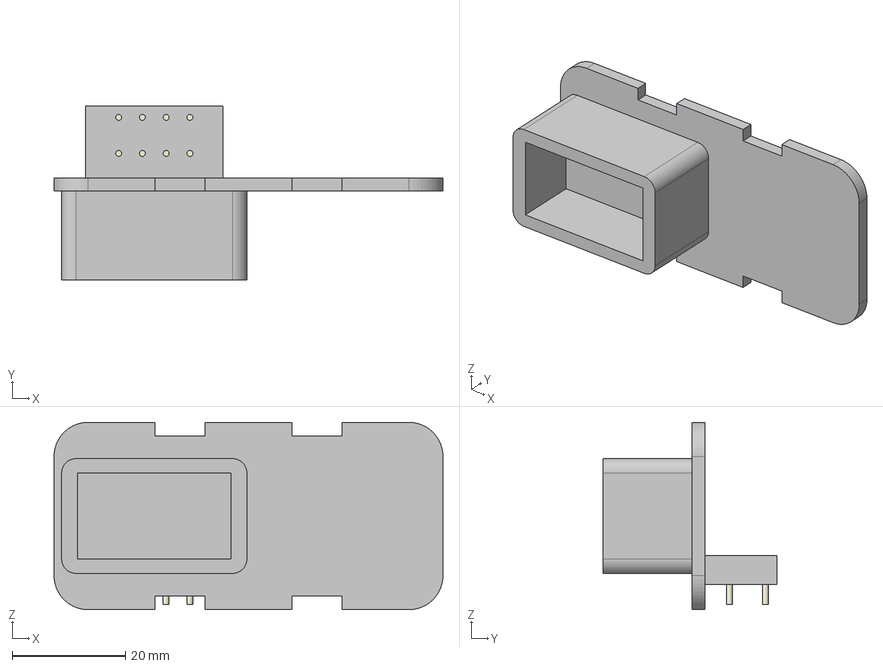
[picture p7: CAD file, 2026-09-17]
3dmodels/DEUTSCH_DTM13-08PA-R004_Horizontal.step
68.6 x 30.7 x 33.0 mm
DEUTSCH_DTM13-08PA-R004_Horizontal_0
DEUTSCH_DTM13-08PA-R004_Horizontal_1
DEUTSCH_DTM13-08PA-R004_Horizontal_2
DEUTSCH_DTM13-08PA-R004_Horizontal_3
DEUTSCH_DTM13-08PA-R004_Horizontal_4
DEUTSCH_DTM13-08PA-R004_Horizontal_5
DEUTSCH_DTM13-08PA-R004_Horizontal_6
DEUTSCH_DTM13-08PA-R004_Horizontal_7
DEUTSCH_DTM13-08PA-R004_Horizontal_8
DEUTSCH_DTM13-08PA-R004_Horizontal_9
DEUTSCH_DTM13-08PA-R004_Horizontal_10
