josearistidesbail/FE_UFPR_4_0/3dmodels/Fuse_2410_6125Metric.step

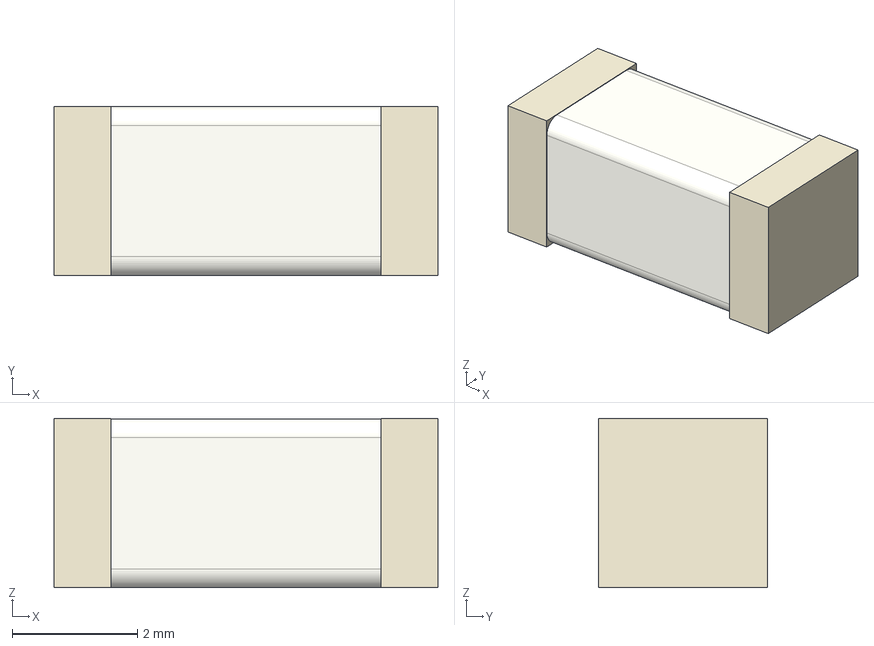
[picture p8: CAD file, 2026-09-17]
3dmodels/Fuse_2410_6125Metric.step
6.12 x 2.70 x 2.70 mm
Fuse_2410_6125Metric_0
Fuse_2410_6125Metric_1
Fuse_2410_6125Metric_2
