josearistidesbail/FE_UFPR_4_0/tools/fab/hand_assembly_template.html

# FE_UFPR 4.0 · hand assembly

Board + board S/N

Export Import Reset board

Top side Bottom side (flipped L-R) Fit click part = soldered · shift-click = flag rework · wheel = zoom · drag = pan · ● pad 1 (ICs, Q1, connectors; L3 fits either way) · ▮ black pad = stripe on the part goes here (C1 −, D17 cathode) · ━ bridge
