josearistidesbail/FE_UFPR_4_0/fab/jlc_verify.md

# JLC re-verification 2026-09-26 — 2 boards

**14 Extended codes placed by JLC = feeder fee $42.98 (13 more Extended codes hand-soldered, no fee).**

| LCSC | Refs | Value | Pkg (KiCad) | Pkg (JLC) | Stock | Need | Price | Basic/Pref | Flags |
|---|---|---|---|---|---|---|---|---|---|
| `C10429` | U9-U11,U21 | SN74LVC2G17DBVR | SOT-23-6 | SOT-23-6 | 107122 | 8 | 0.3346 |  | EXTENDED |
| `C106246` | C37-C53,C58,C60,C64,C65,C70,C7 | 1nF C0G | C_0603_1608Metric | 0603 | 127722 | 60 | 0.0075 |  | EXTENDED |
| `C136963` | R57,R105 | 3.00k 0.1% | R_0603_1608Metric | 0603 | 30010 | 4 | 0.0287 |  | EXTENDED HAND_SOLDER |
| `C15857` | L1 | 22uH | L_Sunlord_SWPA8040S | SMD,8x8mm | 4688 | 2 | 0.1601 |  | EXTENDED |
| `C167960` | L2 | 3.3uH | L_Changjiang_FNR5040S | SMD,5x5mm | 5331 | 2 | 0.0599 |  | EXTENDED |
| `C182445` | F2 | 3A 63V | Fuse_1206_3216Metric | 1206 | 43061 | 2 | 0.0384 |  | EXTENDED HAND_SOLDER |
| `C22046` | U8 | SN74LVC1G11DBVR | SOT-23-6 | SOT-23-6 | 10443 | 2 | 0.1829 |  | EXTENDED HAND_SOLDER |
| `C2836439` | C1 | 100uF 50V | CP_Elec_8x10.5 | SMD,D8xL10.2mm | 42082 | 2 | 0.0842 |  | EXTENDED HAND_SOLDER |
| `C2925443` | D17 | SMAJ5.0A | D_SMA | SMA(DO-214AC) | 64985 | 2 | 0.0388 | P | HAND_SOLDER |
| `C326735` | R65,R66,R70,R71,R76,R79,R82,R8 | 12.0k 0.1% | R_0603_1608Metric | 0603 | 10395 | 36 | 0.0321 |  | EXTENDED |
| `C3281500` | Q1 | SQD50P06-15L | TO-252-2 | TO-252 | 7471 | 2 | 1.4259 |  | EXTENDED HAND_SOLDER |
| `C46316` | U12-U17 | OPA2376 | SOIC-8_3.9x4.9mm_P1.27 | SOIC-8 | 10213 | 12 | 0.9762 |  | EXTENDED HAND_SOLDER |
| `C465729` | U5-U7 | UCC27524DR | SOIC-8_3.9x4.9mm_P1.27 | SOIC-8 | 9550 | 6 | 0.4035 |  | EXTENDED HAND_SOLDER |
| `C48467` | F1 | 5A 125V | Fuse_2410_6125Metric | 2410 | 28138 | 2 | 0.2563 |  | EXTENDED HAND_SOLDER |
| `C492427` | J20 | LaunchPad J1+J3 | PinHeader_2x10_P2.54mm | 插件,P=2.54mm | 98935 | 2 | 0.1377 |  | EXTENDED HAND_SOLDER |
| `C492427` | J21 | LaunchPad J4+J2 | PinHeader_2x10_P2.54mm | 插件,P=2.54mm | 98935 | 2 | 0.1377 |  | EXTENDED HAND_SOLDER |
| `C492427` | J22 | LaunchPad J5+J7 | PinHeader_2x10_P2.54mm | 插件,P=2.54mm | 98935 | 2 | 0.1377 |  | EXTENDED HAND_SOLDER |
| `C492427` | J23 | LaunchPad J8+J6 | PinHeader_2x10_P2.54mm | 插件,P=2.54mm | 98935 | 2 | 0.1377 |  | EXTENDED HAND_SOLDER |
| `C5219272` | U2 | TPS62933FDRLR | SOT-583-8 | SOT-583 | 3486 | 2 | 1.0787 |  | EXTENDED |
| `C5369735` | U4 | URA2415YMD-6WR3 | Converter_DCDC_Mornsun | DIP,25.4x25.4mm | 304 | 2 | 6.3753 |  | EXTENDED HAND_SOLDER |
| `C723532` | R72,R73,R84,R85,R96,R97,R100,R | 4.99k 0.1% | R_0603_1608Metric | 0603 | 47194 | 16 | 0.0318 |  | EXTENDED |
| `C723637` | R63,R64,R75,R78,R87,R90 | 20.0k 0.1% | R_0603_1608Metric | 0603 | 121239 | 12 | 0.0316 |  | EXTENDED |
| `C7542932` | F3 | 0.2A 30V 1206L020 | Fuse_1206_3216Metric | 1206 | 141752 | 2 | 0.0393 |  | EXTENDED HAND_SOLDER |
| `C77033` | C62,C63,C69,C71,C76,C78,C105,C | 2.2nF C0G | C_0603_1608Metric | 0603 | 2265 | 20 | 0.0228 |  | EXTENDED |
| `C77069` | C59,C61,C68,C75,C82,C85,C86,C1 | 22nF C0G | C_0805_2012Metric | 0805 | 48685 | 22 | 0.0759 |  | EXTENDED |
| `C841384` | U1 | LMR33630ADDAR | Texas_HSOP-8-1EP_3.9x4 | ESOP-8 | 9908 | 2 | 0.6947 |  | EXTENDED PACKAGE_MISMATCH ESOP-8 |
| `C85980` | C66,C67,C73,C74,C80,C81 | 4.7nF C0G | C_0603_1608Metric | 0603 | 49830 | 12 | 0.0222 |  | EXTENDED |
| `C861295` | R58,R129 | 2.20k 0.1% | R_0603_1608Metric | 0603 | 78470 | 4 | 0.0329 |  | EXTENDED HAND_SOLDER |
| `C870760` | R68,R69,R80,R81,R92,R93 | 47.0R 0.1% | R_1206_3216Metric | 1206 | 4210 | 12 | 0.0809 |  | EXTENDED |
| `C88056` | L3 | ACT45B-101-2P-TL003 | L_CommonMode_TDK_ACT45 | SMD-4P,4.5x3.2mm | 38604 | 2 | 0.3396 |  | EXTENDED HAND_SOLDER |
| `C95204` | R108,R110,R113,R115,R131,R132 | 10.0k 0.1% | R_0603_1608Metric | 0603 | 389486 | 12 | 0.0241 |  | EXTENDED |
| `CONSIGNED` | J1 | Mini-Fit Jr 5566-02A | Molex_Mini-Fit_Jr_5566 |  |  | 2 |  |  | PLACEHOLDER |
| `CONSIGNED` | J2 | DSUB-37_Socket | DSUB-37_Socket_Horizon |  |  | 2 |  |  | PLACEHOLDER |
| `CONSIGNED` | J3 | LEM DT15-12PA key A | DEUTSCH_DT15-12P_Verti |  |  | 2 |  |  | PLACEHOLDER |
| `CONSIGNED` | J4 | ENC DT15-12PB key B | DEUTSCH_DT15-12P_Verti |  |  | 2 |  |  | PLACEHOLDER |
| `CONSIGNED` | J5 | VEH DT15-08PD key D | DEUTSCH_DT15-08P_Verti |  |  | 2 |  |  | PLACEHOLDER |
| `NOFIT` | JP1 | ILOCK_SEL | SolderJumper-3_P1.3mm_ |  |  | 2 |  |  | PLACEHOLDER |
| `NOFIT` | JP2 | SHLD_TIE | SolderJumper-2_P1.3mm_ |  |  | 2 |  |  | PLACEHOLDER |
| `NOFIT` | JP3 | SRC SEL A | SolderJumper-3_P1.3mm_ |  |  | 2 |  |  | PLACEHOLDER |
| `NOFIT` | JP4 | SRC SEL B | SolderJumper-3_P1.3mm_ |  |  | 2 |  |  | PLACEHOLDER |
| `NOFIT` | JP5 | SRC SEL C | SolderJumper-3_P1.3mm_ |  |  | 2 |  |  | PLACEHOLDER |
| `NOFIT` | JP6 | CAN TERM bridged=120R | SolderJumper-2_P1.3mm_ |  |  | 2 |  |  | PLACEHOLDER |
| `NOFIT` | NT1 | ISO_COM-GND | NetTie-2_SMD_Pad0.5mm |  |  | 2 |  |  | PLACEHOLDER |
| `NOFIT` | NT2 | PGND_MOD-GND star | NetTie-2_SMD_Pad0.5mm |  |  | 2 |  |  | PLACEHOLDER |
| `NOFIT` | NT3 | VBUS_RTN_TIE | NetTie-2_SMD_Pad0.5mm |  |  | 2 |  |  | PLACEHOLDER |
| `NOFIT` | NT4 | ISNS_RTN-GND | NetTie-2_SMD_Pad0.5mm |  |  | 2 |  |  | PLACEHOLDER |
| `NOFIT` | TP1 | +24V_PROT | TestPoint_Pad_D1.5mm |  |  | 2 |  |  | PLACEHOLDER |
| `NOFIT` | TP2 | +13V5_GATE | TestPoint_Pad_D1.5mm |  |  | 2 |  |  | PLACEHOLDER |
| `NOFIT` | TP3 | +5V | TestPoint_Pad_D1.5mm |  |  | 2 |  |  | PLACEHOLDER |
| `NOFIT` | TP4 | +3V3 | TestPoint_Pad_D1.5mm |  |  | 2 |  |  | PLACEHOLDER |
| `NOFIT` | TP5 | +24V_MOD | TestPoint_Pad_D1.5mm |  |  | 2 |  |  | PLACEHOLDER |
| `NOFIT` | TP6 | +15V_ISO | TestPoint_Pad_D1.5mm |  |  | 2 |  |  | PLACEHOLDER |
| `NOFIT` | TP7 | -15V_ISO | TestPoint_Pad_D1.5mm |  |  | 2 |  |  | PLACEHOLDER |
| `NOFIT` | TP8 | ISO_COM | TestPoint_Pad_D1.5mm |  |  | 2 |  |  | PLACEHOLDER |
| `NOFIT` | TP9 | GND | TestPoint_Pad_D1.5mm |  |  | 2 |  |  | PLACEHOLDER |
| `NOFIT` | TP10 | TP_PWM_UH | TestPoint_Pad_D1.5mm |  |  | 2 |  |  | PLACEHOLDER |
| `NOFIT` | TP11 | TP_PWM_UL | TestPoint_Pad_D1.5mm |  |  | 2 |  |  | PLACEHOLDER |
| `NOFIT` | TP12 | TP_PWM_VH | TestPoint_Pad_D1.5mm |  |  | 2 |  |  | PLACEHOLDER |
| `NOFIT` | TP13 | TP_PWM_VL | TestPoint_Pad_D1.5mm |  |  | 2 |  |  | PLACEHOLDER |
| `NOFIT` | TP14 | TP_PWM_WH | TestPoint_Pad_D1.5mm |  |  | 2 |  |  | PLACEHOLDER |
| `NOFIT` | TP15 | TP_PWM_WL | TestPoint_Pad_D1.5mm |  |  | 2 |  |  | PLACEHOLDER |
| `NOFIT` | TP16 | TP_GATE_EN | TestPoint_Pad_D1.5mm |  |  | 2 |  |  | PLACEHOLDER |
| `NOFIT` | TP17 | TP_MOD15V_1 | TestPoint_Pad_D1.5mm |  |  | 2 |  |  | PLACEHOLDER |
| `NOFIT` | TP18 | TP_MOD15V_2 | TestPoint_Pad_D1.5mm |  |  | 2 |  |  | PLACEHOLDER |
| `NOFIT` | TP19 | TP_VBUS_RAW | TestPoint_Pad_D1.5mm |  |  | 2 |  |  | PLACEHOLDER |
| `NOFIT` | TP21 | TP_VBUS_RTN | TestPoint_Pad_D1.5mm |  |  | 2 |  |  | PLACEHOLDER |
| `NOFIT` | TP22 | TP_NTC_RAW | TestPoint_Pad_D1.5mm |  |  | 2 |  |  | PLACEHOLDER |
| `NOFIT` | TP24 | TP_FLT_OC_A | TestPoint_Pad_D1.5mm |  |  | 2 |  |  | PLACEHOLDER |
| `NOFIT` | TP25 | TP_FLT_OC_B | TestPoint_Pad_D1.5mm |  |  | 2 |  |  | PLACEHOLDER |
| `NOFIT` | TP26 | TP_FLT_OC_C | TestPoint_Pad_D1.5mm |  |  | 2 |  |  | PLACEHOLDER |
| `NOFIT` | TP27 | TP_FLT_OT | TestPoint_Pad_D1.5mm |  |  | 2 |  |  | PLACEHOLDER |
| `NOFIT` | TP28 | TP_FLT_OV | TestPoint_Pad_D1.5mm |  |  | 2 |  |  | PLACEHOLDER |
| `NOFIT` | TP29 | TP_FLT_OC_A_15V | TestPoint_Pad_D1.5mm |  |  | 2 |  |  | PLACEHOLDER |
| `NOFIT` | TP30 | ISNS_A_INT | TestPoint_Pad_D1.5mm |  |  | 2 |  |  | PLACEHOLDER |
| `NOFIT` | TP31 | ISNS_A_LEM | TestPoint_Pad_D1.5mm |  |  | 2 |  |  | PLACEHOLDER |
| `NOFIT` | TP32 | ISNS_B_INT | TestPoint_Pad_D1.5mm |  |  | 2 |  |  | PLACEHOLDER |
| `NOFIT` | TP33 | ISNS_B_LEM | TestPoint_Pad_D1.5mm |  |  | 2 |  |  | PLACEHOLDER |
| `NOFIT` | TP34 | ISNS_C_INT | TestPoint_Pad_D1.5mm |  |  | 2 |  |  | PLACEHOLDER |
| `NOFIT` | TP35 | ISNS_C_LEM | TestPoint_Pad_D1.5mm |  |  | 2 |  |  | PLACEHOLDER |
| `NOFIT` | TP36 | ISNS_VREF | TestPoint_Pad_D1.5mm |  |  | 2 |  |  | PLACEHOLDER |
| `NOFIT` | TP38 | ENC_SIN_RAW | TestPoint_Pad_D1.5mm |  |  | 2 |  |  | PLACEHOLDER |
| `NOFIT` | TP39 | ENC_COS_RAW | TestPoint_Pad_D1.5mm |  |  | 2 |  |  | PLACEHOLDER |
| `NOFIT` | TP40 | ENC_SIN_ADC | TestPoint_Pad_D1.5mm |  |  | 2 |  |  | PLACEHOLDER |
| `NOFIT` | TP41 | ENC_COS_ADC | TestPoint_Pad_D1.5mm |  |  | 2 |  |  | PLACEHOLDER |
| `NOFIT` | TP44 | ENC_VDD | TestPoint_Pad_D1.5mm |  |  | 2 |  |  | PLACEHOLDER |
| `NOFIT` | TP45 | +5V_LP | TestPoint_Pad_D1.5mm |  |  | 2 |  |  | PLACEHOLDER |
| `NOFIT` | TP46,TP47 | GND | TestPoint_THTPad_D1.5m |  |  | 4 |  |  | PLACEHOLDER |
| `NOFIT` | TP48 | ISR_PROBE_3V3 | TestPoint_Pad_D1.5mm |  |  | 2 |  |  | PLACEHOLDER |
| `NOFIT` | TP49 | CAN_H | TestPoint_Pad_D1.5mm |  |  | 2 |  |  | PLACEHOLDER |
| `NOFIT` | TP50 | CAN_L | TestPoint_Pad_D1.5mm |  |  | 2 |  |  | PLACEHOLDER |
| `NOFIT` | TP51 | SW_MAIN_3V3 | TestPoint_Pad_D1.5mm |  |  | 2 |  |  | PLACEHOLDER |
| `NOFIT` | TP52 | SW_START_3V3 | TestPoint_Pad_D1.5mm |  |  | 2 |  |  | PLACEHOLDER |
| `NOFIT` | TP53 | MOT_TEMP_RAW | TestPoint_Pad_D1.5mm |  |  | 2 |  |  | PLACEHOLDER |
| `C1017` | FB1 | 600R@100MHz | L_0805_2012Metric | 0805 | 369732 | 2 | 0.0326 | B |  |
| `C109227` | U19,U20 | LTV-817S-TA1-C | Optocoupler_LTV-817S_S | SMD-4P | 597938 | 4 | 0.0749 | B |  |
| `C12084` | U18 | SN65HVD230DR | SOIC-8_3.9x4.9mm_P1.27 | SOIC-8 | 91835 | 2 | 0.6898 | P |  |
| `C13585` | C2,C3,C5,C9,C10,C14,C23,C36,C9 | 10uF 50V | C_1206_3216Metric | 1206 | 1877266 | 20 | 0.1757 | B |  |
| `C14663` | C4,C8,C11,C12,C15,C19,C22,C24, | 100nF 50V | C_0603_1608Metric | 0603 | 12618106 | 62 | 0.0106 | B |  |
| `C15849` | C6 | 1uF 50V | C_0603_1608Metric | 0603 | 5979916 | 2 | 0.0297 | B |  |
| `C15850` | C16-C18,C20,C21,C25,C27,C97,C1 | 10uF 25V | C_0805_2012Metric | 0805 | 3505306 | 18 | 0.0773 | B |  |
| `C1622` | C13 | 47nF 50V | C_0603_1608Metric | 0603 | 414711 | 2 | 0.0087 | B |  |
| `C19077472` | D2 | BZX84C15 | SOT-23 | SOT-23 | 11303 | 2 | 0.0193 | P |  |
| `C19077605` | D1 | SMCJ26CA | D_SMC | SMC(DO-214AB) | 67883 | 2 | 0.1244 | P |  |
| `C21189` | R12,R103,R119 | 0R | R_0603_1608Metric | 0603 | 6153233 | 6 | 0.0019 | B |  |
| `C21190` | R33 | 1k | R_0603_1608Metric | 0603 | 8013731 | 2 | 0.0039 | B |  |
| `C22775` | R18-R23,R74,R86,R98,R101,R102, | 100R | R_0603_1608Metric | 0603 | 7325193 | 26 | 0.0023 | B |  |
| `C22787` | R122 | 120R | R_0603_1608Metric | 0603 | 1475830 | 2 | 0.0016 | B |  |
| `C22790` | R6,R60 | 12k | R_0603_1608Metric | 0603 | 442690 | 4 | 0.0035 | B |  |
| `C22797` | R11 | 13k | R_0603_1608Metric | 0603 | 388035 | 2 | 0.0014 | B |  |
| `C22807` | R5 | 150k | R_0603_1608Metric | 0603 | 414154 | 2 | 0.0014 | B |  |
| `C22843` | R15 | 1.5k | R_0603_1608Metric | 0603 | 1163865 | 2 | 0.0012 | B |  |
| `C2286` | D4 | red +24V_PROT | LED_0603_1608Metric | 0603 | 8154450 | 2 | 0.0073 | B |  |
| `C2286` | D5 | red +13V5_GATE | LED_0603_1608Metric | 0603 | 8154450 | 2 | 0.0073 | B |  |
| `C2286` | D6 | red +5V | LED_0603_1608Metric | 0603 | 8154450 | 2 | 0.0073 | B |  |
| `C2286` | D7 | red +3V3 | LED_0603_1608Metric | 0603 | 8154450 | 2 | 0.0073 | B |  |
| `C2286` | D8 | red +15V_ISO | LED_0603_1608Metric | 0603 | 8154450 | 2 | 0.0073 | B |  |
| `C2286` | D9 | RED GATE_EN | LED_0603_1608Metric | 0603 | 8154450 | 2 | 0.0073 | B |  |
| `C22935` | R35,R67,R77,R89,R104,R118 | 1M | R_0603_1608Metric | 0603 | 2601258 | 12 | 0.0019 | B |  |
| `C22978` | R59,R62,R130 | 3.3k | R_0603_1608Metric | 0603 | 1199741 | 6 | 0.0019 | B |  |
| `C23162` | R14,R30-R32,R36-R46,R52-R56,R6 | 4.7k | R_0603_1608Metric | 0603 | 7433362 | 42 | 0.0015 | B |  |
| `C23212` | R17 | 6.8k | R_0603_1608Metric | 0603 | 368873 | 2 | 0.0018 | B |  |
| `C23228` | R16,R34 | 680R | R_0603_1608Metric | 0603 | 923432 | 4 | 0.0013 | B |  |
| `C23231` | R10 | 68k | R_0603_1608Metric | 0603 | 428152 | 2 | 0.0013 | B |  |
| `C25803` | R1,R2,R8 | 100k | R_0603_1608Metric | 0603 | 7990119 | 6 | 0.0016 | B |  |
| `C25804` | R3,R13,R24-R29,R47-R51,R120,R1 | 10k | R_0603_1608Metric | 0603 | 37165617 | 30 | 0.000842857 | B |  |
| `C28323` | C29,C31,C33,C57,C83,C91,C101,C | 1uF 50V | C_0805_2012Metric | 0805 | 2084641 | 22 | 0.0469 | B |  |
| `C32677` | D13 | PSM712 | SOT-23 | SOT-23 | 317834 | 2 | 0.3233 | B |  |
| `C4190` | R123-R128 | 2.2k | R_0603_1608Metric | 0603 | 2001135 | 12 | 0.0014 | B |  |
| `C4216` | R9 | 33k | R_0603_1608Metric | 0603 | 696981 | 2 | 0.0013 | B |  |
| `C6186` | U3 | AMS1117-3.3 | SOT-223-3_TabPin2 | SOT-223 | 2007447 | 2 | 0.2003 | B |  |
| `C7420333` | D10,D11,D18 | BAT54S | SOT-23 | SOT-23 | 314690 | 6 | 0.0126 | P |  |
| `C81598` | D14,D15 | 1N4148W | D_SOD-123 | SOD-123 | 3538406 | 4 | 0.0113 | B |  |
| `C8678` | D12,D16 | SS34 | D_SMA | SMA(DO-214AC) | 3557042 | 4 | 0.0303 | B |  |
