josearistidesbail/FE_UFPR_4_0/(commit log)

2026-08-19 S1: project foundation, libraries, standards
    Fresh 4-layer KiCad project replacing the un-editable 2-layer Eagle import
    in ../FE_UFPR_3_0 (reference-only from here on).
    Hierarchy
    - A3 root + 7 A3 sub-sheets: power, gate_drive, module_status,
    current_sense, encoder, launchpad, vehicle_io. All title-blocked.
    - ERC on the empty hierarchy: 0 errors / 0 warnings.
    Libraries (the fix for 3.0, whose lib tables point at files that do not exist)
    - ONE project symbol lib (28 symbols) + ONE footprint lib (19 footprints),
    registered project-scope with ${KIPRJMOD}-relative URIs.
    - Standard KiCad parts are re-exported, never referenced; no embedded-cache
    reliance. Both libs validated by a full kica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
    [FE_UFPR_4_0.kicad_pcb, FE_UFPR_4_0.kicad_sch, current_sense.kicad_sch, encoder.kicad_sch, gate_drive.kicad_sch, launchpad.kicad_sch, module_status.kicad_sch, power.kicad_sch]
2026-08-19 S1: normalize lib-table formatting to KiCad canonical style
    Verified end-to-end that the project sym-lib-table actually resolves:
    placed FE_UFPR_4_0:R in a scratch copy -> ERC reported only the expected
    floating-pin errors, no lib_symbol_issues. Control test (renaming the
    .kicad_sym away) made ERC emit
    [lib_symbol_issues]: The symbol library 'FE_UFPR_4_0' was not found at
    <expanded KIPRJMOD path>
    confirming the check is live and ${KIPRJMOD} expands correctly.
    Claude-Session: https://claude.ai/code/session_01XnLMHmQkeLvggX3aUVyqZ3
2026-08-25 S2: system architecture — power tree, grounding, floorplan, root interface
    Deliverable: ARCHITECTURE.md (power tree + 3A/49W budget incl. 40W aux
    pass-through, LaunchPad power policy JP1/2/3-out JP4/5-in via SPRUI77,
    grounding/star/Kelvin + shield tie policy, floorplan inheriting 3.0's
    proven DB37/LaunchPad arrangement, adapter-plate mounting plan).
    Root sheet: 40 interface nets / 80 sheet pins with stubs + net labels;
    matching hierarchical labels pre-declared in all six sub-sheets. Sheet
    boxes re-gridded from integer mm to 1.27mm multiples (kills 80 off-grid
    warnings). ERC: only the expected 160 label_dangling from the still-empty
    hierarchy; zero warnings.
    Windfalls: SPRUI77 fetched int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
    [FE_UFPR_4_0.kicad_sch, current_sense.kicad_sch, encoder.kicad_sch, gate_drive.kicad_sch, launchpad.kicad_sch, module_status.kicad_sch, vehicle_io.kicad_sch]
2026-08-29 S3: power supplies — entry protection, 13.5V/5V/3V3 rails, isolated ±15V
    power sheet captured: 79 components, 30 nets, ERC 0 violations on the sheet,
    netlist verified node-by-node, 64 LCSC fields set, zero placeholder values.
    Both converters named in the roadmap were rejected. LMR33630 and TPS62153 each
    have no MODE pin, so neither can be forced out of light-load PFM — and on a board
    that samples every analog channel at 10 kHz, a load-dependent burst rate is exactly
    the wrong failure mode. Replacements:
    +13V5_GATE TPS54360B 60 V (survives the 53.3 V SMBJ33A clamp; a 36 V part does
    not), 500 kHz, 47 uH sized to hold CCM down to 0.13 A, external
    compensat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
    [power.kicad_sch]
2026-08-29 S3 fix: revert gate-rail buck to LMR33630; input range 18-26 V; TVS -> SMCJ26A
    The 60 V TPS54360B swap was wrong and is reverted. It rested on the S2 assumption
    "+24V_IN (vehicle LV, 18-30 V)" from ARCHITECTURE.md §1, which I inherited and never
    confirmed. The actual LV rail max is <=26 V, which makes a 36 V part correct.
    Reverting is also a net simplification: the LMR33630 is synchronous (no catch diode),
    internally compensated (no R/C/C network) and fixed 400 kHz (no RT resistor) — five
    fewer parts and better efficiency.
    FB divider recomputed for Vref = 1.000 V (not 0.8 V): 150k/12k -> exactly 13.500 V,
    both JLC Basic, >400k stock each
    UVLO now via the EN divider 100k/10k (bot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
    [power.kicad_sch]
2026-08-29 S4: gate drive — 3x UCC27524 single stage, hardware enable, DB37 frozen
    Replaces 3.0's three-stage chain ('1G126 x6 -> CD4504B -> AND gate powered
    from GPIO131) with one stage: 3x UCC27524 dual 5A drivers whose input and
    enable thresholds are fixed and independent of VDD, so 3.3V logic switches a
    13.5V output stage directly.
    The PrimeSTACK datasheet (user-supplied mid-session, now in datasheets/) is
    the authoritative source for the DB37 and overturned five inherited beliefs:
    - fault is HIGH, not LOW -> hw_control_v2.h MODULE_FAULT_ACTIVE_LOW is
    inverted; also makes a disconnected DB37 read as FAULT (fail-safe)
    - analog outputs drive 5 mA -> S5 needs no Vbus buffer op-amp
    - one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
    [FE_UFPR_4_0.kicad_sch, gate_drive.kicad_sch, launchpad.kicad_sch, module_status.kicad_sch, power.kicad_sch]
2026-08-29 S4 doc fix: 3.0's DB37 wiring was 34/37 correct, not 29/37
    Correcting an overstatement in the S4 write-up. Only pins 1, 9 and 27
    differ from 3.0, and none carries traffic - every functional pin (gates
    incl. TOP/BOT, faults, currents, Vbus, temperature, 24V, grounds) was
    right in 3.0 and is carried over unchanged.
    Honest severity: pin 27 (supply output tied to GND) is the one real
    mistake and it is symptomless; pin 9 is a dead circuit firmware never
    sampled; pin 1 (chassis bond) is a defensible choice that merely
    conflicts with the soft-tie policy S2 adopted for v4.0. The phantom
    NTC#2 was OUR S2 error in ARCHITECTURE.md, not 3.0's.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
2026-08-29 S4 doc: "PTC" on DB37 pins 9/27 is the output fuse, not a sensor
    Rendering p.6 at 600 dpi shows the "Out" sub-block containing a legend box
    with the IEC fuse symbol labelled PTC - same style and position as the "In"
    sub-block's legend box holding two solid fuse symbols for the 13-30 V feed
    on pins 8/26. So it is a PTC resettable fuse limiting that output.
    Pins 9 and 27 are therefore two pins of ONE 15 V / 50 mA auxiliary rail, the
    same way 8/26, 10/28, 19/25/37 and 11/12/13 are duplicated. There is no PTC
    sensor interface on this connector; the only temperature output is pin 29.
    Also explains why 3.0 grounding pin 27 was symptomless with a concrete
    mechanism: the module's own PTC fuse trip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
2026-08-29 S5: module status - fault receivers, Vbus sense, NTC; netclass patterns fixed
    module_status captured: 54 components, 22 signal nets, netlist verified
    node-by-node against a hand-written expected-membership table (22/22 exact).
    Fault receivers (5x, DB37 pins 2/22/5/6/16)
    4.7k pull-up to +13V5_GATE, 1nF, 10k/4.7k divider, 1nF, SN74LVC2G17 Schmitt.
    Levels at the DB37 pin 0.15 V / 10.23 V; trip window 2.60-7.32 V referred
    there => 2.45 V / 2.91 V noise margin. A 5 V pull-up needing no divider was
    rejected: 0.5 V of low-side margin cannot absorb module-GND shift across the
    harness. Response 5.7 us typ / 8.9 us worst case, against the module's own
    15 us OC shutdown and a 100 us PWM pe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
    [module_status.kicad_sch]
2026-08-30 S6: current sense - 3 channels, dual-source, burden on-board
    current_sense captured: 94 components, 42 nets, netlist verified
    node-by-node (42/42 exact, 0 mismatches). Root ERC 89 -> 70, and
    still only the two documented cosmetic classes.
    Topology: two independent difference amps per channel (module
    internal + LEM), both live at all times, one 3-pad jumper selecting
    which OUTPUT reaches the ADC. Each stage rejects its own source
    return (ISNS_RTN / ISO_COM Kelvin). The roadmap's "one shared
    transfer function" is dropped with rationale: matching the slopes
    exactly needs a 16 ohm burden, below the LA 100-P's 20 ohm R_M
    floor at 85 C.
    Values: internal 20.0k/12.0k -> G=0.600 -> ADC bias exactly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
    [current_sense.kicad_sch]
2026-08-30 chore: KiCad 10.0.5 re-save (schematic format 20260101 -> 20260306)
    Opening the project in the newer KiCad build rewrote every sheet: quoted
    UUIDs, tab indentation, reordered elements, and "sch_revision": "4.0" in
    the project file. No electrical change - component counts are identical
    per sheet (power 76, gate_drive 56, module_status 60, current_sense 94)
    and the exported netlist is unchanged at 125 nets / 634 nodes
    (52 Default / 43 Analog / 17 Gate / 8 Power_1A / 5 Power_3A).
    Committed on its own so the S7 diff is not buried under 27k lines of
    reformatting.
    Claude-Session: https://claude.ai/code/session_013Zjo8zogE5kK1wqhJn4Wf4
    [FE_UFPR_4_0.kicad_sch, current_sense.kicad_sch, encoder.kicad_sch, gate_drive.kicad_sch, launchpad.kicad_sch, module_status.kicad_sch, power.kicad_sch, vehicle_io.kicad_sch]
2026-08-30 S7: encoder front-end (RM44AC) + Deutsch connectors on both vehicle harnesses
    encoder sheet: 46 components, 16 nets, netlist verified node-by-node
    (16/16 exact). Root ERC 66 = 62 label_dangling + 4 isolated_pin_label,
    down from S6's 70, no other violation class. LCSC on 45/45.
    Source resolved from the RM44AC datasheet (fetched, in datasheets/):
    single-ended VA/VB, 2.2 +/-0.2 Vpp on a 3/5*Vdd offset, 720 ohm internal
    series impedance, 5 V / 13 mA, order code 01S = 1 cycle/mech rev. The
    roadmap's preferred differential/INA receive is not available, and the
    4-core factory cable makes a Kelvin ground return physically impossible.
    Bench items #7-#9 now only confirm.
    Front end: one non-inverting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
    [current_sense.kicad_sch, encoder.kicad_sch]
2026-08-31 Better organized schematic
    [current_sense.kicad_sch, encoder.kicad_sch, gate_drive.kicad_sch, module_status.kicad_sch, power.kicad_sch]
2026-09-02 S8: launchpad sheet - four BoosterPack sockets, 5 V feed, pin map verified
    Captures the `launchpad` sheet: J20-J23 (TI J1+J3 / J4+J2 / J5+J7 / J8+J6 -
    the two J-columns of one SPRUI77 table are the two rows of one physical
    socket, verified against the 3.0 board's as-built pad map), 33 header pins
    wired to their consumers, 47 explicit no-connects, the SS34 5 V feed
    deferred from S3, and four test points. CAN-A chosen on GPIO4/GPIO5
    (J4-36/35); CAN-B is unroutable because every header CANRXB is a PWM pin.
    Whole firmware pin map cross-checked against SPRUI77 Tables 1-4 by parsing
    the PDF: 23 of 26 signals land on a header pin, the other three are the
    documented off-header ones. golden.net re-b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
    [launchpad.kicad_sch]
2026-09-02 S8: vehicle_io sheet, schematic freeze - CAN, isolated cockpit inputs, ECU 5 V feed
    vehicle_io: J5 DEUTSCH DTM13-08PA-R004 (8-way, key A - way-count keyed against
    the two 12-way keys already used), SN65HVD230 CAN-A front-end with ACT45B
    common-mode choke, PSM712 TVS and a bridged-jumper 120 R termination, two
    identical optically isolated inputs (LTV-817S high-side, 2.2k pull-down,
    SN74LVC2G17 Schmitt - every failure reads LOW), and the provisional +5V_VEH
    feed (SS34 back-feed block + 0.2 A polyfuse + SMAJ5.0A). 30 parts, 6 new
    symbols, 5 new footprints (DTM13-08PA derived from TE's drawing: it is a
    vertical-flange right-angle part with 6.35 mm row spacing, not the flat-base
    4.19 mm grid S7's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
    [current_sense.kicad_sch, encoder.kicad_sch, gate_drive.kicad_sch, launchpad.kicad_sch, module_status.kicad_sch, power.kicad_sch, vehicle_io.kicad_sch]
2026-09-02 chore: stop tracking tools/schematic_layout/__pycache__ (now ignored)
    Claude-Session: https://claude.ai/code/session_01BbqAgraN6LAYLruGRERKDp
2026-09-02 S9: board setup, JLC 4-layer stackup, rules, full placement (DRC 0 errors)
    - FE_UFPR_4_0.kicad_pcb: 4 copper layers with the JLC04161H-7628 stackup encoded,
    146 x 130 mm outline, 360 schematic footprints + 9 M3 holes (6 board, 3 LaunchPad
    standoffs) placed by tools/board_layout/place_s9.py; sockets J20-J23 on B.Cu,
    handedness derived from SPRUI77 Fig. 12 and verified from the placed pad coordinates.
    - Rules from JLCPCB's 4-layer capabilities; netclass values kept and IPC-2221 rated;
    *PWM_*_3V3 -> Gate; new CAN class; one .kicad_dru rule for U2's fine-pitch pads.
    - J5 courtyard: two overlapping rects were self-intersecting (skipped by the overlap
    check) -> one polygon, library and b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
    [FE_UFPR_4_0.kicad_pcb]
2026-09-02 chore: KiCad GUI re-save + FSAE 2026 rulebook
    Cosmetic re-serialisation from a KiCad session, no connectivity change:
    lib_symbols reordered in every sheet, the CAN netclass moved position in
    .kicad_pro, four board text UUIDs regenerated, J5's courtyard polygon
    reflowed onto fewer lines. Title-block comment 3 shortened to
    "See REDESIGN_PLAN.md in project dir" on all eight sheets.
    Gate: kicad-cli sch export netlist vs tools/schematic_layout/golden.net
    -> 220 nets, 914 nodes, IDENTICAL.
    Also adds datasheets/FSAE_Rules_2026_V1.pdf (user-supplied) - the EV
    section is what governs the TS/GLV boundary for the motor PTC channel.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
    [FE_UFPR_4_0.kicad_pcb, FE_UFPR_4_0.kicad_sch, current_sense.kicad_sch, encoder.kicad_sch, gate_drive.kicad_sch, launchpad.kicad_sch, module_status.kicad_sch, power.kicad_sch]
2026-09-02 S9.5: motor temperature channel (EMRAX KTY81-210) on J4 cavities 6/7
    The board had no motor-temperature channel at all, and the EMRAX manual
    makes one mandatory: the sensor "must be connected to the controller",
    120 C on the copper windings voids the warranty, and on sensor
    disconnection "the controller has to stop the motor". Captured now
    because the board is placed but not yet routed.
    Circuit: KTY81-210 as the divider's BOTTOM leg, excited from +3V3 through
    R129 2.20k 0.1%. Open -> 3.30 V, short -> 0 V, both outside the valid
    1.12-2.18 V band, so disconnect detection is free. +3V3 rather than +5V
    so an open sensor cannot exceed the ADC's VDDA+0.3 absolute maximum.
    6.25 codes/K at the 120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
    [FE_UFPR_4_0.kicad_pcb, FE_UFPR_4_0.kicad_sch, encoder.kicad_sch, launchpad.kicad_sch]
2026-09-02 docs: correct the ECU CAN interface note - reference vs supply
    S8's decision log said an ISOW1044-class isolated transceiver "needs
    nothing from us". Wrong: an isolated DC/DC makes a floating rail, fixing
    VCC2-GND2 at 5 V without saying where GND2 sits. Our SN65HVD230 has a bus
    common-mode window of only -2 V to +7 V and our board floats, so with no
    ground wire the common mode drifts on leakage until the link dies.
    J5 cavity 7 (GND) is therefore populated in every case; only cavity 2
    (+5V_VEH) and the 75 mA depend on Q3. And cavity 7 is safe only because
    their bus side is isolated - if it is not, connecting it bonds our
    floating island to car ground, exactly like fitting JP2.
    Spotted by th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
2026-09-14 S9.6: vertical mount on X1 via DB37 90° adapter, LaunchPad on top, re-placement (DRC 0 errors)
    - Board stands vertical above the PrimeSTACK, DB37 edge down, direct on X1 through an
    L-com DG9037MF right-angle adapter (passive adapter PCB as fallback); the right-angle
    DB37 socket is unchanged so the cable still fits for prototyping.
    - All connectors top side: J20-J23 become PinHeader_2x10 on F.Cu (LaunchPad sits above on
    its own receptacles, as on 3.0 - S2's "male pins on top only" premise was wrong). Pad map
    re-verified from KiCad's IPC-D-356 export: 80/80 header pads match golden.net.
    - Floorplan re-run: J5 to the top-left clear of the LaunchPad overhang, J4/J3/U4 shifted,
    power c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
    [FE_UFPR_4_0.kicad_pcb, launchpad.kicad_sch]
2026-09-15 Placing power segment components
    [FE_UFPR_4_0.kicad_pcb]
2026-09-16 pwm placement
    [FE_UFPR_4_0.kicad_pcb]
2026-09-17 POwer interface fixes
    [FE_UFPR_4_0.kicad_pcb, vehicle_io.kicad_sch]
2026-09-17 COntinuing placing
    [FE_UFPR_4_0.kicad_pcb]
2026-09-17 Placing op amps part 1
    [FE_UFPR_4_0.kicad_pcb]
2026-09-17 Placing rest blocks
    [Converter_DCDC_Mornsun_URA-YMD-6WR3_THT.step, DEUTSCH_DTM13-08PA-R004_Horizontal.step, DEUTSCH_DTM13-12P-R005_Horizontal.step, FE_UFPR_4_0.kicad_pcb, Fuse_2410_6125Metric.step, L_CommonMode_TDK_ACT45B.step, LaunchPad_LAUNCHXL-F28379D_Shadow.step, power.kicad_sch]
2026-09-18 Finished placing tps
    [FE_UFPR_4_0.kicad_pcb, encoder.kicad_sch, module_status.kicad_sch]
2026-09-18 FIxing errors
    [FE_UFPR_4_0.kicad_pcb, current_sense.kicad_sch]
2026-09-18 Commiting jlc rules
    [FE_UFPR_4_0.kicad_pcb]
2026-09-18 More routing
    [FE_UFPR_4_0.kicad_pcb, gate_drive.kicad_sch, power.kicad_sch]
2026-09-19 CONTINUING ROUTING
    [FE_UFPR_4_0.kicad_pcb]
2026-09-19 Remade driver connections
    [FE_UFPR_4_0.kicad_pcb]
2026-09-23 Power planes
    [FE_UFPR_4_0.kicad_pcb]
2026-09-23 ROuting power planes
    [FE_UFPR_4_0.kicad_pcb, power.kicad_sch]
2026-09-23 Progressing with final routings
    [FE_UFPR_4_0.kicad_pcb]
2026-09-23 Routing finished
    [FE_UFPR_4_0.kicad_pcb, encoder.kicad_sch, launchpad.kicad_sch]
2026-09-23 Repair project state: restore symbol library, disable KiCad Local History, untrack restore backups
    - FE_UFPR_4_0.kicad_sym restored from _restore_backup_2026-09-22T22-07-53-839/ (KiCad Local History
    had rolled it back to the S7 snapshot twice): 60 units render, ERC 0 lib_symbol_issues, netlist
    IDENTICAL to golden.net.
    - Root cause documented (TOOLING_NOTES, DECISION_LOG, OPEN_ITEMS): corrupt .history/ repo restored
    by KiCad 10 Local History, plus the MCP backend's stale .kicad_pro model on board saves.
    - Local History disabled in kicad_common.json; .history renamed .history_corrupt_2026-09-23;
    /.history*/ and _restore_backup*/ ignored; both backup folders untracked (kept on disk).
    C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
2026-09-23 fixing drc warnings
    [FE_UFPR_4_0.kicad_pcb]
2026-09-23 Logos on silk
    [FE_UFPR_4_0.kicad_pcb]
2026-09-23 Silk fixes
    [FE_UFPR_4_0.kicad_pcb, power.kicad_sch]
2026-09-23 Finishing tp naming
    [FE_UFPR_4_0.kicad_pcb]
2026-09-23 S12: fab package (fab/), C22936->C22935 fix, firmware handoff, CPL audit seed
    - fix six 1 MOhm positions that carried C22936 (1 Ohm): R35 R67 R77 R89 R104 R118 -> C22935 in the sheets and on the board footprints (LCSC field only; ERC 0, DRC parity 0, netlist = golden.net)
    - fab/: gerbers (11 layers + Excellon PTH/NPTH), JLC BOM (70 lines) + CPL (289 parts, board-corner origin, rotations 0-360), jlc_verify record, README with order options
    - tools/fab: make_package.sh (rebuilds fab/), jlc_bomcpl.py (--origin, --hand-solder, prefix rotation table), jlc_verify.py (VALUE_MISMATCH check), jlc_rotations.json (community seed, unverified), fix_c22936.sh
    - S12_FAB_PACKAGE.md (decisions D1-D6, CPL aud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
    [FE_UFPR_4_0-B_Cu.gbr, FE_UFPR_4_0-B_Mask.gbr, FE_UFPR_4_0-B_Paste.gbr, FE_UFPR_4_0-B_Silkscreen.gbr, FE_UFPR_4_0-Edge_Cuts.gbr, FE_UFPR_4_0-F_Cu.gbr, FE_UFPR_4_0-F_Mask.gbr, FE_UFPR_4_0-F_Paste.gbr]
2026-09-24 S12 order: JLC matching checked, hand-solder BOM, BOM grouped by footprint+LCSC
    - fab/jlc_order_2026-09-24.xlsx: JLC BOM-matching export, checked 1:1 against fab/FE_UFPR_4_0_BOM.csv (70 lines / 289 designators, no substitutions, 64 selected, $92.68 parts)
    - user deselected J20-J23, U4 URA2415YMD-6WR3, U12-U17 OPA2376 for cost -> hand-soldered (reverses D1); HAND list in make_package.sh
    - fab/FE_UFPR_4_0_HANDSOLDER_BOM.csv: shopping list (LCSC code, per-board / run / suggested qty with spares) for the bottom-side parts, the deselected lines and the 5 consigned connectors
    - jlc_bomcpl.py: group by footprint+LCSC (D4-D9 one line instead of six 'Unconfirmed' lines), --boards, hand-solder BOM out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
    [FE_UFPR_4_0_BOM.csv, FE_UFPR_4_0_HANDSOLDER_BOM.csv, jlc_order_2026-09-24.xlsx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]
2026-09-24 S12 order: hand-solder BOM for 2 assembled boards, order qty for 3
    Claude-Session: https://claude.ai/code/session_01RJcYQJpnw6FjWqUDikqjUU
    [FE_UFPR_4_0_HANDSOLDER_BOM.csv]
2026-09-24 S12.5: J3/J4/J5 swapped to vertical DEUTSCH DT15 headers (TE sample-program constraint)
    - DT15-12PA (J3, key A), DT15-12PB (J4, key B), DT15-08PD (J5, key D); symbols/netlist unchanged
    - new footprints DEUTSCH_DT15-12P_Vertical / DEUTSCH_DT15-08P_Vertical + STEP bodies (gen_3d_dt15.py),
    hand-derived from TE drawings C-DT15-12PX rev D2 / C-DT15-08PX-XXXX rev A (datasheets/)
    - board: footprint blocks swapped on a scratch copy and spliced; NOT re-placed/re-routed yet (DRC 653 at old positions)
    - golden.net re-baselined (S12's C22935 fix), J5 MPN/Manufacturer added, sheet notes rewritten
    - docs: CLAUDE.md phase, DECISION_LOG, OPEN_ITEMS, LIBRARY, JLC_PARTS, VERIFIED_FACTS, TOOLING_NOTES, S9_6,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
    [DEUTSCH_DT15-08P_Vertical.step, DEUTSCH_DT15-12P_Vertical.step, FE_UFPR_4_0.kicad_pcb, current_sense.kicad_sch, encoder.kicad_sch, export-CAT-D487-H342.xlsx, vehicle_io.kicad_sch]
2026-09-24 S12.6: board re-placed and re-routed for the vertical DT15 headers (178 x 130 mm)
    - outline extended 32 mm to the left (x 96.0), GND plane + ISO_COM island extended
    - J5 top-left, J4 next to the encoder front-end, J3 beside U4; satellites under their connector on B.Cu;
    H1 -> (101,95), H3 -> (136.6,214.9); 12 B.Cu rule areas under the #4-20 screw heads
    - old tracks of the 19 affected nets stripped (DRC dangling loop), eastern parts of the old routes restored,
    ~60 new segments (CAN pair F.Cu, switch nets + 5V_VEH on B.Cu lanes, LEM/ENC on F.Cu, +/-15 V, SHIELD_LEM)
    - DRC: 0 errors, 0 unconnected, parity 0, 5 by-design silk warnings; netlist unchanged (= golden.net)
    - DT15 footprints: silk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
    [FE_UFPR_4_0.kicad_pcb]
2026-09-24 S12.6: trace-length review of the 178 mm board recorded (no board change)
    Per-net copper length S12 vs S12.6 measured with the new
    tools/board_layout/dt15_place/7_net_lengths.py; CAN, switch, LEM,
    encoder and shield deltas assessed and judged harmless in DECISION_LOG.md.
    Claude-Session: https://claude.ai/code/session_016bTqcV6BPFo6rebmeiuSsr
2026-09-24 S12.6: fab package rebuilt for the 178 x 130 mm board (DT15 headers)
    make_package.sh with KiCad closed: 16 gerber/drill files, CPL 278 parts
    on the new bottom-left origin (96.0, 219.9), hand-solder BOM lists the
    DT15 headers, JLC stock report re-run (unchanged apart from the DT15
    lines). fab/README, OPEN_ITEMS and the CLAUDE.md phase paragraph no
    longer call the package stale; JLC placement preview + tag remain.
    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
    [FE_UFPR_4_0-B_Cu.gbr, FE_UFPR_4_0-B_Mask.gbr, FE_UFPR_4_0-B_Paste.gbr, FE_UFPR_4_0-B_Silkscreen.gbr, FE_UFPR_4_0-Edge_Cuts.gbr, FE_UFPR_4_0-F_Cu.gbr, FE_UFPR_4_0-F_Mask.gbr, FE_UFPR_4_0-F_Paste.gbr]
2026-09-24 S12.6: logo and silk text moved by the user; gates re-run, fab rebuilt
    Board: logo block (copper + silk) and author text repositioned, four
    texts rotated 90 -> 0, zones refilled. DRC --severity-all
    --schematic-parity: 0 errors / 0 unconnected / 0 parity, 6 warnings
    (the 5 by-design silk ones + text_height on the 0.7 mm author line).
    Netlist identical to golden.net apart from the export date. Both sides
    rendered and inspected. make_package.sh: F.Cu, F.Mask, F/B.Silkscreen
    gerbers updated; BOM/CPL unchanged.
    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
    [FE_UFPR_4_0.kicad_pcb, FE_UFPR_4_0_HANDSOLDER_BOM.csv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]
2026-09-24 S12.6: front author silk text 0.7 -> 1.0 mm (board minimum), centred under the title
    The user's 0.7 mm line tripped the project's 1.0 mm min_text_height
    rule (JLC's own floor is 0.8). Now 1.0 mm like the bottom copy and
    shifted 2.2 mm left (x 138.4) so its 16.9 mm sits centred under the
    18.9 mm title. DRC --severity-all --schematic-parity: 0 / 0 / 0, the
    5 by-design silk warnings only; netlist = golden.net; rendered.
    make_package.sh re-run: only F.Silkscreen changed.
    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
    [FE_UFPR_4_0.kicad_pcb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]
2026-09-26 S12.6: JLC feeder fee cut 27 -> 14 Extended codes ($82.89 -> $42.98)
    Live re-audit of every Extended line against JLCSearch (2026-09-26); the
    2026-09-17 "nothing cuttable" conclusion is partially superseded.
    - R10/R11 52.3k/10k -> 68k/13k (both Basic), +5V 4.984 -> 4.985 V
    - D1 SMCJ26A -> SMCJ26CA (Preferred, same SMC footprint and grade;
    bidirectional is harmless after Q1), symbol D_TVS, UUID kept
    - Vbus R57/R58 2.20k/1.50k -> 3.00k/2.20k (existing RT0603B 0.1% lines):
    VBUS_DIVIDER_RATIO 341.538 -> 327.273, full scale 981.8 V (handoff doc)
    - Hand-solder C1, F1-F3, L3, U8, R57/R105, R58/R129, Q1, U5-U7 (HAND=)
    - jlc_verify.py --hand-solder: fee counted over codes JLC places
    - golden.net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
    [FE_UFPR_4_0.kicad_pcb, FE_UFPR_4_0_BOM.csv, FE_UFPR_4_0_HANDSOLDER_BOM.csv, kicad_bom.csv, module_status.kicad_sch, power.kicad_sch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]
2026-11-03 S12.6 bring-up A: three board defects logged, hand-assembly tracker added
    Bring-up of the first assembled board (2026-11-02/03) found:
    - D12 (SS34, +5V -> +5V_LP) drawn backwards since S8: blocks board ->
    LaunchPad and back-feeds the board from USB. Rework: rotate 180 deg.
    - The board never supplies the LaunchPad's 3.3 V: the LaunchPad has no
    5 V -> 3.3 V regulator on the target side (SPRUI77 Fig. 3/4), contrary
    to ARCHITECTURE.md section 3. Bench workaround JP1+JP2; rework wire U3
    tab -> J20.1; rev 4.1 ties J20.1 to +3V3.
    - F1 -> Q1 drain link is a 0.25 mm Default-class track; wire strap now,
    *PWR_24V_FUSED -> Power_3A in rev 4.1.
    Also corrects the Q1 assembly note (bare tab pad,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
2026-11-03 S12.6: phase paragraph -> boards built, bring-up A passed; S12 section 4 DTM13 -> DT15
    CLAUDE.md current-phase paragraph replaced (not extended): boards
    assembled, bring-up A passed, the three design defects and their
    reworks, next step = firmware section 13 then bring-up B-E.
    S12_FAB_PACKAGE.md: J3-J5 are the vertical DT15 headers (screw down
    before soldering), DT06 plugs with size-16 contacts and 114017 sealing
    plugs in the unused cavities.
2026-11-04 S12.6 bring-up board 1: A-C passed, D/E partial; module current zero is 0 V
    - VERIFIED_FACTS: new "Bench, board 1" section (A-E results, faults found);
    fault polarity bench-confirmed; internal sensor bias 0 V, not 2.5 V;
    module 15 V outputs (pins 9/27) read 0 V
    - OPEN_ITEMS: internal current path clips as built (LEM path for step F,
    per-channel re-bias rework + rev 4.1 fix); clamps on ISNS_x_ADC (rev 4.1);
    hand-soldered IC GND joints (U6, U16) and board-2 notes; remaining board-1
    bring-up checks; D12 and 3V3 wire done on board 1; firmware handoff
    section 13 applied (moved to Resolved)
    - S12 handoff, CLAUDE.md pin map: fault inversion is GPxINV, not the
    Input X-BAR; boot-time sp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
2026-11-05 S12.6 bring-up board 1: encoder fixed, F started, ADC interference; README
    Bench results of 2026-11-04/05 into the repo docs:
    - VERIFIED_FACTS: encoder fault (U17 pin 6 open, reflowed) and the
    after-fix numbers (installed encoder ~2.0 Vpp); bring-up F at a 31 V
    link (phase ID, resolver offset 106.6 deg, closed-loop current);
    ADC interference characterised (one ~1.6 MHz source on every input,
    lead suspect the LaunchPad's U12 boost, kill test deferred); Vbus
    ~4x low; XDS100 drops on encoder hot-plug. JP6 corrected: it links
    the boost's output, it is not USB 5 V.
    - OPEN_ITEMS: bring-up list updated; new ADC-interference and Vbus
    items; U17 pin 6 added to the hand-soldered joints;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
